Orpah/orpah-client-demo/docs/carrier-connections.md

# 载板连接表（= 原理图的「内容」✓）

> 用途：**画原理图之前先把它写死** ✓ —— 图上每条线都应当能在这张表里找到 ✓。
> 表里**只写「谁接谁」** ✗、**不写引脚号**：引脚号以 **Fritzing 部件**为准 ✓（抄两遍必然漂移 ✗）。
> 画完的核对口径 = **`tools/fzz_nets.py`** ✓（本仓台架那 5 张图就是这么逐网核的 ✓）。
> 状态：**草案** ✗（未上机）；标「待核」的**先查再画** ✓。
> 上游 = `carrier-board-spec.md` §2/§3/§4b-2 ✓。

## 1. 网络清单（画图时**照抄名字** ✓）

| 网络 | 含义 | 谁挂 |
|---|---|---|
| `3V3` | 主轨（前端稳压输出） | U1 的 `VDD`/`VDDA` ✓、U2 `VCC` ✓、D1 的限流电阻 ✓、I2C 上拉 R1/R2 ✓、J1（给模组）✓、J2（对外）✓、前端 `OUTPUT` ✓、前端 `EN`/`V_EN` ✓ |
| `GND` | 地 | 全部 ✓（含 U1 的**裸露焊盘 `VSS`** ✓ —— 部件里它**独立成网** ✗ ⇒ 画板时必须**特意连到 GND** ✓） |
| `VBAT` | 储能节点 | 前端 `BAT` ＋ BT1 正极 ✓ |
| `VBUS_IN` | 取能输入（光伏正极） | 前端 `INPUT` ＋ 预留取能接口 ✓ |
| `SDA` / `SCL` | I2C2 ↔ SE | U1 `PB11`/`PB10` ✓、U2 `pin5`/`pin6` ✓、R1/R2 上拉到 `3V3` ✓、J2（产线配 SE ✓） |
| `MOD_RX` / `MOD_TX` | MCU ↔ 模组 UART（HGIC 帧） | U1 `PA2`/`PA3` ✓ ↔ J1 ✓（**交叉**：MCU TX → 模组 RX ✓） |
| `CON_RX` / `CON_TX` | 控制台 `USART1` | U1 `PA9`/`PA10` ✓ ↔ J2 ✓ |
| `SWDIO` / `SWCLK` | SWD 烧录 | U1 `PA13`/`PA14` ✓ ↔ J3 ✓ |
| `LED_HB` | 心跳灯 | U1 `PA15` ✓ → R3 → D1 → `3V3` ✓（**低电平点亮** ✓） |
| `VBAT_OK` | 前端「储能可用」信号 | 前端 `V_OK` ✓ → U1 一只 GPIO ✓（**输入** ✓） |
| `VOUT_EN` | 前端 buck 使能 | **硬接 `3V3`（常开）** ✓ ⇒ ★ **别交给 MCU 关** ✗（MCU 自己吃这条轨 ⇒ 关了没人能再开 ✗，见 §3 第 4 条 ✓） |

## 2. 器件逐脚

### U1 = `CH32V203F8U6`（脚号/脚名照部件 `fritzing-parts-langhua/svg/CH32V203F8U6/part.CH32V203F8U6.fzp` ✓）
| 脚（功能名） | 接 | 备注 |
|---|---|---|
| `PA2` | `MOD_RX` → J1 ✓ | 模组数据口，HGIC 帧、115200 8N1 ✓ |
| `PA3` | `MOD_TX` ← J1 ✓ | 同上（**交叉** ✓） |
| `PA9` / `PA10` | `CON_TX` / `CON_RX` → J2 ✓ | 控制台 ✓ |
| `PB10` / `PB11` | `SCL` / `SDA` ✓ | `I2C2` ✓（★ 这个封装**没有 `I2C1`** ✗） |
| `PA13` / `PA14` | `SWDIO` / `SWCLK` → J3 ✓ | ★ **没有 `NRST`/`BOOT0`** ✗（复位 = 断电重上电 ✓） |
| ★ **心跳灯（要换脚 ✗）** | `LED_HB` ✓ | ★ 台架用 `PA15` ✓，但 **F8U6 封装上 `PA15` 没引出** ✗（2026-10-13 从部件 `.fzp` 的 21 只脚里读出来的 ✓）⇒ 载板**建议 `PB0`** ✓；**固件要跟着加"板档"开关** ✗（现在 `board.h` 写死 PA15 ✓） |
| ★ **用哪只脚：`PA0/WKUP`**（建议 ✓） | `VBAT_OK` ← 前端 ✓ | **输入** ✓；选它的额外好处 = 带 **WKUP** ✓（低功耗唤醒能用 ✓） |
| `VDD`（★ 部件里**只有一只** ✓ —— **没有单独的 `VDDA`** ✗） | `3V3` ✓ | ＋ **一只 100 nF 就近去耦** ✓（值待按手册核 ✗） |
| `VSS` ＋ 裸露焊盘 `VSS` | `GND` ✓ | 裸露焊盘**必须特意连** ✓ |

### U2 = `ATECC608B`（SOIC-8 ✓）
| 脚 | 接 | 备注 |
|---|---|---|
| `8 VCC` | `3V3` ✓ | ＋ 100 nF 去耦 ✗（**值待核** ✗） |
| `4 GND` | `GND` ✓ | |
| `5 SDA` / `6 SCL` | `SDA` / `SCL` ✓ | 开漏 ⇒ **必须有 4.7 k 上拉** ✓ |
| `1 / 2 / 3 / 7` | **不接** ✓ | |

### 其它
- **R1 / R2 = 4.7 kΩ**：`3V3` ↔ `SDA` / `SCL` ✓
- **R3 ＋ D1（心跳灯）**：`3V3` → R3（台架是 **10 kΩ** ✓）→ D1（蓝）→ `PA15` ✓
- **BT1 = 超级电容 5.5 V 组件**：正极 → `VBAT` ✓、负极 → `GND` ✓（★ **不装 CR2032/LIR2032** ✗）
- **J4 = 前端模块 `CJMCU-2557`**（排针 ✓，**丝印名照抄** ✓）：`INPUT`→`VBUS_IN` ✓、`GND`→`GND` ✓、
  `BAT`→`VBAT` ✓、`OUTPUT`→`3V3` ✓、`V_OK`→`VBAT_OK` ✓、`V_EN`→`3V3` ✓、`EN`→`3V3` ✓
- **J1 = 模组接口**（4 脚 ✓）：`1 = 3V3`、`2 = GND`、`3 = MOD_RX`、`4 = MOD_TX` ✓
  （第一版接 **TX-AH EVB 子板** ✓；**裸模块焊盘**留板上**不装** ✗）
- **J2 = 台架/产线排针**（6 脚 ✓）：`1 = 3V3`、`2 = GND`、`3 = SDA`、`4 = SCL`、`5 = CON_TX`、`6 = CON_RX` ✓
- **J3 = SWD**（4 脚 ✓）：`1 = 3V3`、`2 = GND`、`3 = SWDIO`、`4 = SWCLK` ✓

## 3. 画图/接线时必须照做的 5 条（都是踩过的 ✗）

1. **地要连成一片** ✓（台架踩过：`nano GND ↔ CH347F GND` 实测 **1.5 kΩ** ⇒ 虚接 ✗ ⇒ SE 永远 NACK ✗）；
2. **I2C 上拉不能省** ✓（4.7 k ×2 到 `3V3` ✓）；★ 台架上还并着 CH347F 的 `P5`（**两个主机一条总线** ✗）
   ⇒ **载板上不要**这种接法 ✗（真凶 ⑤ ✓）；
3. **模组轨就近去耦 ＋ 大电容** ✓：buck 只有 93～110 mA ⇒ 发射峰值**靠电容顶** ✗
   （容量 **等 F-11 §2b 量完再定** ✗）；
4. **`VOUT_EN` 硬接高** ✓（别交给 MCU ✗ —— 关了自己就死、没谁能再开 ✗）；
5. **裸露焊盘 `VSS` 特意连 GND** ✓（部件里它独立成网 ✗）。

## 4. 待核（画前必查 ✗）

- **裸模块**焊盘号 ↔ 台架丝印 `A10`/`A11` 的对应 ✓（第一版不用裸模块 ⇒ **不阻塞** ✓）；
- `U1` 的**电源脚个数**与去耦值 ✓（照数据手册 ＋ 本库部件 ✓）；
- `ATECC608B` 去耦值 ✓、`R3` 阻值 ✓；
- **`C_STORE` / 3V3 大电容**的容量 ✗（等 F-11 §2b ✓）；
- **`CJMCU-2557` 的 `VOUT` / `VBAT_OV` 实际设定** ✗（见 `carrier-board-spec.md` §4b-2 ✓）。

## 5. 在 Fritzing 里画（照着点 ✓）

★ **为什么这一步在 Fritzing 里点、不由我生成 `.fzz`** ✗：Fritzing 的 sketch 要求**每个元件/走线三视图都写全**
（本库实测 ✓：Fritzing 自己的 **4149** 条走线里 **4148** 条是三视图 ✓），而且**结构不合它口味就静默忽略** ✗
（记过：只有 `pcbView` 的 129 条走线**整组不被认** ✗）⇒ 脚本从零生成风险高 ✗；
而在 Fritzing 里**点两个脚就自动布线** ✓ ⇒ 手画反而快 ✓。
**我负责的半个 = 内容定死（本文）＋ 画完逐网核对** ✓。

**步骤**（约 15 分钟 ✓）
1. 新建 sketch ✓，切到 **原理图视图**（Schematic ✓）；
2. 从元件箱拖 3 个元件（**都在里面了** ✓ —— 2026-10-13 `tools/check_deploy.py` rc=0 ✓）：
   `CH32V203F8U6` ✓、`ATECC608B` ✓、`TX-AH-R900PNR`（接 EVB 子板时它是接口件 ✓）；
3. 再拖出：**4.7 k 电阻 ×2** ✓、**R3 ×1** ✓、**LED ×1** ✓、**BT1（超容/电池符号 ✓）×1** ✓、
   **排针 ×3**（`J1` 模组 / `J2` 台架产线 / `J3` SWD ✓）、**前端排针 ×1**（`CJMCU-2557` 用 ✓）、
   网标签若干（`NetLabel-Pad` ✓）；
4. **按 §1/§2 的表连线** ✓（自动布线即可 ✓；这只是原理图，线色不计较 ✓）；
5. ★ **别漏两条** ✗：① **U1 的裸鳲焊盘 `VSS` 单独连到 `GND`** ✓（部件里它独立成网 ✗）；
   ② **前端 `VOUT_EN`（丝印 `V_EN`）/ `EN` 直接接 `3V3`** ✓（**不接 MCU** ✓）；
6. 存成 **`hardware/carrier/carrier-board.fzz`** ✓（目录要建 ✓）；需要就同时导出 `.svg` ✓
   —— **README 要嵌图** ✓（AGENTS §9 ✓）；
7. **画完告诉我** ⇒ 我把它登记进 `tools/fzz_nets.py` 的期望表 ✓，然后按 §1/§2 **逐网核对** ✓
   （判定 = 一条命令、无 `MISSING`/`EXTRA` ✓；与台架那 5 张图同一口径 ✓）。

## 6. 项目数据模块（库仓那套工具用 ✓）

★ 载板的「项目数据」= **`hardware/carrier/carrier_nets.py`** ✓（2026-10-13 建 ✓）：
`NETS`（**15 张网**；脚名是**从 `.fzp` 读出来的真名** ✗ 不是猜的 ✓）、`POWER`、
`COLOR`（**只取官方 13 色** ✓ ⇒ 两张网必须共用 ✗）。

★ 有了它，库仓（`fritzing-parts-langhua/tools/`）那套通用工具**直接能用在载板上** ✓
（与像素板同一套 ✓）：
```
py -3.13 <库仓>\tools\check_netlist.py <草图.fzz> --nets=<本岔>\carrier_nets.py
py -3.13 <库仓>\tools\render_sch.py   <草图.fzz> <出图.png>
py -3.13 <库仓>\tools\sch_metrics.py  <草图.fzz>
py -3.13 <库仓>\tools\sch_straighten.py <草图.fzz> [--apply]
```
⚠ `EXPECT`（核对器的**期望表**）**待草图存在后再照 `pixel_nets.py` 的写法补** ✗ ——
现在补 = 凭空造一份期望 ✗（表要与图上真有的脚一一对得上才有意义 ✓）。

## 7. 画图管线（2026-10-13 查清：有现成的 ✓）

★ 结论：**不用我从零造** ✗ —— `F:\git\AuroraTessellation-NFC\hardware\pixel\` 里有一整条流水线 ✓
（用户 2026-10-13 把这个仓加进工作区才看见 ✓）：

| 步 | 工具 | 干什么 |
|---|---|---|
| ① 出脚位几何 | **库仓** `render_sch.py <草图.fzz> <出图> --pins-out pins_ref.py` ✓ | 吐 **`PINS[mi][cid]=(dx,dy)`**（各脚相对零件锚点 ✓）/ **`BOX[mi]`**（本体框 ✓）/ `LAB` ✓ —— ★ **对 Fritzing 自己导出验平 Δ≤0.0004 单位** ✓ ⇒ **脚位不用我自己解** ✓ |
| ② 自动摆位 | 项目侧 **`gen_schematic_layout3.py <源.fzz> <出.fzz> --pins pins_ref.py`** ✓ | 数据驱动摆位（本体居中 ✓、相邻脚同高 ✓、间隙 2 格 ✓）；**只碰 `schematicView`** ✓；`--by-bb` 可按面包板排布摆 ✓ |
| ③ 自动布线 | 项目侧 **`gen_schematic_wires.py`** ✓（9378 行 ✓、**开关很多** ✓） | 正交折线 ✓、电源轨 ✓、竖直车道 ✓、**网标签** ✓、**接地符号** ✓、抽出重排 ✓；闸门一堆（贴脚 0 ✓、跨网假接头 0 ✓、线↔线净距 ✓、本体闸门 ✓） |
| ④ 复核 | 库仓 `render_sch` / `sch_metrics` / `check_netlist` / `sch_straighten` ✓ | 出图 ＋ 判据 ✓、**独立**量尺 ✓、逐网核对 ✓、该横平竖直的线 ✓ |

★★ **唯一还缺的一步 = 造一份「含元件、零导线」的源草图** ✗ —— 上面 ②③ 都要求它先存在 ✓
（像素板那份是**在 Fritzing 里画的** ✓）⇒ **这一步由我脚本补上** ✓（用库件造实例 ✓），
然后 ②③④ 直接跑 ✓。

★ 已实测（2026-10-13 ✓）：拿台架草图跑 ① ⇒ **rc=0**，产出 4 件的 `PINS`/`BOX`/`LAB` ✓；
它自带的判据链同时报了「交叉 0 / 穿体 0 / 假接头 0 / 跨网擦身 0」✓（该图本来就没画原理图线 ✓）。

★ 布线器怎么搬过来 ✓：它**唯一项目专属的东西 = 文件顶部的 `NETS`** ✓ ⇒ 换成
`hardware/carrier/carrier_nets.py` 的 15 张网 ✓，其余开关用 CLI 调 ✓（`--ratio` 用
`render_sch` 出的尺子 = **1.0** ✓；对 Fritzing 导出的 svg 才是 1.25 ✓）。

## 8. 源草图生成器（2026-10-13 建 ✓：管线那唯一的缺口补上了 ✓）

**`hardware/carrier/carrier_board.py`** ✓ —— 造「**含元件、零导线**」的源草图 ✓：
- 骨架从**现成的台架草图**抄 ✓（只留它的 `<boards>` 与板框件 `PCB1` ✓，别的实例与全部悬空
  `<connects>` 一律删掉 ✓）⇒ Fritzing 要的外层结构是**它自己写的形状** ✓，不是我编的 ✗；
- 两趟摆位 ✓：① 粗摆（固定间距 ✓ 不必先知道尺寸 ✓）⇒ ② 跑库仓 `render_sch.py --pins-out`
  拿到**本体框** ✓ 再按 `GAP` 精摆 ✓（几何来自工具 ✓，不是我拍的数 ✓）。
  ★ `GAP` 现在是 **11 格 ≈ 22.4 mm** ✓（2026-10-14 逐档量出来的 ✓；它那条注释里记着
  **为什么从 2 → 4 → 6 → 12 → 11 格**，以及 **12 格 + 同 `--choffs` 也达标** 的对比 ✓）；
  ★★ **出交付件的整条命令**（含 `--choffs 7.3,12,22,34` 与 `--no-mst-merge --no-mst-shape`
  这两个**必须**的开关 ✓）写在 `carrier_board.py` 的**用法段**里 ✓ —— 以它为准 ✗，别凭记忆重建 ✗；
- 件一律用**库件** ✓；★ **核心件（Fritzing 自带）也能用** ✓，但 `path` **必须写绝对路径**
  （`…/Fritzing/fritzing-parts/core/<文件>.fzp` ✓）✗ —— 写成 Fritzing 内部记号
  `:/resources/parts/core/…` 我们的工具链**读不到** ✗（`part_measure.py` 明写：core 件不在 `.fzz` 里
  ⇒ 按实例给的**绝对路径**读它的 `.fzp` ✓）。实测：换绝对路径后 **17/17 全认** ✓。

**产物** ✓：`hardware/carrier/carrier-board.fzz`（**11 件 / 零导线** ✓，`render_sch --pins-out` rc=0 ✓）；
**交付件** = `hardware/carrier/carrier-schematic.{fzz,png,svg}` ✓（2026-10-14 定为 `c1` 版：
贴脚 1 / 交叉 54 / 拒画 0 / 导线重叠 0 / `check_netlist` ✓ 14/14 ✓）；
临时件在 `hardware/carrier/_work/`（不入库 ✓）。

**已解决** ✓：`D1` 改用核心件的 **SMD 0603 LED** ✓、`BT1` 改用核心件的 **goldcap（超容）** ✓
—— 都是真件 ✓，不再是占位 ✗。

**还差一样：4/6/7 脚的排针件** ✗（`J1`/`J3` 4 脚 ✓、`J2` 6 脚 ✓、`J4` 7 脚 ✓）：
- 库里没有 ✗；
- Fritzing 那只「**Pin Header**」是**运行时生成的泛用件** ✗ —— `fritzing-parts/core/` 里 **没有它的 `.fzp`** ✗
  （1781 个 fzp 里数过 ✓）⇒ **能用它的只有 Fritzing 自己** ✗，我们的工具链（`render_sch --pins-out`）
  **量不到它的脚** ✗ ⇒ 排版/布线/判据全断 ✗。
- ⇒ 两条出路 ✓：① **你在 Fritzing 里放好 4/6/7 脚 Pin Header 并另存** ✓（判据 = 存出来的 `.fzz` 里
  **多出** `part.*.fzp` ⇒ 说明它被打进包了 ✓ 我就能读 ✓）；② **我在库仓做一套「1×N 排针」件** ✓
  （一劳永逸 ✓，以后每块板都用得上 ✓；改公共元件库、按规矩先跟你对齐 ✓）。

**位号 0 个** ✗（渲染器报的）：我造的实例**没有 `<titleGeometry>`** ✓（Fritzing 自己的实例里有 ✓）
⇒ 交给布线器 ✓ 去摆 ✓（它的「布完线再摆一遍位号」**缺省就是开的** ✓，不另写一份 ✗）。
