Orpah/orpah-client-demo/hardware/carrier/carrier-pcb.png

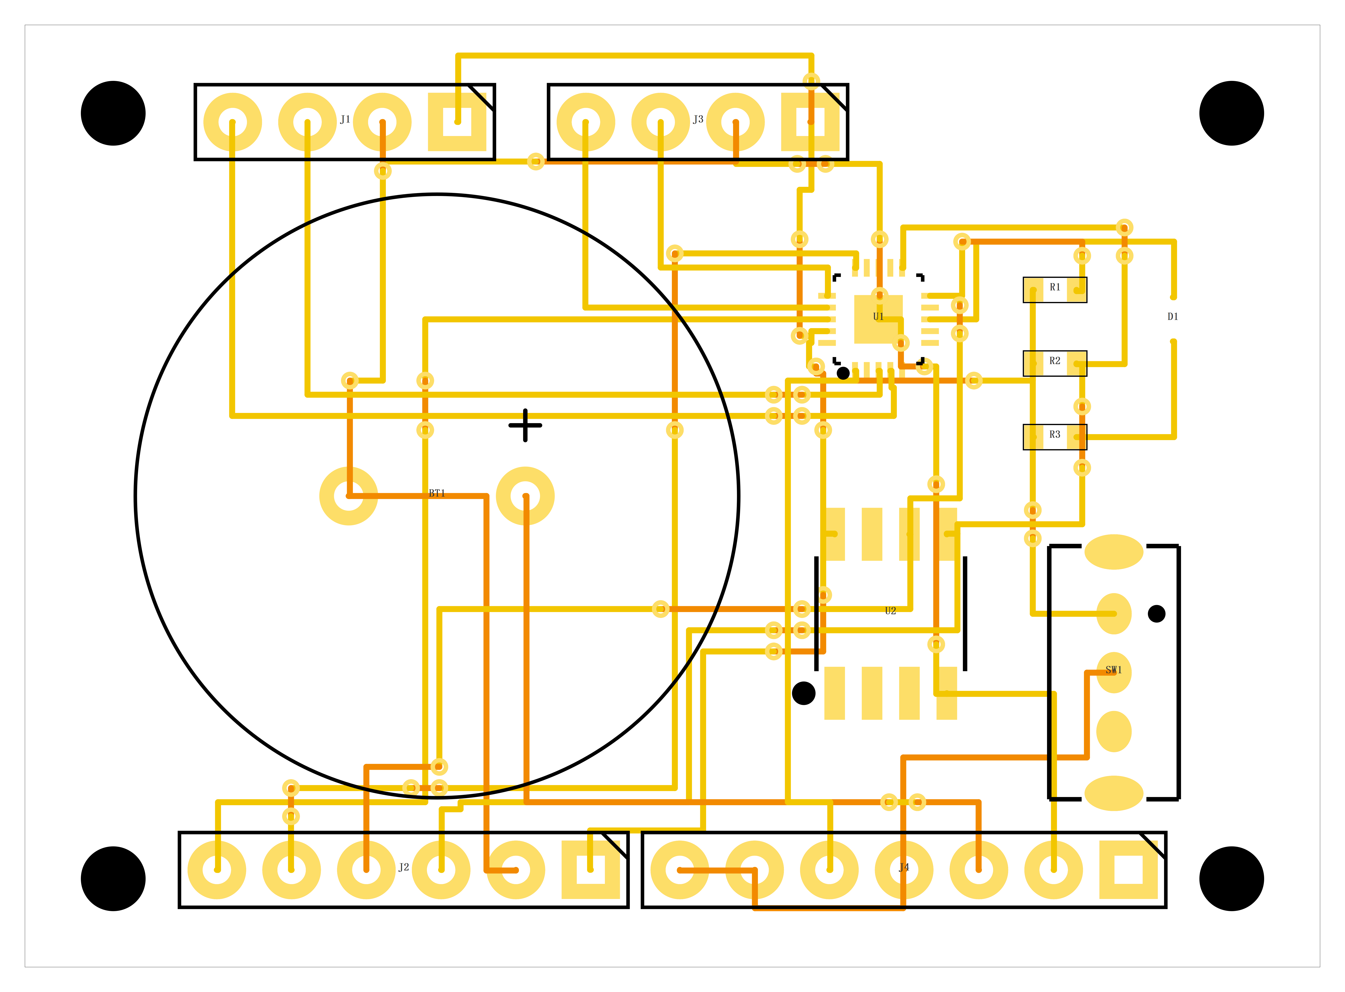
hardware/carrier/carrier-pcb.png
