Orpah/orpah-client-demo/hardware/carrier/carrier-schematic.png

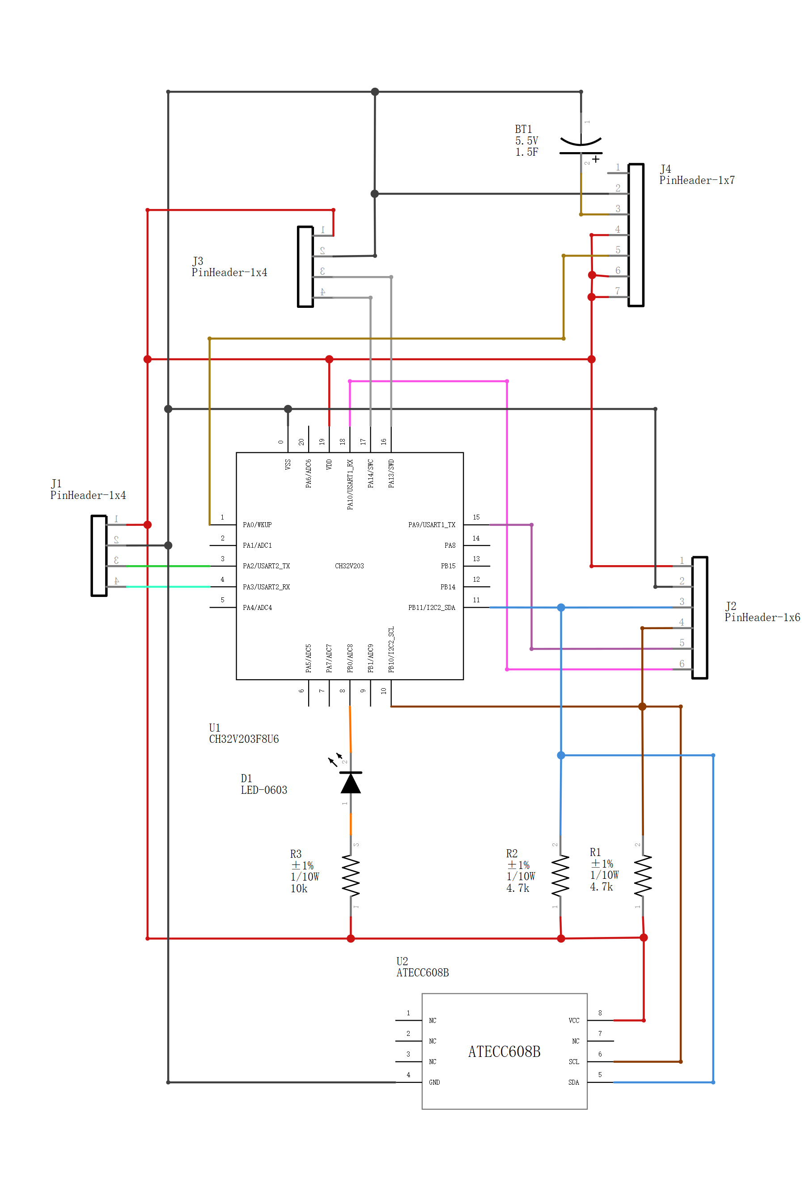
hardware/carrier/carrier-schematic.png
