Orpah/orpah-client-demo/proto/test_vectors_atecc.txt

# proto/test_vectors_atecc.txt —— 由 proto/run_cross_test.py --refresh 生成，**勿手改**
# 来源（单一源）：CryptoAuthLib `lib/calib/calib_command.h`（ATCA_RANDOM=0x1B、模式、包长）
#   + `lib/calib/calib_random.c`（响应的 count 检查）—— 我们那份摘要手册无命令集（需 NDA）
# 列：<kind><TAB><a1><TAB><a2><TAB><a3><TAB><out>
#   cmd  : a1=mode a2=with_crc(0/1) a3=-        out = 命令包-hex（count 在头、CRC 小端在尾）
#   resp : a1=完整响应-hex a2=a3=-              out = OK:<32B hex> | ERR:<码>
#     （ERR 码同 C 侧 ATECC_MSG_E_*：-2 = 长度/ count 不符、-3 = CRC 不符）
#   errpkt: a1=4字节包-hex a2=a3=-              out = 0x<状态>:<名字> | not-errpkt
#     （状态名 = `atecc_msg_status_name()`；两册逐字相同，措辞照 isATCAError()）
# 覆盖：两种模式 × 带/不带 CRC、响应 33/35 B（count **只占 1 字节**）、CRC 改一位、
#       长度截短、count 与长度矛盾、以及 4 字节错误包（含 2026-10-10 台架**实测**的
#       `04 11 33 43`（唤醒）与 `04 FF 01 42`（CRC/通讯错））
cmd	0	0	-	051b000000
cmd	0	1	-	071b00000024cd
cmd	1	0	-	051b010000
cmd	1	1	-	071b0100002747
resp	21000102030405060708090a0b0c0d0e0f101112131415161718191a1b1c1d1e1f	-	-	OK:000102030405060708090a0b0c0d0e0f101112131415161718191a1b1c1d1e1f
resp	23000102030405060708090a0b0c0d0e0f101112131415161718191a1b1c1d1e1f70fa	-	-	OK:000102030405060708090a0b0c0d0e0f101112131415161718191a1b1c1d1e1f
resp	23000102030405060708090a0b0c0d0e0f101112131415161718191a1b1c1d1e1f71fa	-	-	ERR:-3
resp	21000102030405060708090a0b0c0d0e0f101112131415161718191a1b1c1d1e	-	-	ERR:-2
resp	22000102030405060708090a0b0c0d0e0f101112131415161718191a1b1c1d1e1f	-	-	ERR:-2
errpkt	04113343	-	-	0x11:woke up
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
respsha	23000102030405060708090a0b0c0d0e0f101112131415161718191a1b1c1d1e1f71fa	-	-	ERR:-3
respsha	21000102030405060708090a0b0c0d0e0f101112131415161718191a1b1c1d1e	-	-	ERR:-2
respsha	22000102030405060708090a0b0c0d0e0f101112131415161718191a1b1c1d1e1f	-	-	ERR:-2
