Orpah/orpah-client-demo/proto/test_vectors_id_frame.txt

# proto/test_vectors_id_frame.txt —— 由 proto/run_cross_test.py --refresh 生成，**勿手改**
# 来源（单一源）：上游 Device.report() + build_id_report() + build_eth_frame()
#   （= 设备侧那条流水线的期望结果；C 侧同一份流水线在 proto/id_build.c，两侧共用）
# 列：<kind><TAB><sn><TAB><gen><TAB><mode><TAB><entropy><TAB><ctr><TAB><level><TAB><reason>
#     <TAB><frame-hex><TAB><firmware|->
#   mode = §8.2 故障注入（auto/sign_fail/se_fail/no_key）；nonce 由上面那张表的公式给
# 覆盖：L0/L1/L2/L3 四种级别 + 带与不带 firmware 字段
frame	CN-WH01-9AF3C1D2	1	auto	43981	1	0	normal	ffffffffffff4a065900000188b57b2276223a312c2274797065223a224f525041482d49442d5245504f5254222c227473223a302c22736e223a22434e2d574830312d3941463343314432222c227265706f7274223a7b22686472223a7b22747970223a226f727061682d69642d7265706f7274222c22766572223a312c22616c67223a224553323536222c226c6576656c223a307d2c227061796c6f6164223a7b22736e223a22434e2d574830312d3941463343314432222c227473223a302c226e6f6e6365223a223436363141313943443032423031323338324539463441373037463633414239222c227365656e5f726f7574657273223a5b5d2c22636170223a7b22727463223a66616c73657d7d2c22736967223a227477353662374a6457433766314a44504d48504f446b625354524552425342715379447061306f3971786e444363385f35714471687a686e78446132474c484e5f565f46324f5f576e4f716d4f3031336d515a5a6967227d7d	-
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
