Orpah/orpah-client-demo/proto/test_vectors_id_report.txt

# proto/test_vectors_id_report.txt —— 由 proto/run_cross_test.py --refresh 生成，**勿手改**
# 来源（单一源）：orpah_id.Device.report() + orpah_proto.encode_msg()/build_id_report()
# 列：<sn><TAB><ts><TAB><nonce><TAB><level><TAB><key-hex><TAB><battery|->
#     <TAB><caprtc|-><TAB><firmware|-><TAB><report-hex><TAB><envelope-hex>
#   ⚠ key-hex 的含义**按 level 分**：level 0 = P-256 私钥 d（32B 大端）；level 1/2 = HMAC 密钥；level 3 = -
#   ⚠ level 0 的签名用 **RFC 6979 确定性 k**（参考实现默认随机 k，那样两侧逐字节比不了）；
#     算法本身的独立证据 = RFC 6979 §A.2.5 官方向量 + OpenSSL 验签 + 上游 verify_report 接受
# 覆盖：level 0（ES256）/ level 1、2（HS256 降级链）/ level 3（none，不签名）/ 无 cap 与带 cap+battery+firmware
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
