Orpah/orpah-client-demo/proto/test_vectors_ecdsa.txt

# proto/test_vectors_ecdsa.txt —— 由 proto/run_cross_test.py --refresh 生成，**勿手改**
# 来源（单一源）：RFC 6979 §3.2 的 k（本仓 Python 侧第二实现）+
#                 OpenSSL（cryptography）算 k*G 得 r，s 用整数算术（都不经过本仓 C 代码）
# 列：<label><TAB><d><TAB><h1><TAB><k><TAB><r><TAB><s>（全部小写十六进制，除 label 外各 64 字符）
#   label 只是给人看的（RFC 那份夹具不同：那里 label 必须是消息本身）
#   h1    = 直接给哈希（32 B）—— 这样才构造得出 h1 >= n 的分支
#   覆盖：演示私钥（SN 派生）× 3 条消息、h1 边界（0/1/n-1/n/n+0x1234/0xff..ff）、
#         私钥边界（1/2/n-1）+ 定种子随机
# ⚠ 静态官方向量在 test_vectors_ecdsa_rfc6979.txt（**不由 --refresh 生成**，别删别改）
demo:CN-WH01-9AF3C1D2:1:sample	e0552315cc24f7f007f7e9541fc3dc7a91e88a1b39185b1bd5b49fa525c201af	af2bdbe1aa9b6ec1e2ade1d694f41fc71a831d0268e9891562113d8a62add1bf	c35010fa9c21ae5c5335ff0bfceab35c08ea7fc73c21c8361ee8e900d52da686	8056bfc5b52d800a5ae7d57af8971c6e8615b0381f817f159ecffb08e41c8def	5d3aa8e685efe9a7524efc9813672e0f93810f3814da584a89d4d1dc548c2915
demo:CN-WH01-9AF3C1D2:1:test	e0552315cc24f7f007f7e9541fc3dc7a91e88a1b39185b1bd5b49fa525c201af	9f86d081884c7d659a2feaa0c55ad015a3bf4f1b2b0b822cd15d6c15b0f00a08	963e2c44ce2e23debca4b20217aa46624e16f13a7c24e4272e54705d55f03d02	ff212b3ca0b54d5e920324d5f3974b66ee1eb49a2d05a8afec2c4c5d068d9ecf	3682545e8628b1d9e1004a1ebc2182fb0230d1e35d42aeea3ddbcb26d76bb9de
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
