Orpah/orpah-client-demo/proto/test_vectors_ecdsa_rfc6979.txt

# proto/test_vectors_ecdsa_rfc6979.txt —— ★ **静态夹具：不由 --refresh 生成，脚本不许改写它**
# 来源：RFC 6979 §A.2.5「ECDSA, 256 Bits (Prime Field)」（= NIST P-256）
#       2026-09-20 取自 https://www.rfc-editor.org/rfc/rfc6979.txt
# 列：<label>	<d>	<h1>	<k>	<r>	<s>   （全部小写十六进制，各 64 字符）
#   label = RFC 里的输入消息（UTF-8）⇒ **h1 必须等于 SHA-256(label 的 UTF-8 字节)**
#           （这一条由 run_cross_test.py 现算核对：抄错 message 也会被抓到）
#   d     = RFC 的私钥 x；它派生的公钥必须等于 RFC 的 Ux/Uy
#           Ux = 60fed4ba255a9d31c961eb74c6356d68c049b8923b61fa6ce669622e60f29fb6
#           Uy = 7903fe1008b8bc99a41ae9e95628bc64f2f1b20c2d7e9f5177a3c294d4462299
#   h1    = SHA-256(message)；qlen=256=hlen ⇒ bits2int 就是"按大端读成整数"，无截断
#   k     = RFC 6979 确定性派生出的 k；r/s = 该 k 下的签名
#
# 为什么**不能**由脚本生成（--refresh 会跳过它）：RFC 给的是确定性 k，而 OpenSSL 的
#   签名接口只吐随机 k 的签名（本机也没有 ecdsa 库）⇒ 这组只能手工录入。
# 那凭什么信它？三条**互相独立**的验证都过才允许改这张表（见 proto/README.md）：
#   ① OpenSSL 验签 (r,s) 通过（证明 r,s 真是 RFC 的值，不是抄串行）
#   ② k 由 (r,s) 反推 —— k = (h + d·r)·s⁻¹ mod n（签名方程保证唯一）——等于表中的 k
#   ③ 本仓**自己的** Python RFC 6979 实现也与表中 k 相等
#   （2026-09-20 实测：①②③ 对两行全部成立；本机没有 ecdsa 库，所以 ③ 是本仓自写的那份）
#
# ★ 注意 s **不是** low-s 归一化的（下面 "sample" 那条 s > n/2）⇒ 实现里**不许**对 s
#   做归一化，否则与官方夹具不一致。验签方本来就两种都接受。
sample	c9afa9d845ba75166b5c215767b1d6934e50c3db36e89b127b8a622b120f6721	af2bdbe1aa9b6ec1e2ade1d694f41fc71a831d0268e9891562113d8a62add1bf	a6e3c57dd01abe90086538398355dd4c3b17aa873382b0f24d6129493d8aad60	efd48b2aacb6a8fd1140dd9cd45e81d69d2c877b56aaf991c34d0ea84eaf3716	f7cb1c942d657c41d436c7a1b6e29f65f3e900dbb9aff4064dc4ab2f843acda8
test	c9afa9d845ba75166b5c215767b1d6934e50c3db36e89b127b8a622b120f6721	9f86d081884c7d659a2feaa0c55ad015a3bf4f1b2b0b822cd15d6c15b0f00a08	d16b6ae827f17175e040871a1c7ec3500192c4c92677336ec2537acaee0008e0	f1abb023518351cd71d881567b1ea663ed3efcf6c5132b354f28d3b0b7d38367	019f4113742a2b14bd25926b49c649155f267e60d3814b4c0cc84250e46f0083
