Orpah/orpah-client-demo/proto/test_vectors_p256.txt

# proto/test_vectors_p256.txt —— 由 proto/run_cross_test.py --refresh 生成，**勿手改**
# 来源（单一源）：上游 orpah_id.derive_demo_privkey(sn, gen) 的私钥 d
#                 + Python cryptography/OpenSSL 的 X962 未压缩公钥（04||X||Y）
# 列：<kind><TAB><a1><TAB><a2><TAB><d-hex><TAB><pub65-hex>
#   sn : a1=SN a2=gen —— d 由 C 自己按同式派生（这一列同时钉住派生规则）
#   d  : a1=d-hex（**不取模**，但必须 < 2^256 = 64 个十六进制字符）a2=-
#        覆盖 n-1（= -G）与 n+1 / n+0x1234（未归约的标量，ladder 要能吃）
# 为什么这样测：p/a/b/Gx/Gy/n、Montgomery 乘、点运算、标量乘 —— 任一处错，公钥就不同
sn	CN-WH01-9AF3C1D2	1	e0552315cc24f7f007f7e9541fc3dc7a91e88a1b39185b1bd5b49fa525c201af	04c929c768df1e0d53be4216a710077a734a4f9b87b6ae8fa73ec773105c84e5d566612da9b40df61ad0ebb096a2515d60e0e83c48f922dd7db6a4d453feefab49
sn	CN-AB01-00000001	1	a6b806a08cdb56384aa8767de55c9408eda94aa71bb0443fe8e58ff694525110	049637bf25e72dedde277412814bf15de539ba9d507bd591a423164ecab39bd082c3dfd4c0733dc7d1367bce696e81cdc8ae2272143e458e61b746c909f1581949
sn	CN-ZZ99-ZZZZZZZZ	1	dd08985a256d7be9e84aae896a566f84203a25e58743e9bd1aed139d84f8d9ce	0412f6c0510eaba29cf066281efbc811a70cd186eaddf8787bea50c553376257c3b778c8578a03bccf8b0d3d733460dd4fd6c9662836a3cd6852810f56845694b6
sn	CN-WH01-9AF3C1D2	2	bd4f7b866ca6f1f0ffaa13726e7937159b1ce983a9ab366443834d761e1c2bc0	042947e757bd8957a79ddf2c9cb68e28e312e1d361ae66fba5d4c11f2ebe64cad1804f401853b0020a49c6ff3d33e4b7b12b61a3276d92ec7e40d903a4745831f7
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
d	d715cb996dec0001404e321b300792a0119232201fd974f364bf76a2dde79c1a	-	d715cb996dec0001404e321b300792a0119232201fd974f364bf76a2dde79c1a	0447965ce2b2476ace9c90339d49388074b2cb80ac5c51d29749a0d89a910c3e688c46703a36c31600600ed807b09e16c5798b80b0d0fc2805233209bdb0a15349
