Orpah/orpah-client-demo/proto/test_vectors_hgic.txt

# proto/test_vectors_hgic.txt —— 由 proto/run_cross_test.py --refresh 生成，**勿手改**
# 来源（单一源）：**本仓** tools/txah_hgic.py（= 模组 SDK hgic.h/uart_bus.c + 真机实测）
# 列：<kind><TAB><a1><TAB><a2><TAB><a3><TAB><a4><TAB><a5><TAB><a6><TAB><frame-hex>
#   hdr : a1=magic(hex) a2=type a3=ifidx a4=flags a5=cookie a6=载荷-hex|-
#   frm2: a1=以太帧-hex|- a2=cookie a3..a6=-          （lean=True ⇒ FRM2）
#   cmd : a1=cmd_id a2=参数-hex|- a3=cookie a4..a6=-     （id>255 走 CMD2）
# 覆盖：长度上下界 8/4096、ifidx:4|flags:4 打包、cookie 0/32767、256 附近的 CMD↔CMD2 分界
hdr	1A2B	9	0	0	0	-	2b1a090008000000
hdr	1A2B	9	5	10	4660	-	2b1a095a08003412
hdr	2B1A	4	15	15	32767	aa55	1a2b04ff0a00ff7faa55
hdr	0000	0	1	2	1	00ff	000000120a00010000ff
hdr	1A2B	9	0	0	0	aaaaaaaaaaaaaaaaaaaaaaaaaaaaaaaaaaaaaaaaaaaaaaaaaaaaaaaaaaaaaaaaaaaaaaaaaaaaaaaaaaaaaaaaaaaaaaaaaaaaaaaaaaaaaaaaaaaaaaaaaaaaaaaaaaaaaaaaaaaaaaaaaaaaaaaaaaaaaaaaaaaaaaaaaaaaaaaaaaaaaaaaaaaaaaaaaaaaaaaaaaaaaaaaaaaaaaaaaaaaaaaaaaaaaaaaaaaaaaaaaaaaaaaaaaaaaaaaaaaaaaaaaaaaaaaaaaaaaaaaaaaaaaaaaaaaaaaaaaaaaaaaaaaaaaaaaaaaaaaaaaaaaaaaaaaaaaaaaaaaaaaaaaaaaaaaaaaaaaaaaaaaaaaaaaaaaaaaaaaaaaaaaaaaaaaaaaaaaaaaaaaaaaaaaaaaaaaaaaaaaaaaaaaaaaaaaaaaaaaaaaaaaaaaaaaaaaaaaaaaaaaaaaaaaaaaaaaaaaaaaaaaaaaaaaaaaaaaaaaaaaaaaaaaaaaaaaaaaaaaaaaaaaaaaaaaaaaaaaaaaaaaaaaaaaaaaaaaaaaaaaaaaaaaaaaaaaaaaaaaaaaaaaaaaaaaaaaaaaaaaaaaaaaaaaaaaaaaaaaaaaaaaaaaaaaaaaaaaaaaaaaaaaaaaaaaaaaaaaaaaaaaaaaaaaaaaaaaaaaaaaaaaaaaaaaaaaaaaaaaaaaaaaaaaaaaaaaaaaaaaaaaaaaaaaaaaaaaaaaaaaaaaaaaaaaaaaaaaaaaaaaaaaaaaaaaaaaaaaaaaaaaaaaaaaaaaaaaaaaaaaaaaaaaaaaaaaaaaaaaaaaaaaaaaaaaaaaaaaaaaaaaaaaaaaaaaaaaaaaaaaaaaaaaaaaaaaaaaaaaaaaaaaaaaaaaaaaaaaaaaaaaaaaaaaaaaaaaaaaaaaaaaaaaaaaaaaaaaaaaaaaaaaaaaaaaaaaaaaaaaaaaaaaaaaaaaaaaaaaaaaaaaaaaaaaaaaaaaaaaaaaaaaaaaaaaaaaaaaaaaaaaaaaaaaaaaaaaaaaaaaaaaaaaaaaaaaaaaaaaaaaaaaaaaaaaaaaaaaaaaaaaaaaaaaaaaaaaaaaaaaaaaaaaaaaaaaaaaaaaaaaaaaaaaaaaaaaaaaaaaaaaaaaaaaaaaaaaaaaaaaaaaaaaaaaaaaaaaaaaaaaaaaaaaaaaaaaaaaaaaaaaaaaaaaaaaaaaaaaaaaaaaaaaaaaaaaaaaaaaaaaaaaaaaaaaaaaaaaaaaaaaaaaaaaaaaaaaaaaaaaaaaaaaaaaaaaaaaaaaaaaaaaaaaaaaaaaaaaaaaaaaaaaaaaaaaaaaaaaaaaaaaaaaaaaaaaaaaaaaaaaaaaaaaaaaaaaaaaaaaaaaaaaaaaaaaaaaaaaaaaaaaaaaaaaaaaaaaaaaaaaaaaaaaaaaaaaaaaaaaaaaaaaaaaaaaaaaaaaaaaaaaaaaaaaaaaaaaaaaaaa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
cmd	108	-	0	-	-	-	2b1a03000c0000006c000000
cmd	43	-	7	-	-	-	2b1a03000c0007002b000000
cmd	108	0102	9	-	-	-	2b1a03000e0009006c0000000102
cmd	255	-	11	-	-	-	2b1a03000c000b00ff000000
cmd	256	-	12	-	-	-	2b1a0d000c000c0000010000
cmd	65535	aabbccdd	13	-	-	-	2b1a0d0010000d00ffff0000aabbccdd
