Orpah/orpah-client-demo/proto/test_vectors_hgic_ctrl.txt

# proto/test_vectors_hgic_ctrl.txt —— 由 proto/run_cross_test.py --refresh 生成，**勿手改**
# 来源（单一源）：**本仓** tools/txah_hgic.py 的 ctrl_info()
# 列：<type><TAB><from 0|1><TAB><载荷-hex><TAB><rc><TAB><kind><TAB><id><TAB><status><TAB><data-hex>
#   kind ∈ req|resp|'-'（rc≠0 时全为 -）；status = 十进制或 '-'（短应答无 status）
#   覆盖：带 status/len 的应答、短应答（只回 id）、请求、事件、CMD2/EVENT2、空载荷
3	1	6c000300aabbcc	0	resp	108	0	aabbcc
3	1	6c000300aabb	0	resp	108	-	-
3	1	6c	0	resp	108	-	-
3	1		-1	-	-	-	-
3	0	6c01020304	0	req	108	-	04
3	0	6c0102	0	req	108	-	-
4	1	0e01020304	0	resp	14	-	04
13	1	2c01000100bb	0	resp	300	0	bb
13	1	2c010300aa	0	resp	300	-	-
13	1	6c	-1	-	-	-	-
14	1	2c01ff	0	resp	300	-	-
9	1	aabb	0	resp	170	-	-
2	1	01	0	resp	1	-	-
