Orpah/orpah-client-demo/proto/test_vectors_hgic_parse.txt

# proto/test_vectors_hgic_parse.txt —— 由 proto/run_cross_test.py --refresh 生成，**勿手改**
# 来源（单一源）：**本仓** tools/txah_hgic.py 的 StreamParser.feed()
# 列：<expect><TAB><流-hex><TAB><chunk><TAB><frames><TAB><garbage><TAB><bad_length><TAB><overrun>
#   expect ∈ any|rx|tx（rx = 只收模组→主机，= Python 的 expect_from_module=True）
#   chunk  = 每次喂多少字节（0 = 一次喂完；1 = 逐字节）
#   frames = ';' 分隔的 <from>:<type>:<len>:<cookie>:<ifidx>:<flags>:<载荷hex|->（无帧 = -）
#   覆盖：逐字节喂、前置杂音、假 magic（长度非法）、截断、两种 magic 混流、方向过滤
#   ⚠ overrun 是 **C 独有**（Python 缓冲无上限），合法数据恒为 0 —— 收录它就是钉住“永不为 0 以外”
rx	1a2b09340c00050088b50102	0	1:9:12:5:3:4:88b50102	0	0	0
rx	1a2b09340c00050088b50102	1	1:9:12:5:3:4:88b50102	0	0	0
rx	1a2b09340c00050088b50102	3	1:9:12:5:3:4:88b50102	0	0	0
any	1a2b09340c00050088b501022b1a09001c0001000102030405060708090a0b0c0d0e0f1011121314	0	1:9:12:5:3:4:88b50102;0:9:28:1:0:0:0102030405060708090a0b0c0d0e0f1011121314	0	0	0
rx	1a2b09340c00050088b501022b1a09001c0001000102030405060708090a0b0c0d0e0f1011121314	0	1:9:12:5:3:4:88b50102	27	0	0
tx	1a2b09340c00050088b501022b1a09001c0001000102030405060708090a0b0c0d0e0f1011121314	0	0:9:28:1:0:0:0102030405060708090a0b0c0d0e0f1011121314	12	0	0
any	0102031a2b09340c00050088b50102	0	1:9:12:5:3:4:88b50102	3	0	0
any	2b1a0900070000001a2b09340c00050088b50102	0	1:9:12:5:3:4:88b50102	7	1	0
any	1a2b0934	0	-	0	0	0
any	2b1a03000c0002006d0000001a2b09340c00050088b5010200ff1a2b09340c00050088b50102	2	0:3:12:2:0:0:6d000000;1:9:12:5:3:4:88b50102;1:9:12:5:3:4:88b50102	2	0	0
any	2b	1	-	0	0	0
any		0	-	0	0	0
