Orpah/orpah-client-demo/proto/test_vectors_hmac.txt

# proto/test_vectors_hmac.txt —— 由 proto/run_cross_test.py --refresh 生成，**勿手改**
# 来源（单一源）：Python hmac.new(key, msg, hashlib.sha256).digest()
# 列：<key-hex><TAB><msg-hex><TAB><mac-hex>
# 覆盖：空键/空消息 / 键 32~(64)→ 超分组 65/128（**必须先哈希**）/ 消息跨块,
#       以及★**真实降级路径**：32B 演示 HMAC 密钥 × 真实签名预像（§5.1 的 HS256）
		b613679a0814d9ec772f95d778c35fc5ff1697c493715653c6c712144292c5ad
6b6579	54686520717569636b2062726f776e20666f78206a756d7073206f76657220746865206c617a7920646f67	f7bc83f430538424b13298e6aa6fb143ef4d59a14946175997479dbc2d1a3cd8
0708090a0b0c0d0e0f101112131415161718191a1b1c1d1e1f20212223242526		51559a0b1574b56b2d53e17824c397cba5e7a6b965873ee78043761d5a935db6
0708090a0b0c0d0e0f101112131415161718191a1b1c1d1e1f20212223242526	07	be890af04789f5d755fdccced065b07bbdabc32dd0ccfa975a6a6a26a6c545ed
0708090a0b0c0d0e0f101112131415161718191a1b1c1d1e1f20212223242526	0708090a0b0c0d0e0f101112131415161718191a1b1c1d1e1f202122232425262728292a2b2c2d2e2f303132333435363738393a3b3c3d	dfdbd06bdad85a02f472f7396d1819f8c96d9556509d26acd3f9312841b9df46
0708090a0b0c0d0e0f101112131415161718191a1b1c1d1e1f20212223242526	0708090a0b0c0d0e0f101112131415161718191a1b1c1d1e1f202122232425262728292a2b2c2d2e2f303132333435363738393a3b3c3d3e	eb86dd9ab368c51e25443624bebdfd8f9b1b29543bc7f3148042a4ef8dc188f6
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
370e2ece79fcb65a50eae8812d63ab4fb35d43510bae99e20b3ebca0c74a3e8b	7b22686472223a7b22616c67223a224553323536222c226c6576656c223a302c22747970223a226f727061682d69642d7265706f7274222c22766572223a317d2c227061796c6f6164223a7b22626174746572795f6d76223a333930302c22636170223a7b22727463223a66616c73657d2c226669726d77617265223a226334222c226e6f6e6365223a223346394138423243314434453546364137423843394430453146324133423443222c227365656e5f726f7574657273223a5b7b226273736964223a2241413a42423a43433a44443a45453a4646222c2272737369223a2d34322c2273736964223a224f5250414849445f5a4f4e455f41227d5d2c22736e223a22434e2d574830312d3941463343314432222c227473223a307d7d	b3e0bd17357701dee35be3d0f94562addf6f3b059ffab6a72adf730c4d385e23
