Orpah/orpah-client-demo/proto/test_vectors_sha256.txt

# proto/test_vectors_sha256.txt —— 由 proto/run_cross_test.py --refresh 生成，**勿手改**
# 来源（单一源）：Python hashlib.sha256()
# 列：<input-hex><TAB><digest-hex>   （空输入 = 行首就是 TAB）
# 覆盖：空 / 一个块边界 55/56/57/63/64/65/127/128 / 1000 字节 / 全零 128B,
#       以及**真实签名预像**（jcs({"hdr","payload"})，即 c4 要签的那串字节）
	e3b0c44298fc1c149afbf4c8996fb92427ae41e4649b934ca495991b7852b855
616263	ba7816bf8f01cfea414140de5dae2223b00361a396177a9cb410ff61f20015ad
6162636462636465636465666465666765666768666768696768696a68696a6b696a6b6c6a6b6c6d6b6c6d6e6c6d6e6f6d6e6f706e6f7071	248d6a61d20638b8e5c026930c3e6039a33ce45964ff2167f6ecedd419db06c1
000102030405060708090a0b0c0d0e0f101112131415161718191a1b1c1d1e1f202122232425262728292a2b2c2d2e2f303132333435363738393a3b3c3d3e3f404142434445464748494a4b4c4d4e4f505152535455565758595a5b5c5d5e5f606162636465666768696a6b6c6d6e6f707172737475767778797a7b7c7d7e7f808182838485868788898a8b8c8d8e8f909192939495969798999a9b9c9d9e9fa0a1a2a3a4a5a6a7a8a9aaabacadaeafb0b1b2b3b4b5b6b7b8b9babbbcbdbebfc0c1c2c3c4c5c6c7c8c9cacbcccdcecfd0d1d2d3d4d5d6d7d8d9dadbdcdddedfe0e1e2e3e4e5e6e7e8e9eaebecedeeeff0f1f2f3f4f5f6f7f8f9fafbfcfdfeff	40aff2e9d2d8922e47afd4648e6967497158785fbd1da870e7110266bf944880
030a11181f262d343b424950575e656c737a81888f969da4abb2b9c0c7ced5dce3eaf1f8040b121920272e353c434a51585f666d747b82	1deace58c745f3ecadde68a5923f494c3703fa73f0306483ccb898a5826e8d70
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
7b22686472223a7b22616c67223a224553323536222c226c6576656c223a302c22747970223a226f727061682d69642d7265706f7274222c22766572223a317d2c227061796c6f6164223a7b22626174746572795f6d76223a333930302c22636170223a7b22727463223a66616c73657d2c226669726d77617265223a226334222c226e6f6e6365223a223346394138423243314434453546364137423843394430453146324133423443222c227365656e5f726f7574657273223a5b7b226273736964223a2241413a42423a43433a44443a45453a4646222c2272737369223a2d34322c2273736964223a224f5250414849445f5a4f4e455f41227d5d2c22736e223a22434e2d574830312d3941463343314432222c227473223a307d7d	d24faa0788b583d5134a1879777da7d83ddc8a9847f16ab2b00f1ce83e716364
