Orpah/orpah-client-demo/proto/test_vectors_downlink.txt

# proto/test_vectors_downlink.txt —— 由 proto/run_cross_test.py --refresh 生成，**勿手改**
# 来源（单一源）：orpah_proto.decode_msg() + 设备侧取值习惯（client.py / DeviceSim.on_down）
# 列：<json-hex><TAB>valid<TAB>type<TAB>sn<TAB>ts<TAB>tracked<TAB>status<TAB>code
#   ⚠ 只收录“Python 也说无效”的无效用例（浮点/超 int64/嵌套过深 是 C 有意加严，
#     不入向量，边界见 proto/README.md）
7b2276223a312c2274797065223a224f525041482d4143434553532d494e464f222c227473223a313738393837393933392c22736e223a22434e2d574830312d3941463343314432222c22747261636b6564223a747275652c227365727665725f6f6b223a747275652c22737461747573223a22545241434b4544227d	1	ORPAH-ACCESS-INFO	CN-WH01-9AF3C1D2	1789879939	1	TRACKED	-
7b2276223a312c2274797065223a224f525041482d4143434553532d494e464f222c227473223a302c22736e223a22434e2d574830312d3941463343314432222c22747261636b6564223a66616c73652c227365727665725f6f6b223a747275657d	1	ORPAH-ACCESS-INFO	CN-WH01-9AF3C1D2	0	0	-	-
7b2276223a312c2274797065223a224f525041482d545241434b494e472d535441545553222c227473223a352c22736e223a22434e2d574830312d3941463343314432222c22737461747573223a224e4f542d545241434b4544222c226d7367223a226f6b227d	1	ORPAH-TRACKING-STATUS	CN-WH01-9AF3C1D2	5	-	NOT-TRACKED	-
7b2276223a312c2274797065223a224f525041482d4552524f52222c227473223a372c22736e223a22434e2d574830312d3941463343314432222c22636f6465223a22524154454c494d4954222c226d7367223a22736c6f77227d	1	ORPAH-ERROR	CN-WH01-9AF3C1D2	7	-	-	RATELIMIT
7b2276223a312c2274797065223a224f525041482d464f554e44222c227473223a307d	1	ORPAH-FOUND	-	0	-	-	-
6e6f74206a736f6e	0	-	-	-	-	-	-
5b5d	0	-	-	-	-	-	-
7b7d	0	-	-	-	-	-	-
7b2276223a312c2274797065223a224e4f5045222c227473223a307d	0	-	-	-	-	-	-
7b2276223a312c	0	-	-	-	-	-	-
7b2276223a312c2274797065223a224f525041482d4143434553532d494e464f222c227473223a312c22736e223a2258222c22747261636b6564223a226e6f227d	1	ORPAH-ACCESS-INFO	X	1	1	-	-
