Orpah/orpah-client-demo/proto/test_vectors_msg.txt

# proto/test_vectors_msg.txt —— 由 proto/run_cross_test.py --refresh 生成，**勿手改**
# 来源（单一源）：orpah_proto.build_*() + encode_msg()（**插入序**，不带 sort_keys，
#                  separators=(',',':')）—— 信封不是 JCS！
# 列：<kind><TAB><a1><TAB><a2><TAB><a3><TAB><a4><TAB><a5><TAB><envelope-hex>
#   req-connect : a1=sn a2=ts a3=mac|- a4=hw|- a5=-
#   report      : a1=sn a2=ts a3=seq a4=cap(-|0|1) a5=rssi|-
#   id-report   : a1=sn a2=ts a3..a5=-（内层用固定 stub，两侧一致）
req-connect	CN-WH01-9AF3C1D2	0	-	-	-	7b2276223a312c2274797065223a224f525041482d5245512d434f4e4e454354222c227473223a302c22736e223a22434e2d574830312d3941463343314432227d
req-connect	CN-WH01-9AF3C1D2	1789879939	4A:06:59:00:00:01	CH32V203+TX-AH	-	7b2276223a312c2274797065223a224f525041482d5245512d434f4e4e454354222c227473223a313738393837393933392c22736e223a22434e2d574830312d3941463343314432222c226d6163223a2234413a30363a35393a30303a30303a3031222c226877223a2243483332563230332b54582d4148227d
report	CN-WH01-9AF3C1D2	0	1	-	-	7b2276223a312c2274797065223a224f525041482d5245504f5254222c227473223a302c22736e223a22434e2d574830312d3941463343314432222c22736571223a317d
report	CN-WH01-9AF3C1D2	0	1	0	-55	7b2276223a312c2274797065223a224f525041482d5245504f5254222c227473223a302c22736e223a22434e2d574830312d3941463343314432222c22736571223a312c22636170223a7b22727463223a66616c73657d2c2272737369223a2d35357d
report	CN-WH01-9AF3C1D2	1789879939	7	1	-42	7b2276223a312c2274797065223a224f525041482d5245504f5254222c227473223a313738393837393933392c22736e223a22434e2d574830312d3941463343314432222c22736571223a372c22636170223a7b22727463223a747275657d2c2272737369223a2d34327d
report	CN-WH01-9AF3C1D2	0	2	-	-20	7b2276223a312c2274797065223a224f525041482d5245504f5254222c227473223a302c22736e223a22434e2d574830312d3941463343314432222c22736571223a322c2272737369223a2d32307d
id-report	CN-WH01-9AF3C1D2	0	-	-	-	7b2276223a312c2274797065223a224f525041482d49442d5245504f5254222c227473223a302c22736e223a22434e2d574830312d3941463343314432222c227265706f7274223a7b22686472223a7b22747970223a226f727061682d69642d7265706f7274222c22766572223a312c22616c67223a224553323536222c226c6576656c223a307d2c227061796c6f6164223a7b22736e223a22434e2d574830312d3941463343314432222c227473223a302c226e6f6e6365223a224141414141414141414141414141414141414141414141414141414141414141222c227365656e5f726f7574657273223a5b5d7d2c22736967223a2253545542227d7d
id-report	CN-WH01-9AF3C1D2	1789879939	-	-	-	7b2276223a312c2274797065223a224f525041482d49442d5245504f5254222c227473223a313738393837393933392c22736e223a22434e2d574830312d3941463343314432222c227265706f7274223a7b22686472223a7b22747970223a226f727061682d69642d7265706f7274222c22766572223a312c22616c67223a224553323536222c226c6576656c223a307d2c227061796c6f6164223a7b22736e223a22434e2d574830312d3941463343314432222c227473223a302c226e6f6e6365223a224141414141414141414141414141414141414141414141414141414141414141222c227365656e5f726f7574657273223a5b5d7d2c22736967223a2253545542227d7d
