Orpah/orpah-client-demo/proto/test_vectors_sn.txt

# proto/test_vectors_sn.txt —— 由 proto/run_cross_test.py --refresh 生成，**勿手改**
# 来源（单一源）：Python 参考实现 orpah-over-halow/orpah_id.py
# 列：ORG-UNIQUE<TAB>LUHN32<TAB>MOD97
# 说明：校验位只算 ORG-UNIQUE（不含 CC）—— 规范 §2 硬规则
WH01-9AF3C1D2	E	21
0	0	98
Z	1	90
2	W	92
7	J	77
T	B	11
V	9	05
000000000000	0	98
ZZZZZZZZ	8	48
wh01-9af3c1d2	E	71
WH01	Z	48
CA-0001	Y	17
AA-000-0000	2	96
H8WTPFWP18JYS74CGVB	A	81
ZYEMZPXETD29P	S	05
4KHBCEJCF5EH24Z	9	68
Y	3	93
VW5WRJDY4	4	23
1AYBZKW4KZ	V	49
H9	X	46
K56VQKV55DH9XGQB0VFN	5	79
3ZK0M34Q5515JENN	P	42
5DG6TW163JKCZ	Z	52
CZ4NG62	1	95
J3WQQPF	5	61
2KDZ74EVH	4	32
TKPQNY	8	64
ANKQJJFRDWJKE3W	6	98
XP	P	17
X9RB9NC6HSP7FS	D	24
HPY9AVW618YB7YA4	E	82
Q3	3	85
W4F0X77875E4B4CK8MDN	N	92
8NBX5YJ	V	72
9G5CB2DYBVRY3HPCY	B	20
8FHGTG736	C	16
BYQXP1015KX2TJ2HW	2	19
PDWB8R0M67DF7S2HN	3	18
19FFJD7P9NP1WHD932CW	A	97
FXRCYH	5	04
5PEJ267AQXKXH	X	19
VKAA2WBH	Q	38
EMFN2H4V2P8WE4JW	Y	89
8GMES	P	31
GDRVQZVBP4K0FYFQ	5	89
SMYJDK	7	93
D5JT8Q	B	34
1PAP	V	50
QATBE	B	97
HTQX7P55RW4PR7BGW5	B	54
9WKTDAZYV	S	63
16TB59BZ6	4	72
E22FH	C	27
DDH97G7QG1N8	1	91
YJNJCEW	N	51
EGFSNSVTBP	Z	15
VXZ	D	23
830JS74ZJPEK	F	44
WA947BRFYX	K	23
34922G75WSWE3S9B	R	59
8DPP0KJ	8	30
M4DXWEDKZN99BCHHXT	2	13
TZ60HQM14FCQ	E	13
