Orpah/orpah-client-demo/(list of files, drawings)

Other design files:
hardware/carrier/carrier-board.fzz
hardware/carrier/carrier-breadboard.fzz
hardware/carrier/carrier-pcb.fzz
hardware/carrier/carrier-schematic.fzz
hardware/wiring/bstep-ch347f-2txah-evb.fzz
hardware/wiring/bstep-ch347f-txah-evb-thrj45.fzz
hardware/wiring/bstep-ch347f-txah-evb.fzz
hardware/wiring/cstep-ch347f-atecc608b.fzz
hardware/wiring/cstep-ch347f-nanoch32-atecc608b.fzz
hardware/wiring/cstep-ch347f-nanoch32-i2ctest.fzz
hardware/wiring/cstep-ch347f-txah-evb-nanoch32-atecc608b.fzz
hardware/wiring/cstep-ch347f-txah-evb-nanoch32.fzz
hardware/wiring/cstep-nanoch32-atecc608b.fzz
