Orpah/orpah-client-demo/firmware/Core/id_core.c

/* id_core.c — 已签 ID 上报任务（固件侧策略；流水线本体在 proto/id_build.c）。*/
#include "id_core.h"

#include "atecc.h"
#include "id_build.h"
#include "id_level.h"
#include "hgic_uart.h"
#include "uart.h"
#include "board.h"

/* 主循环的 1 ms 时基（`Core/main.c` 定义）。⚠ 只用来**量** build 耗时：
 * 不读它的话（比如拿 `idc_*` 的入参 `now_ms` 去减）差恒为 0 —— 实测踩过：
 * 输出里 `build_ms=0` 看着"很快"，而真机上 ES256 是**秒级**（假数字比没数字更坏）。*/
extern volatile uint32_t g_tick_ms;

/* ------------------------------------------------------------------ */
/* 静态状态（RAM 紧：一律 static，别放栈上）                              */
/* ------------------------------------------------------------------ */
static jcs_ctx_t s_jc;
static idb_t     s_b;
static char      s_rep[IDC_REPORT_CAP];
static char      s_env[IDC_ENV_CAP];
static char      s_frame[IDC_FRAME_CAP];

static uint32_t  s_boot_entropy;     /* 上电熵（`id` 里打出来，便于看撞没撞）*/
static char      s_mode[12];        /* §8.2 故障注入模式（auto/sign_fail/se_fail/no_key）*/
static uint32_t  s_next_due;        /* 下一个发送时刻（ms 时基）*/
static uint32_t  s_last_sent;       /* 上次真正发出的时刻*/
static uint8_t   s_have_sent;       /* 发过一次没有（第一次不受自限频约束）*/
static uint32_t  s_sent;            /* 真正发出去的条数*/
static uint32_t  s_held;            /* 被自限频**延后**的次数（不是丢弃）*/
static uint32_t  s_build_fail;      /* 组装失败次数*/
static uint32_t  s_tx_fail;         /* 交给模组失败次数*/
static int       s_ready;

static const char *s_last_why = "-";

/* ------------------------------------------------------------------ */
/* 工具（ASCII 输出；控制台代码页可能是 GBK）                            */
/* ------------------------------------------------------------------ */
static void print_hex_line(const char *p, size_t n)
{
    static const char H[] = "0123456789abcdef";
    size_t i;

    for (i = 0; i < n; i++) {
        char b[3];

        b[0] = H[((unsigned char)p[i] >> 4) & 0x0Fu];
        b[1] = H[(unsigned char)p[i] & 0x0Fu];
        b[2] = '\0';
        uart_printf(CONSOLE_UART, "%s", b);
        if ((i % 32u) == 31u) {
            uart_printf(CONSOLE_UART, "\r\n");
        }
    }
    uart_printf(CONSOLE_UART, "\r\n");
}

static int str_eq(const char *a, const char *b)
{
    while (*a != '\0' && *a == *b) { a++; b++; }
    return (*a == '\0' && *b == '\0');
}

static int str_prefix(const char *s, const char *pre)
{
    while (*pre != '\0') {
        if (*s != *pre) { return 0; }
        s++; pre++;
    }
    return 1;
}

/* §8.2 的输入：`se_ok` = “**能不能做 ES256 签名**”。
 * ★★ d 步（2026-10-11）：装上了 SE 签名器（`Periph/atecc.c` 的 `atecc_sign_any()`）
 *   ⇒ 这里如实回“真 SE 在前”。✗ 没接/没探到时回 0（那时 level=0 走的是**软件替身** ——
 *   口径同 §8.2：软件替身属**演示级**，别当成“SE 在签”✗）。*/
static int _se_ok(void)
{
    return (s_b.sign_fn != 0) ? 1 : 0;
}

/* ------------------------------------------------------------------ */
/* 组装 + 发送                                                          */
/* ------------------------------------------------------------------ */
static int idc_build_and_send(uint32_t now_ms, const char *why)
{
    size_t flen = 0u;
    int level = -1;
    const char *reason = 0;
    uint32_t t0, dt;
    int rc, tx;

    t0 = now_ms;
    rc = idb_build(&s_b, s_mode, &flen, &level, &reason);
    /* ← 重读时基：`now_ms` 是入参、全程不变，拿它减自己恒得 0（实测踩过这个假测量）。
     * `dt == 0` 就是"不足 1 ms"（比如 level=3 不签名），**不要兜底成 1**。*/
    dt = g_tick_ms - t0;
    if (rc != 0) {
        s_build_fail++;
        uart_printf(CONSOLE_UART, "\r\n[id] build FAILED err=%d idr_rc=%d mode=%s\r\n",
                    s_b.last_err, s_b.last_idr_rc, s_mode);
        return 0;
    }
    tx = hgic_uart_send_frm2((const uint8_t *)s_frame, flen);
    if (tx < 0) {
        s_tx_fail++;
        uart_printf(CONSOLE_UART, "\r\n[id] tx FAILED rc=%d (frame %u B)\r\n",
                    tx, (unsigned)flen);
        return 0;
    }
    s_sent++;
    s_last_sent = now_ms;
    s_have_sent = 1u;
    s_last_why = reason;
    uart_printf(CONSOLE_UART, "\r\n[id] sent level=%d alg=%s why=%s nonce=%s len=%u"
                              " build_ms=%u (%s)\r\n",
                level, (level == 0) ? "ES256" : (level == 3) ? "none" : "HS256",
                reason, s_b.last_nonce, (unsigned)flen, (unsigned)dt, why);
    return 1;
}

int idc_tick(uint32_t now_ms)
{
    if (!s_ready) {
        return 0;
    }
    /* 环绕安全：用"差距"判断，不直接比大小 */
    if ((int32_t)(now_ms - s_next_due) < 0) {
        return 0;
    }
    s_next_due = now_ms + IDC_INTERVAL_MS;
    return idc_build_and_send(now_ms, "periodic");
}

/* ------------------------------------------------------------------ */
/* 初始化                                                              */
/* ------------------------------------------------------------------ */
/* ★ d 步（2026-10-11 上机）：SE 可用吗 —— 记住它。
 *   为什么要记：nonce/签名两个 provider 都是**注入**进 `idb_t` 的 ⇒
 *   “换 SN 重建流水线”会把它们丢掉 ✗ ⇒ 重建后必须按这个标志**重新装上** ✓。*/
static int s_se_ok;

/* 按当前 SE 状态把两个 provider 装回去（单一源：初始化与“换 SN”都调它 ✓）*/
static void _install_providers(void)
{
    if (!s_se_ok) {
        return;
    }
    idb_set_nonce_fn(&s_b, atecc_nonce_hex, 0);
    /* ★★ 按算法分流：ES256 ⇒ SE 的 `Sign(0x41)`（slot 0）/ HS256 ⇒ SE 内 `SHA` HMAC（slot 4）
     * ⇒ `idb_t.ec` / `idb_t.hmac` 那两份**演示材料都不再参与**（两把真钥都在芯片里 ✓）*/
    idb_set_sign_fn(&s_b, atecc_sign_any, 0);
}

/* 用 `sn` 重建流水线（并把 provider 装回去 ✓）。返回 `idb_init` 的 rc。
 * ★ 为什么需要它：固件缺省用的 SN 得是**桌上那颗真片**的，否则帧里的 SN 与
 *   “库里登记的钥”对不上 ⇒ 上游必然 `signature_invalid` ✗（尺子对不上号 ✓）。
 *   `idsn <SN>` 就是把这个缺口补上（**不用为每颗芯片重烧固件** ✓）。*/
static int _reinit_with_sn(const char *sn)
{
    int rc = idb_init(&s_b, &s_jc, s_rep, sizeof(s_rep), s_env, sizeof(s_env),
                      s_frame, sizeof(s_frame), sn, IDC_GEN_DEFAULT,
                      IDC_FW_VERSION, 0, s_boot_entropy);

    if (rc != 0) {
        uart_printf(CONSOLE_UART, "[id] init FAILED rc=%d\r\n", rc);
        return rc;
    }
    _install_providers();
    return 0;
}

int idc_init(uint32_t boot_entropy)
{
    int rc;

    s_boot_entropy = boot_entropy;
    rc = _reinit_with_sn(IDC_SN_DEFAULT);
    if (rc != 0) {
        return rc;
    }
    /* 默认 auto（= §8.2 全正常 → L0）；故障注入靠控制台 `idlevel` */
    {
        const char *m = idl_mode_name(0);

        s_mode[0] = (m != 0) ? m[0] : 'a';
        {
            int i = 1;

            while (m != 0 && m[i] != '\0' && i < (int)sizeof(s_mode) - 1) {
                s_mode[i] = m[i];
                i++;
            }
            s_mode[i] = '\0';
        }
    }
    s_next_due = IDC_INTERVAL_MS;      /* 上电后先走完一个周期再发第一条（给人看横幅的时间）*/
    s_last_sent = 0u;
    s_have_sent = 0u;
    /* ★ c4-γ-2：nonce 优先用 ATECC608B 的 RNG（规范 §5.4 要求的就是它）；
     *   没接/没应答则**如实回退**到软熵后端，并在 `id`/`se` 里打出用的是哪个。*/
    {
        int se = atecc_init();

        if (se == 0) {
            atecc_stats_t st;

            s_se_ok = 1;
            _install_providers();
            atecc_stats(&st);
            uart_printf(CONSOLE_UART,
                        "[id] nonce <- ATECC608B Random(0x1B) 32B (crc_mode=%s)\r\n",
                        (st.crc_mode == 0u) ? "no-crc(响应 33 B)" :
                        (st.crc_mode == 1u) ? "crc(响应 35 B)" : "unknown");
            uart_printf(CONSOLE_UART,
                        "[id] ES256 sign <- ATECC608B Sign(0x41) slot %u（私钥不出芯片 ✓）\r\n",
                        (unsigned)ATECC_SIGN_SLOT);
            uart_printf(CONSOLE_UART,
                        "[id] HS256 sign <- ATECC608B SHA HMAC slot %u（降级钥也不出芯片 ✓）\r\n",
                        (unsigned)ATECC_HMAC_SLOT);
        } else {
            uart_printf(CONSOLE_UART,
                        "[id] nonce <- soft entropy (SE 无应答 rc=%d；见 docs/atecc608b-se.md)\r\n",
                        se);
            uart_printf(CONSOLE_UART,
                        "[id] sign  <- **软件替身**（ES256/HS256 都走它；演示级 ✗；规范 §6 要的是 SE 里签）\r\n");
        }
    }
    s_ready = 1;
    (void)_se_ok();
    return 0;
}

/* ------------------------------------------------------------------ */
/* 控制台                                                              */
/* ------------------------------------------------------------------ */
static void cmd_status(void)
{
    uart_printf(CONSOLE_UART, "\r\n[id] sn=%s gen=%d fw=%s\r\n",
                s_b.sn, s_b.gen, (s_b.firmware != 0) ? s_b.firmware : "-");
    uart_printf(CONSOLE_UART, "[id] se=%s\r\n",
                _se_ok() ? "ATECC608B (槽 0 签 ES256 / 槽 4 出 HS256，两把钥都不出芯片)" :
                           "stand-in(software P-256, 演示级 ✗)");
    /* ★ nonce 来源（c4-γ-2）：规范 §5.4 要求 ATECC608B 的 RNG；没接则如实标 soft。
     * ★ d 步：**签名来源**同一套口径（`sign_src`）—— 这两件事必须分开说，
     *   别合并成一句“已启用 SE”✗。*/
    uart_printf(CONSOLE_UART, "[id] nonce_src=%s sign_src=%s\r\n",
                (s_b.last_nonce_src != 0) ? s_b.last_nonce_src : "-",
                (s_b.last_sign_src != 0) ? s_b.last_sign_src : "-");
    uart_printf(CONSOLE_UART, "[id] mode=%s  interval=%u ms  min_gap=%u ms\r\n",
                s_mode, (unsigned)IDC_INTERVAL_MS, (unsigned)IDC_MIN_GAP_MS);
    uart_printf(CONSOLE_UART, "[id] last_level=%d why=%s nonce=%s frame_len=%u\r\n",
                s_b.last_level, (s_last_why != 0) ? s_last_why : "-",
                (s_b.last_nonce[0] != '\0') ? s_b.last_nonce : "-",
                (unsigned)s_b.last_frame_len);
    uart_printf(CONSOLE_UART, "[id] built=%u sent=%u held=%u build_fail=%u tx_fail=%u"
                              " fell_back=%u\r\n",
                (unsigned)s_b.built, (unsigned)s_sent, (unsigned)s_held,
                (unsigned)s_build_fail, (unsigned)s_tx_fail, (unsigned)s_b.fell_back);
    /* ★★ d 步：两种签名各自进了 SE 几次 —— **分开报** ✗（合成一个数就分不出
     *   “ES256 在芯片里签的”和“HS256 在芯片里算的” ✓）。
     *   上机时一眼就能确认 `idlevel l1` 后 HS256 是否真走 SE（ok 应 +1 ✓）。*/
    {
        atecc_stats_t st;

        atecc_stats(&st);
        uart_printf(CONSOLE_UART,
                    "[id] se_hits: ES256 slot %u ok=%u fail=%u / HS256 slot %u ok=%u fail=%u\r\n",
                    (unsigned)ATECC_SIGN_SLOT, (unsigned)st.sign_ok, (unsigned)st.sign_fail,
                    (unsigned)ATECC_HMAC_SLOT, (unsigned)st.hmac_ok, (unsigned)st.hmac_fail);
    }
    /* ★★ SHA/HMAC 的时序旋钮（`setime` 可改 ✓）—— 放在状态里，好让现场确认“这次跑的是哪组参数” ✓ */
    {
        int poll, wake;
        uint32_t ready, gap, rgap, rst;

        atecc_sha_timing_get(&poll, &ready, &gap, &rgap, &rst, &wake);
        uart_printf(CONSOLE_UART,
                    "[id] sha timing: poll=%d ready_ms=%u gap_ms=%u restart_gap_ms=%u restarts=%u"
                    " wake_each=%d（setime 可改 ✓）\r\n",
                    poll, (unsigned)ready, (unsigned)gap, (unsigned)rgap, (unsigned)rst, wake);
    }
    /* ⚠ 如实：软熵后端只保证"同一 boot 内不重复"。**跨 boot 若上电熵撞了，整段 nonce 会重**
     *   ⇒ 服务端按重放丢弃（= 漏报）。把这个值打出来，好让人一眼看出撞了没。*/
    uart_printf(CONSOLE_UART, "[id] boot_entropy=0x%08x (soft; 跨 boot 撞了整段 nonce 会重)\r\n",
                (unsigned)s_boot_entropy);
    uart_printf(CONSOLE_UART, "[id] ts=0 cap.rtc=false (no RTC); battery_mv not written\r\n");
}

static void cmd_modes(void)
{
    int i;

    uart_printf(CONSOLE_UART, "[id] modes(§8.2 故障注入 -> 级别): ");
    for (i = 0; i < IDL_MODE_COUNT; i++) {
        int se = 1, sg = 1, hm = 1;
        const char *why = "-";

        (void)idl_mode_inputs(idl_mode_name(i), &se, &sg, &hm);
        uart_printf(CONSOLE_UART, "%s->L%d ", idl_mode_name(i), idl_pick(se, sg, hm, &why));
    }
    uart_printf(CONSOLE_UART, "\r\n");
}

int idc_console(const char *cmd, uint32_t now_ms)
{
    if (str_eq(cmd, "id")) {
        cmd_status();
        return 1;
    }
    if (str_eq(cmd, "idsend")) {
        if (s_have_sent && (uint32_t)(now_ms - s_last_sent) < IDC_MIN_GAP_MS) {
            /* §5.8 设备侧：**延后，不丢弃**（丢自己的业务报 = 漏报）*/
            s_held++;
            uart_printf(CONSOLE_UART, "\r\n[id] held (self-limit): next in %u ms\r\n",
                        (unsigned)(IDC_MIN_GAP_MS - (now_ms - s_last_sent)));
            return 1;
        }
        if (!idc_build_and_send(now_ms, "console")) {
            uart_printf(CONSOLE_UART, "[id] send FAILED (see above)\r\n");
        }
        return 1;
    }
    if (str_eq(cmd, "idhex")) {
        if (s_b.last_frame_len == 0u) {
            uart_printf(CONSOLE_UART, "\r\n[id] no frame yet (try idsend)\r\n");
            return 1;
        }
        uart_printf(CONSOLE_UART, "\r\n[id] last frame %u B (paste into"
                                  " tools/check_report_hex.py on the PC):\r\n",
                    (unsigned)s_b.last_frame_len);
        print_hex_line(s_frame, (size_t)s_b.last_frame_len);
        return 1;
    }
    if (str_eq(cmd, "idmodes")) {
        cmd_modes();
        return 1;
    }
    /* ★★ d 步（2026-10-11 上机）：`idsn <SN>` —— 把流水线的 SN 换成**桌上那颗真片**的。
     *   为什么必须能换：入库的每一颗 SE 各有自己的 SN，而帧里的 SN 是上游查钥的**钥匙** ⇒
     *   SN 不对 ⇒ 库里的真钥用不上 ⇒ 只能拿演示钥去验 ⇒ 必然 `signature_invalid` ✗。
     *   有了它，换一颗芯片只要敲一行（**不用重烧** ✓）。
     *   ⚠ 重建会把计数器（built/sent）与 last_* 一起清零 —— 这是重建的正常代价 ✓。*/
    if (str_prefix(cmd, "idsn")) {
        const char *arg = cmd + 4;

        while (*arg == ' ') { arg++; }
        if (*arg == '\0') {
            uart_printf(CONSOLE_UART, "\r\n[id] sn=%s（用法：idsn <SN>）\r\n", s_b.sn);
            return 1;
        }
        if (_reinit_with_sn(arg) != 0) {
            uart_printf(CONSOLE_UART, "[id] idsn 失败（SN 非法？参看上游 sn.h 的规则）\r\n");
            return 1;
        }
        uart_printf(CONSOLE_UART, "\r\n[id] sn <- %s（流水线已按新 SN 重建；两个 provider 已重装 ✓）\r\n",
                    s_b.sn);
        return 1;
    }
    if (str_eq(cmd, "se")) {
        /* c4-γ-2 现场判据：唤醒 + 一条 `Random(0x1B)`（把 count/CRC 模式/随机数打出来）*/
        atecc_selftest();
        return 1;
    }
    if (str_prefix(cmd, "idlevel")) {
        int se = 1, sg = 1, hm = 1;
        const char *why = "-";
        const char *arg = cmd + 7;
        int lvl;

        while (*arg == ' ') { arg++; }
        if (*arg == '\0') {
            cmd_modes();
            return 1;
        }
        if (idl_mode_inputs(arg, &se, &sg, &hm) != 0) {
            uart_printf(CONSOLE_UART, "\r\n[id] unknown mode: %s (idmodes)\r\n", arg);
            return 1;
        }
        /* 存模式名（照抄上游 LEVEL_MODES 的那几个字符串）*/
        {
            int i = 0;

            while (arg[i] != '\0' && i < (int)sizeof(s_mode) - 1) {
                s_mode[i] = arg[i];
                i++;
            }
            s_mode[i] = '\0';
        }
        lvl = idl_pick(se, sg, hm, &why);
        uart_printf(CONSOLE_UART, "\r\n[id] mode=%s -> L%d (%s)\r\n", s_mode, lvl, why);
        return 1;
    }
    /* ★★ 2026-10-11 深夜（上机扫时序）：`setime [<poll> [<ready_ms> [<gap_ms> [<restart_gap_ms> [<restarts>]]]]]`
     *   为什么做成控制台可调 ✗：SHA/HMAC 的“就绪等待 / 命令间间隔 / 要不要探地址 / 重来间隔与次数”
     *   要试好几个组合，而每次试都要重新烧固件 ⇒ 一轮几分钟；做成旋钮后
     *   **烧一次、之后每轮只要敲一行** ✓。不带参数就只打印当前值 ✓。*/
    if (str_prefix(cmd, "setime")) {
        const char *arg = cmd + 6;
        long v[6];
        int n = 0;

        while (n < 6) {
            long x = 0;
            int got = 0;

            while (*arg == ' ') { arg++; }
            while (*arg >= '0' && *arg <= '9') {
                x = x * 10 + (long)(*arg - '0');
                got = 1;
                arg++;
            }
            if (!got) { break; }
            v[n++] = x;
        }
        if (n >= 1) {
            int poll, wake;
            uint32_t ready, gap, rgap, rst;

            atecc_sha_timing_get(&poll, &ready, &gap, &rgap, &rst, &wake);
            poll = (int)v[0];
            if (n >= 2) { ready = (uint32_t)v[1]; }
            if (n >= 3) { gap = (uint32_t)v[2]; }
            if (n >= 4) { rgap = (uint32_t)v[3]; }
            if (n >= 5) { rst = (uint32_t)v[4]; }
            if (n >= 6) { wake = (int)v[5]; }
            atecc_sha_timing_set(poll, ready, gap, rgap, rst, wake);
        }
        {
            int poll, wake;
            uint32_t ready, gap, rgap, rst;

            atecc_sha_timing_get(&poll, &ready, &gap, &rgap, &rst, &wake);
            uart_printf(CONSOLE_UART,
                        "\r\n[id] sha timing: poll=%d ready_ms=%u gap_ms=%u restart_gap_ms=%u"
                        " restarts=%u wake_each=%d\r\n"
                        "     （用法：setime <poll 0|1> <ready_ms> <gap_ms> <restart_gap_ms>"
                        " <restarts> <wake_each 0|1>）\r\n",
                        poll, (unsigned)ready, (unsigned)gap, (unsigned)rgap, (unsigned)rst, wake);
        }
        return 1;
    }
    return 0;
}
