Orpah/orpah-client-demo/proto/run_cross_test.py

#!/usr/bin/env python3
# -*- coding: utf-8 -*-
"""
run_cross_test.py — c2：SN 内核「Python 参考 vs C 实现」零偏差对拍（纯 PC，不需要硬件）

做三件事：

  ① **C 侧自检**：用 host 编译器编译 `proto/sn.c` + `proto/sn_cli.c`，然后跑
       · `selfcheck`                          —— 内置黄金样本/边界（不依赖文件）
       · `selftest <test_vectors_sn.txt>`     —— ORG-UNIQUE → Luhn32 / Mod97
       · `sn-selftest <test_vectors_snparse.txt>` —— SN → ok / err / verify
  ② **快照与 Python 参考一致**（能 import 上游 `orpah_id` 时）：逐行用 Python 重算，
     与入库的两份向量文件比对；不一致 = FAIL（快照过期 或 两边已分叉）。
  ③ `--refresh`：用 Python 参考**重写**两份向量文件（生成后请核对 diff 再提交）。

判定口径（与上游 `run_checks.py` 一致）：**退出码 0 且输出无 FAIL**。
编译器探测顺序（沿用上游 `orpah-over-halow/c/run_cross_test.py`）：$CC → gcc/clang/cc → MSVC cl。

运行：
  python proto/run_cross_test.py
  python proto/run_cross_test.py --orpah-dir ../orpah-over-halow --refresh

HGIC 帧层（c3）另有 **第四组目标 `hgic_cli`**（`hgic.c` + `hgic_cli.c`）+ 三份向量
（`test_vectors_hgic*.txt`）：它的单一源在**本仓** `tools/txah_hgic.py`（模组 SDK 源码 + 真机实测），
**不依赖上游仓库** ⇒ 那三份快照与 C 自检在没有上游时照样会跑。

ECDSA / RFC 6979（c4-β-2）是**第五组目标 `ecdsa_cli`**（`ecdsa.c` + `rfc6979.c` + `ecdsa_cli.c`），
两份向量性质不同、别混：
  · `test_vectors_ecdsa.txt` —— 可被 `--refresh` 重生成（Python 侧第二实现 + **OpenSSL 算 k*G**）
  · `test_vectors_ecdsa_rfc6979.txt` —— **静态夹具 = RFC 6979 §A.2.5 官方向量**，
    `--refresh` **不许**改写它；它由三条**互相独立**的验证守着（key pair 自洽 / h1 == sha256(label) /
    k == 本仓 Python RFC6979 / (r,s) 过 OpenSSL 验签），见 `proto/README.md`。
  另有一步：拿 `ecdsa_cli sign` 的输出去过 **OpenSSL 验签** —— 字节一致只证明"两边一样"，
  验签才证明"这确实是一份合法签名"。
"""
import argparse
import os
import random
import shutil
import subprocess
import sys
import tempfile

HERE = os.path.dirname(os.path.abspath(__file__))
REPO = os.path.dirname(HERE)
DEFAULT_ORPAH = os.path.abspath(os.path.join(REPO, "..", "orpah-over-halow"))


def load_hgic_ref():
    """HGIC 帧层的单一源 = **本仓** `tools/txah_hgic.py`（模组 SDK 源码 + 真机实测）。

    它**不依赖上游仓库**（与 SN/JCS/报文那几组不同）⇒ HGIC 三组快照与 C 自检
    在没有 `orpah-over-halow` 时应照跑不误。
    """
    tools = os.path.join(REPO, "tools")
    if tools not in sys.path:
        sys.path.insert(0, tools)
    import txah_hgic
    return txah_hgic

VEC_SN = os.path.join(HERE, "test_vectors_sn.txt")
VEC_PARSE = os.path.join(HERE, "test_vectors_snparse.txt")
VEC_JCS = os.path.join(HERE, "test_vectors_jcs.txt")
VEC_B64 = os.path.join(HERE, "test_vectors_b64url.txt")
VEC_MSG = os.path.join(HERE, "test_vectors_msg.txt")
VEC_DL = os.path.join(HERE, "test_vectors_downlink.txt")
VEC_SHA = os.path.join(HERE, "test_vectors_sha256.txt")
VEC_HMAC = os.path.join(HERE, "test_vectors_hmac.txt")
VEC_IDR = os.path.join(HERE, "test_vectors_id_report.txt")
VEC_HGIC = os.path.join(HERE, "test_vectors_hgic.txt")
VEC_HGIC_PARSE = os.path.join(HERE, "test_vectors_hgic_parse.txt")
VEC_HGIC_CTRL = os.path.join(HERE, "test_vectors_hgic_ctrl.txt")
VEC_P256 = os.path.join(HERE, "test_vectors_p256.txt")
VEC_ECDSA = os.path.join(HERE, "test_vectors_ecdsa.txt")
VEC_ECDSA_RFC = os.path.join(HERE, "test_vectors_ecdsa_rfc6979.txt")
# c4-γ-1（设备侧流水线：§8.2 选级 / 演示密钥 / nonce / 整帧）
VEC_ID_KEYS = os.path.join(HERE, "test_vectors_id_keys.txt")
VEC_ID_LEVEL = os.path.join(HERE, "test_vectors_id_level.txt")
VEC_ID_NONCE = os.path.join(HERE, "test_vectors_id_nonce.txt")
VEC_ID_FRAME = os.path.join(HERE, "test_vectors_id_frame.txt")
VEC_CRC16 = os.path.join(HERE, "test_vectors_crc16.txt")
VEC_ATECC = os.path.join(HERE, "test_vectors_atecc.txt")
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
