Orpah/orpah-client-demo/tools/check_c4g2_bench.py

# -*- coding: utf-8 -*-
"""check_c4g2_bench.py — c4-γ-2 **上机判据**的一键跑法（PC 侧）。

判的是「nonce 真的来自 ATECC608B」这一件事，全程用**实际字节**，不靠固件自报的结论：
  1. 打开 nano 的**控制台串口**（默认 COM23，115200 8N1）；
  2. 探活：`AT` → `OK`（不靠横幅 —— 板子已跑一会儿的话横幅早过去了，同 γ-1 口径）；
  3. 发 `se`（固件里的 `atecc_selftest()`）⇒ 看四件事：
       · `[se] 唤醒判据 … ：是 ✓`     —— 读回 4 字节 = `04 11 33 43`
         ⚠ 报 `不是 ✗` **不等于**硬件坏：器件**本来就醒着**时它必然不是
         （读到的是上一条响应的 count），以**随后的命令结果**为准 —— 见下面的判据 1
       · `[se] cmd=… crc_mode=…`     —— ★ **本轮实测**：线上要不要挂 CRC（两条待确认假设之一）
       · `[se] Random(0x1B) 32 B ok; 前 16 B = <32hex>`
       · 失败时把 `rc / last_resp_len / raw=` 原样带出来（是 `count` 口径不对还是别的问题）
  4. **再发一次 `se`** ⇒ 两次的 16 B **必须不同**（RNG 真的在动，不是常量/缓存）；
  5. 发 `id` ⇒ `nonce_src=se`（装配进流水线的那条路径确实在用 SE；`soft` 就是没接上）；
  6. ★ d 步（2026-10-11）：`se` 会额外对一条**固定摘要**签一次并打出 `r||s` ⇒
     本工具用 **Slot 0 的公钥**（下面常量，来自 2026-10-11 台架实测）**独立验签** ✓
     （板上**不**自己验自己：那只证明自洽 ✗）；同时判 `id` 的 `sign_src=se` ✓。
  6. （默认做）发 `idsend` + `idhex` ⇒ 把帧交给**上游** `orpah_id.verify_report` 判一次
     （与 `tools/check_report_hex.py` / `tools/check_c4g1_bench.py` **共用同一套判定**，不重写协议）；
     可选 `--mod-port COM24` 同时抓模组打印口，确认帧进了模组。

判据（退出码）：**0 = 全过**；2 = 有 FAIL（信息在输出里）；1 = 用法/环境问题（串口打不开、
              找不到上游参考实现）。

跑完请把 §6 那张表（`docs/atecc608b-se.md`）里的「实测」列填上 —— 尤其是 `crc_mode`：
它是两条**待上机确认**假设之一的答案，填上以后就不用再判了。

用法：
    python tools\\check_c4g2_bench.py                      # COM23 + 模组口 COM24，全流程
    python tools\\check_c4g2_bench.py --port COM7
    python tools\\check_c4g2_bench.py --no-idsend          # 只判 SE（不碰 ID 上报）
    python tools\\check_c4g2_bench.py --from-file log.txt  # 离线解析一段控制台日志
    python tools\\check_c4g2_bench.py --from-keystore       # ★ 用产线登记的那把钥验帧（HS256 也能判 ✓）
    python tools\\check_c4g2_bench.py --keep-open          # 只 dump 原始输出，不判定

⚠ **串口独占**：Windows 上一个口只能被一个进程打开 ⇒ 先关掉 WindTerm / SecureCRT /
   MounRiver 的串口窗口（否则 `PermissionError(13)`）。
"""
import argparse
import hashlib
import os
import re
import sys
import time

HERE = os.path.dirname(os.path.abspath(__file__))
REPO = os.path.dirname(HERE)
sys.path.insert(0, HERE)

from check_report_hex import load_upstream, find_upstream, judge, strip_hex  # noqa: E402  （单一源：解析/判定）
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
