Orpah/orpah-client-demo/(commit log)

2026-09-14 首次提交：立规矩与骨架（AGENTS.md / README.md / .gitignore）
    本仓 = ORPAH 五仓里的客户端侧：CH32V203 + SE(ATECC608B) + 泰芯 TX-AH 模组。
    - AGENTS.md：硬规则 —— ① 协议语义只认 Protocol（本仓不定义协议，要改回 Protocol 改）；
    host 数据口帧格式认 host_bus.py / SPEC §6；空口与真机事实认 halow-demo 的 AGENTS
    （含两条直接相关的事实：TX-AH 的 fmac 固件 AT 层无用户数据命令 → payload 只能走
    host SPI MACBUS；真机一次只应答一条 AT 查询）。
    ② 硬件/工具链（MounRiver riscv-none-elf、-DWCH_INTERRUPT_FAST、裸机 nostdlib）
    与参考骨架 halow-demo/simulator/firmware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
2026-09-14 许可证 Apache-2.0 + 真机三步走路线图
    - LICENSE：Apache-2.0（用户 2026-09-14 定：协议各仓均用 Apache-2.0）。
    与 orpah-over-halow/LICENSE 逐字节相同（SHA256 一致）；按兄弟仓做法只放 LICENSE，
    不加 NOTICE（Protocol 另有一份 NOTICE，若要补请告知）。
    - ROADMAP.md：把用户定的两条线各五步落成文档 —— 客户端 a→e（a 已完成，在
    orpah-over-halow：client_sim.py + demo_client_sim.py + docs/client_sim.md）、
    路由器 a→e；每步的判据固定为「周期上报 + 服务端验签通过 + 下行真到达 + 上游零丢弃」。
    写明 b 步的**关键未知项**：PC↔TX-AH 板的物理数据通路（T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
2026-09-14 b 步走 UART（用户修正）：AT+TXDATA + FRAME:RX
    用户 2026-09-14 确认：客户端与模块之间是 **UART**，不是 SPI。
    先前fmac 固件 AT 无用户数据命令 → payload 只能走 SPI的说法已纠正为：
    - 线上协议：上行 AT+TXDATA=<len> → 等 OK → 写裸以太帧（含 14B 头，长度也含它）；
    下行 FRAME:RX <hex> 行（需 AT+SYSDBG=WNB,1）。PC 侧实现已在 orpah-over-halow
    （host_serial.SerialAtBus + client_sim --transport serial），纯 PC 排练 demo_client_uart.py。
    - **如实记下两份记录不一致**：T-Halow-RJ45/docs/AT_cmd.md 确有 AT+TXDATA，而 halow-demo 的
    真机实测写着 TX-AH fmac AT 只有控制面 → 以实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
2026-09-14 docs: b 步真机夹具记录 —— nanoCH32V203 当 USB-UART 桥（COM32）
    用户 2026-09-14 实测跑通并记录：板子原生 USB、无 CH340，Win11 下出不了 COM 口 →
    刷 WCH 官方 SimulateCDC 例程把它变成「USB CDC ↔ USART2(PA2/PA3)」的 USB-UART 桥，
    设备管理器出现 `USB串口设备(COM32)`；SecureCRT 连 COM32 键 `AT+SSID?` 有正确回应。
    - 新增 `docs/nano-ch32v203-uart-bridge.md`：为什么需要这步（原生 USB / BOM 里没有串口桥 IC
    / 出厂固件不是 CDC）、刷机六步（CH32V20xEVT → MounRiver 编 `EVT/EXAM/USB/USBD/SimulateCDC`
    → WCHISPTool V3.3 + BOOT/RST 进 bootloader → RST 后出 COM32）、串口参数 115200 8N1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
2026-09-14 docs: J4 引脚定义按 AH UART 原理图写实（GND = pin 4；编号自右向左）
    用户 2026-09-14 给出 TX-AH EVB 的「AH UART」原理图段，J4 = 4 脚、J5 = 2x4、J10 = 单针 GND：
    J4: 1=VCC、2=IOA12、3=IOA13、4=GND
    J5: 1=VCC、2=AH_D2、3=AH_D3、4=VCC、5=CH340E_TX、6=CH340E_RX、7=GND、8=GND
    - 文档 §3：J4 引脚定义写成表格（1 VCC / 2 IOA12 / 3 IOA13 / 4 GND）——本次接线用的就是 pin2/pin3，
    **GND = J4 pin 4**；并说明它与板上丝印的关系（丝印从左到右 GND/A13/A12/VCC = pin4/3/2/1
    ⇒ 该排编号自右向左）——**去掉原来这是推断的标注**（已有原理图背书）。
    - 同段原理图还确认了 J4 = 4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
2026-09-14 上机首测（b 步真机）：AT 控制面通，但 AT+TXDATA 实测不支持 —— 通路待重定
    2026-09-14 拿 COM32（nano 当 USB-UART 桥）直接与 TX-AH 对话，脚本只查/只读 + 一条测试帧，
    **未改任何持久配置**。实测结果：
    模块身份：AT+VERSION=? -> v2.4.1.5-38247（第 4 位 = 5）、MAC 4a-06-59-8d-74-40、
    SSID 测试链路；当时 AP 模式（mode=2）、908.0MHz/bw8、chn 908/916/924、无 sta、vcc 4.94V。
    - 控制面可用：AT+SSID? / AT+VERSION=? / AT+MAC_ADDR=? 都答；AT+SYSDBG=LMAC,0 真能关掉
    周期 LMAC STATUS 刷屏；resync()（1700 字节填充）在真机上有效。
    - ✘ 数据面：AT+TXDATA 四种写法（=29 / =29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
2026-09-15 tools: PC 侧 CH347F SPI 访问 + TX-AH SPI 电气探测（b 步候选通路 ①）
    - tools/ch347_spi.py：CH347/CH347F 的 PC 侧封装（ctypes 调 WCH CH347DLL，
    签名逐条照 CH347DLL_EN.H V1.5）。SPI 主机；UART 接口已封但本轮未测。
    实测记两条 DLL 行为：① 没插任何 WCH 设备时 CH347OpenDevice(0..3) 也可能返回
    句柄（芯片类型读成 0=CH341）→ 判"设备在不在"要用 CH347SPI_Init 是否成功；
    ② auto_deassert=1 时最后一个字节容易读成 0x00 → 读响应一律手动 CS。
    - tools/probe_txah_spi.py：电气探测（bus / sweep / sdspi / raw / misocheck）。
    判据 = SD-SPI 的 CMD0 / CMD5 / CMD8 有没有合法 R1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
2026-09-15 docs: 接线表补精确（CH347F-EVT 的 P4/P8 归属 + 片选 CS1/CS2 读法 + 供电注意）
    - 按 CH347DS1 第 13 页 + 板级原理图 CH347SCH：P4 = SPI（3.3V/GND/SCS0/SCK/MISO/MOSI
    + 可选 SCS1）、P5 = I2C、P6 = JTAG、P8 = 板载 SPI FLASH 片选（别拿去接模组）。
    - DLL 的 CS1 = SCS0（P4 主片选）、CS2 = SCS1（可选第二片选）；脚本默认 --cs 1。
    这条是按手册读的，**未实测校验**。
    - 供电：建议用模组开发板自身供电、只共地 + 接 SPI 4 线 —— CH347F-EVT 的 3.3V 兜不住模组
    发射瞬间电流（会表现为"时好时坏"）。
2026-09-15 docs: UART（mac_bus）路线落地记录 —— 固件已就绪、接线与协议要点、首测判据
    - docs/txah-uart-macbus.md：为什么走 UART（SPI 无固件实现、SDIO 需原厂驱动）、
    固件怎么切/编/烧/回退（指向 halow-demo TXW8301）、接线（数据口 UART0 = IOA10/A11、
    AT 口 UART1 = IOA12/A13、CH347F-EVT 正好两路 UART）、协议单一源（HGIC 8B 头
    magic/type/ifidx-flags/length/cookie；UART 第 5/6 字节 = 整帧长；RAW = 裸以太帧）、
    首测判据、未做。
    - ROADMAP §二：UART 路线从"待排"改为"固件已就绪（bin + 特征串）、未烧录，
    PC 侧 HGIC 驱动待写"。
    未做（如实）：PC 侧 HGIC 收发/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
2026-09-15 tools: UART 侧联调就绪 —— HGIC 编解码（离线自测）+ 数据口收发脚本 + CH347F UART 实测
    - tools/txah_hgic.py：泰芯 AH 主机口 HGIC 帧编解码 + 流解析（按 uart_bus.c 的定帧规则：
    magic 0x1A2B/0x2B1A、第 5/6 字节 = 整帧长；含垃圾字节重新同步，杂字节/非法长度都计数）。
    单一源 = 模组 SDK（hgic.h / uart_bus.c / project_config.h），离线 `selftest` 13 项全过。
    - tools/probe_txah_uart.py：数据口联调（listen / send-eth / send-cmd / raw / selftest）。
    传输二选一：`--port COMx`（pyserial）或 `--ch347-uart 0|1`（CH347F-EVT，走 WCH DLL）。
    判据写在脚本里：0 字节 / 有字节但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
2026-09-16 docs: 补 CH347F-EVT 排针归属与 P2/P3 脚号表（数据口接线落到 TXD0/RXD0/GND，A10->pin4 T 等）
2026-09-16 tools+docs: 数据口加 probe/loopback 子命令 + 首测判据改为'先看打印口有没有 uart bus fixlen'（listen 0 字节不等于不通）
    [probe_txah_uart.py]
2026-09-16 docs: 开发板侧接线落到实处 —— A10/A11 板上叫 AH D2/D3，可达点 J5 pin3/pin5(经1K)+GND；给 A(跳板载CH340E)/B(飞CH347F) 两种接法
2026-09-16 docs: 说清 CON3 的 6 个串阻（R18/R20/R21/R23/R3/R25 = NC/1K 默认不贴）与阻值口径不一致；J5 那对 1K 已贴，走 J5 就好
2026-09-16 docs: 记 CH347F 在 VCP 模式下 UART0/UART1 = COM23/COM24（P2 可走 DLL 或 pyserial 两条独立路，排查时两条都试）；补 TF 卡会拉 A10/A11 的提醒
2026-09-16 tools+docs: --port 缺 pyserial 时给可操作的提示（本机 python=3.14 没装、3.13 有）；--ch347-uart 加 --byte-timeout 便于验证 DLL 通路
2026-09-16 实测：CH347F VCP 模式下 DLL 的 UART 不通、走 COM 口可自环通过 → 新增 --ch347-com 0|1 自动找口（按 MI_00/MI_02）
2026-09-16 docs: 记实测排除项（CH347F UART1=P3=模组AT口/COM24；UART0 自环通；DLL 不通）+ 借 AT 口当信号源的分层排查法
2026-09-16 docs: 实测定案 A13=模组打印/AT 输出脚（UART1_TX）+ P2 RX 路到模组通；补分层排查第 2/3 步
2026-09-16 docs: AT 往返成功（P2 两向/电平/共地全好）+ 记 UART0 引脚方向出处；唯一疑点收窄到 J5 落点
2026-09-16 docs: 实测量 J5 pin3/pin5->模组=1kΩ（A12/A13=0Ω）+ 记 1kΩ 为什么不影响 115200（含算式与被证明不了的事）
2026-09-16 docs: J5 pin3<->pin5 短接自环通过（我这侧全清白）+ 新增 5.2 临时调试固件（UART0 RX 打印：改动/备份/编译/烧录/判据）
2026-09-16 docs: 实测帧完好到达模组 UART0（线序/波特率/1kΩ 全定案）+ 调试固件加 TX 打印（第二版已编好）
2026-09-16 docs: 记 AT+BUS_WT 实测回显与其出处（liblmac.a/libwifi.a print2host），作为回程独立信源的候选
2026-09-16 docs: BUS_WT 0/1/2 实测无字节；从闭源库字符串记下 wifimgr host cmd:/host_alive 两条线索与 DEV_OPEN 假设
2026-09-16 docs: 新增 5.3 —— 根因线索 WIFIMGR_FRM_TYPE_RAW 无命令通道（厂商指南三档对比 + 不重编判定法 + 换法待对齐）
2026-09-16 docs: 记 UMAC,1 状态打印证据（if_recv:1 / if_write:0 / open:0 / TX_DATA:1）与 send-eth 用法
2026-09-16 docs: 按用户选择已切换 WIFIMGR_FRM_TYPE=HGIC（+main.c 开机自报 frm_type），附回退与上机判据
2026-09-16 feat(tools): HGIC 控制帧解码（ctrl_hdr 12B / 应答 cmd_id|status|len|data / fw_info）+ listen 合并重复事件；docs: 记 HGIC 打通与黄金样本
2026-09-16 feat(tools): 新增 xfer 子命令（两块模组端到端：A 口发→空口→B 口收，报一致性）；docs: §七 两块模块接线/AT 配置/判据 + ROADMAP 进展
2026-09-16 docs(hardware): b 步夹具接线图（Fritzing .fzz/.svg）+ README
    - hardware/wiring/：CH347F-EVT ↔ TX-AH EVB 接线图（可编辑 .fzz 工程 + .svg 导出）
    - README（新）：从 .fzz 里抽出来的连线表（6 条，含线色）+ 脚名含义 + 一个 CH347F 管两路
    UART 的分工 + 部件版本与「.fzz 内嵌部件快照」说明 + 怎么用/边界
    - 如实边界：接线图 ≠ 链路已验证；模组 VCC → CH347F VIO 建议对 CH347F-EVT 原理图确认
    （部件里 VIO 是独立总线）；图上未画 USB 供电与「拔 TF 卡/拿掉 J5 跳线帽」两条环境项
    - docs/txah-uart-macbus.md §3.3 末尾加一行指针到 hardware/wiring/
    未验证照旧标注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
    [bstep-ch347f-txah-evb.fzz]
2026-09-16 docs: 供电口径改为「各自供电、只共地」（CH347F-EVT ↔ TX-AH）
    起因：用户实测发现原口径（"别用 CH347F 的 3V3 去带模组（发射瞬间电流不够）"）说得不准 ——
    实际接的是 VIO，而 JP1 把 VIO 与板 3V3 短接了，静态量到 3.28 V。
    - docs/txah-uart-macbus.md
    · §3.3：供电那条改成有据的口径（共地必须接、两边 3V3 不要接一起），理由三条：
    ① 模组板 VCC 是板上 DCDC 的输出节点 —— 原理图写着 DCDC OUTPUT 3V3 FOR SYS +
    VCC(3V3) current at least 400mA. ripple<30mV（有源阻抗/纹波要求的电源输出）；
    ② CH347F-EVT 的 VIO 经 JP1 与板 3V3 同轨（用户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
2026-09-16 fix(hardware): 接线图去掉电源线（两块板各自供电、只共地）+ README 按新图同步
    - hardware/wiring/bstep-ch347f-txah-evb.fzz / .svg（用户重存）：删掉 `VCC → VIO` 那根电源线
    - hardware/wiring/README.md：接线表按新 `.fzz` 重新抽取 ⇒ **共 5 根**（4 信号 + GND），无电源线
    · 新增「供电：两块板各管各的，只共地」一节，记下理由（都有出处）：
    模组板 VCC 是板上 DCDC 的输出节点（原理图：DCDC OUTPUT 3V3 FOR SYS +
    VCC(3V3) current at least 400mA. ripple<30mV）；CH347F-EVT 的 VIO 经 JP1 与板 3V3 同轨
    （实测静态 3.28 V）；两边相接 = 两个稳压源并联在同一条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
    [bstep-ch347f-txah-evb.fzz]
2026-09-16 docs: 12 B 控制头上机复验通过（send-cmd 43 回包逐字节相同）+ §六「未做」按实测更新
    2026-09-16 实机复验（PC 侧唯一未验证的改动，现结）：
    python tools\probe_txah_uart.py --ch347-com 0 send-cmd 43
    发 2b 1a 03 00 0c 00 01 00 2b 00 00 00（12 B 头）
    回 1a 2b 03 00 28 00 01 00 | 2b 00 1c 00 ...（40 B，status=0，data=28 B）
    FW: app=2.4.1.5 svn=39777 chip_id=0x4002 mac=4a:06:59:8d:74:40 smt_dat=124022701
    另见周期事件 7 = TX_BITRATE 值 0x8b。
    · §5.4 第 1 条：把「12 B 头待实测确认」改成已验证（附命令、收发字节、FW 三字段）
    · §六：删掉三条已过期的「未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
2026-09-16 docs(§7): 记 B 板实测确认（同版本固件/HGIC/数据口活）+ 两个可疑点
    - §7.2：B 板启动日志（用户提供）证明已是同一版（build time Sep 16 2026 15:55:48）+
    [mbus cfg] frm_type=1 bus=4 + uart bus fixlen=0 + debug build UART0 rx dump on
    ⇒ 不用重刷；[5030][mbus tx] 12 byte(s) 1a 2b 04 00 0c ... 说明数据口在往主机发事件
    - §7.5：已确认两块 MAC 不同（A 4a:06:59:8d:74:40 / B 69:6e:6b:00:00:00），
    但 B 的 0x69 LSB=1 是组播地址（可疑；A 关联不上时先查它）；
    B 的 syscfg 为空（invalid magic_num=0）⇒ 参数全默认，§7.3 必须显式设
2026-09-16 docs: 更正「J5 跳线帽必须拿掉」——实测证明缺省位置接的是 AT/打印口，不影响数据口
    2026-09-16 实测推翻原口径（原写在 §3.2 选项 B / §7.1 / hardware/wiring/README）：
    - 插着帽时 CH347F 数据口的 HGIC 命令照常一问一答（send-cmd 43 实测）
    - 拔掉帽后 AT 口就断了（用户那边的 AT 走的就是这个缺省位置）
    - 拔掉帽后数据面依旧不通 ⇒ 真因是空口没关联，不是抢线
    正确口径：J4/J5 两列 3 焊盘是「板载 CH340E 接哪一路」的选择器
    缺省（中-下）= CH340E ↔ A12/A13（UART1 = AT/打印口）⇒ 不碰 A10/A11，插着无妨
    上-中 = CH340E ↔ A10/A11（数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
    [bstep-ch347f-2txah-evb.fzz]
2026-09-16 docs(§7): 修正 CHAN_LIST 写法 + 记录两块板的实际角色/信道（与我之前的假设相反）
    实测（用户提供两块 LMAC STATUS）：
    AP = 4a:06:59:8d:74:40 mode=2 chan 1 = 908 MHz ← 接在 CH347F P2 / COM23
    STA = 69:6e:6b:00:00:00 mode=0 chan 3 = 924 MHz ← 接在 CH347F P3 / COM24
    两块都 sta_list: no sta / AID=0 ⇒ 没关联；信道还不一致
    ⇒ 之前把 --tx-com 0 当"客户端那端"是反的（实际发进了 AP）；在 COM23 上问 GET_BSSID 得全 0
    也因此作废（AP 本来就不报 BSSID）
    文档更正：
    - §7.3：AT+CHAN_LIST 参数是 MHz（908,916,924），原写的 9080/9160/9240 是错的；
    并记下源码事实：AT+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
2026-09-16 feat(§7): b 步数据面「上行」打通（FRM2 + 完整以太帧）+ 记接口 MAC 组播位的坑
    2026-09-16 实测（CH347F P2/P3 分别接两块 TX-AH 的数据口；AP=4a:06:59:8d:74:40）:
    - ✅ 上行 STA→AP 逐字节到达:
    ff ff ff ff ff ff | 68 6e 6b 00 00 00 | 88 b5 | HELLO-ORPAH
    dst 用对端 MAC 也行 ⇒ 约定 = FRM2(8B HGIC 头) + 完整以太帧（14B 以太头）
    裸载荷写法（FRM2 + HELLO-ORPAH）两端都不通 —— 模组是二层桥，靠以太头决定去向
    - ❌ 下行 AP→STA 未到对端主机口（广播/单播都试过）⇒ 记为待查
    （候选：HGIC_CMD_SET_ETHER_TYPE(56) / AP 模式下的转发开关）
    - ✅ 关联的关键（本轮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
    [bstep-ch347f-2txah-evb.fzz]
2026-09-16 docs(§7.5): 记下行排查——已系统性排除 7 类原因（仍不通）
    - 排除项（全部实测）：dst 三种 / src 两种 / ethertype 两种 / 帧头两种 /
    hdr.ifidx 0..7 / 先发 DEV_OPEN(1)（status=0 成功）；均 0 数据帧
    - 灌流 1500 帧后 AP 的 TX_BITRATE 从 1.4k~4.5k 蹿到 14148（像发出去过），STA 主机口仍 0 字节
    - 同一时刻上行 STA→AP 照旧逐字节到达 ⇒ 链路/关联/二层桥没问题，
    问题只在「AP 主机口 → 空口」这一段（反方向 air→host 是好的）
    - 关联证据：GET_STA_LIST(53) 回 12B = struct hgic_sta_info ⇒ AID=2、rssi=9、evm=-33、tx_snr=58、rx_snr=94
    - 下一步：① 灌流时读 AP 的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
2026-09-16 docs(7.5): 下行排查——已排除 7 类原因（仍不通）；查证「AP 侧主机口→空口」不转发
    实测（CH347F P2/P3 各接一块 TX-AH；AP=4a:06:59:8d:74:40、STA=68:6e:6b:00:00:00）:
    - 已系统性排除（每次同时确认上行仍逐字节到达）:
    dst(广播/STA 接口 MAC/STA 的 fw_info MAC)、src(AP MAC/中性 MAC)、
    ethertype(0x88B5/0x0800)、帧头(FRM2 / FRM+24B info)、hdr.ifidx 0..7、
    先发 DEV_OPEN(1)（status=0）、cookie 固定 / 逐帧 +1 —— 全部 0 字节
    - AP 侧直观测（用户提供 AT 日志截图）: 有 [mbus rx] 33 byte(s)（帧确实进了 AP 主机口）；
    紧跟 cookie err: last:167, new:177；灌流 300 帧期间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
2026-09-16 feat(tools): HGIC 数据帧 cookie 改为逐帧 +1（消除模组端 cookie err）
    真机日志（2026-09-16，AP 侧 AT 口）：`cookie err: last:167, new:177`
    —— 我们以前每帧用同一个 cookie、甚至跨脚本乱跳，违反模组的顺序检查
    （hgic.h: HGIC_TX_COOKIE_MASK 0x7FFF / HGIC_TX_WINDOW 20 / HGIC_BLOCK_ACK_CNT 256）。
    - tools/txah_hgic.py: 新增 `HGIC_TX_COOKIE_MASK` + `CookieCounter`（逐帧 +1、按掩码回绕），
    作为这条约定的单一实现（黄金样本/自测不受影响：全过 ✓）
    - tools/probe_txah_uart.py:
    · 新增 `_next_cookie(args)`；`send-eth` / `send-cmd` / `xfer` / `probe` 的每帧都走它
    · `--cookie` 语义 = 起始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
2026-09-16 docs(7.5): 镜像级对比——WNB 固件宿主是 GMAC(以太网)，我们是 UART；定下 b 步路由器侧改用 TH-RJ45
2026-09-16 docs(7.5): AT 表里有测试发送/接收计数(AT+TX_*, AT+RX_PKTS)——可用它先验证客户端 air-to-host
2026-09-18 AGENTS 5：git 提交纪律——只提交我自己创建的文件（用户 2026-09-18 定）
2026-09-19 b 步夹具图定稿：两块模块接线图（不旋转 + 贝塞尔标注 + 空口说明）+ 新增网表复验工具
    用户 2026-09-20 重画完成 hardware/wiring/bstep-ch347f-2txah-evb.svg：
    ① 两块 TX-AH **不旋转**（丝印正着读）；
    ② 三根 USB 线改用**普通贝塞尔路径**（上一版是 Inkscape「连接器」对象，一打开就会按连接器
    规则重新走线 ⇒ 看着"变形"，实测 bbox 从 355x549 塌成 83x1.5）；
    ③ 加标注：`客户端（STA）` / `接入点（AP）`、三根 `… USB → WindTerm`（标 `供电 刷固件 AT命令 打印日志`）、
    数据线上的 `HGIC/MACBUS二进制帧`、两块板之间的 `HaLow 空口(802.11ah) 908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
    [bstep-ch347f-2txah-evb.fzz, bstep-ch347f-txah-evb.fzz]
2026-09-19 b 步数据面端到端实测闭环：上行过空口 + 下行到达客户端主机口
    2026-09-20 台架：客户端 TX-AH EVB(FMAC,STA) <-> T-Halow-RJ45(WNB,AP)，V2.4<->V2.4，halowlink/9080/bw8/open；TH-RJ45 的 RJ45 空着。
    PC 经 CH347F UART0 发 3 条以太帧 -> 客户端 AT 口逐条 [mbus rx] 50/294/41 byte(s)（8B HGIC 头 + 载荷）。
    上行过空口：AP per-STA rx1_cnt 11 -> 12（且 DHCP 应答本身反证上行到过 AP）。
    下行到达：数据口收到 FRM2，内含 src=d6:a2:2a:82:67:c0（AP 的 MAC）的 DHCP 应答(UDP 67->68, 324B)；AT 口旁证 [mbus tx] 332 byte(s)。
    新增 tools/hgic_loop_test.py：一键复现（退出码 0 = 成立；每条帧以模组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
2026-09-19 硬件: 新增第三张夹具图（客户端 STA <-> T-Halow-RJ45 AP）+ README 补 2026-09-20 实机结论
    图 bstep-ch347f-txah-evb-thrj45.{fzz,svg}：客户端 STA 只接 CH347F 数据口；TH-RJ45 当 AP，它的 RJ45 空着（只用 USB-C 看 AT）。图内标注已写实测：上行过空口 OK / 下行到达 host 口 OK / RJ45 空着。
    README：登记第三张图；补“下行到达客户端主机口”的实测表与一键复现 python tools\hgic_loop_test.py；注：该 .fzz 未内嵌 T-Halow-RJ45 用户库部件，分享看 .svg。
    README：把 2026-09-16“用 AT+TXDATA 当下行帧源”的路线标注为作废 —— 两版 V2.4 构建的 AT 都没有数据面命令（AT+TXD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
    [bstep-ch347f-txah-evb-thrj45.fzz]
2026-09-19 夹具图标注统一（-> / OK / text-anchor）+ 网表工具登记第三张图
    bstep-ch347f-2txah-evb.svg / bstep-ch347f-txah-evb.svg：箭头改 ->、空口说明补齐、text-anchor 由 middle 改 start、去行尾空格。两图标注内容仍与各自台架的实测结论一致（2txah 仍写“仅验证了 STA->AP 方向”——那条台架确实只通了上行）。
    tools/fzz_nets.py：EXPECT 登记 bstep-ch347f-txah-evb-thrj45.fzz（MOD.A10<->U3.TXD0、A11<->U3.RXD0、GND<->U3.GND；图上对端无线相连、与任何部件都没有连线）。跑一遍：三张图网表全部对上。
    核对记录：标注 bbox 都在画布内（2txah 右缘 682/692 px；txah 底缘 351/353 px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
2026-09-19 夹具图: HGIC/MACBUS二进制帧 标注挪到数据线正上方（原来混在 USB/日志标签堆里）
    单模块图 bstep-ch347f-txah-evb.svg：底部那摞“刷固件 / AT命令 / 打印日志”是给三根 USB 线的，里面原本还挂着 HGIC/MACBUS二进制帧 ⇒ 读者容易把数据线与 USB 日志线混起来。
    改法：把该标注从那一摞里摘出来，单列一行放到两块板之间、数据线束（蓝/绿/棕，x 约 190-323、y 约 52-66）正上方（x=262, y=45），样式与其它橙棕色标注一致。
    核对：XML 合法；渲染确认不压板子丝印（落在板间空档）；标注都在画布内。
2026-09-20 b 步联调：PC 侧传输换成 HGIC（over UART0），ORPAH 协议栈真报文上真空口
    新增 tools/hgic_bus.py：把模组主机口（HGIC over UART0）包成 host 数据口，API 与上游 host_serial.SerialAtBus 一致（connect/close/send_frame/recv_frame + stats/recent_lines）⇒ ClientHost(bus=…) 直接可用，协议一行不改。发送用模组自己的 [mbus rx] 日志确认，确认不到就重发。
    新增 tools/demo_client_hgic.py：真链路联调（上游 ClientHost 生成 ORPAH-REQ-CONNECT → 经 HGIC 上空口）。判据：HGIC 一问一答 / 下行能到 host 口（发 DHCP DISCOVER 主动触发，不靠等偶发流量）/ 协议栈报文注入了 / 模组确认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
2026-09-20 b 步联调（有线侧）：新增 tools/l2bus.py —— Npcap+scapy 收发裸以太帧，PC 可同时扮 Router/Server
    上游拓扑：客户端 STA ──CH347F/UART0+HGIC── PC（已有 hgic_bus.py）；另一半是 客户端 ──空口── TH-RJ45(AP,L2 透明桥) ──RJ45── 有线网 ── PC，本文件就是这个有线侧。
    API 与 hgic_bus.py / 上游 host_serial.SerialAtBus 一致（connect/close/send_frame/recv_frame + stats），另给 local_mac()（客户端上行要发给它）。CLI：list / probe（打开网卡、打印本机 MAC、看有没有 0x88B5 帧）。
    依赖：Npcap（本机 1.71 已装）+ pip install scapy；若 Npcap 勾了仅管理员可用则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
2026-09-20 b 步：新增 tools/demo_l2_hgic.py —— PC 同时扮 Router+Server 的 L2 全链路闭环（真机实测通过）
    台架：ClientHost(上游真实业务栈) ──CH347F/UART0(HGIC)── 客户端 TX-AH(STA) ──空口── TH-RJ45(AP, L2 透明桥) ──RJ45── 有线 ── 本机网卡(Npcap) → RouterBridge → 本机 OrpahServer(UDP 19447)。四条判据全过：周期上报 / 服务端回执 / 下行真到达客户端 / 上游零丢弃；并首次验证「从 AP 侧 RJ45 进去的帧能下行到客户端」。l2bus.py 新增 drop_own（Npcap 会抓到本机发出的帧 ⇒ 否则 Router 把自己发的下行当上行收回来形成回路）。
2026-09-20 b 步：ID 验签进夹具（⑤ 验签通过 + ⑥ 篡改负对照）；客户端改用上游 DeviceSim
    设备侧不再自己拼报文：tools/demo_l2_hgic.py 用 client_sim.DeviceSim(client= 注入 HGIC)，cycle() = REQ-CONNECT → REPORT → 已签 ID-REPORT；密钥库用 orpah_id.KeyStore 登记同一个设备对象（同 (sn,gen) 派生）。真机实测：3 拍 ID 都是 alg=ES256 level=0 trust=high accepted=True（= b 步判据“服务端收到并验签通过”）；负对照把已签报文 payload 改掉 ⇒ accepted=False error=signature_invalid（证明验签真在跑）；另见 [found 1] 发现走失。拍间隔默认 1.8s 是按设备自限频容量(0.6s/1.67 条每秒)算出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
    [demo_l2_hgic.py]
2026-09-20 b 步：夹具默认改真机形态声明（ts=0 + cap.rtc=false + battery_mv）；新增 ⑦⑧ 两条判据
    默认按无 RTC 的 CH32V203 声明：cap.rtc=false、不发真实时间戳、battery_mv 取 energy.mv_of(CHARGE0_MJ,STORE_MJ)=3900（演示映射）。真机实测 10 项判据全过，新增：⑦ 无 RTC 声明生效（ts_src=server、ts_eff≈现在、cap_rtc=False、ts_ok=False）；⑧ battery_mv 原样到达 Server 且 level=0 ⇒ degraded_reason=None。要验有 RTC 那一支用 --rtc true --real-ts，电量用 --battery-mv 指定。
2026-09-20 c1：本仓固件骨架（CH32V203 裸机）—— 能编译出 .bin，未上机
    firmware/：Makefile（RISCV_PREFIX 默认指向 MRS2 内的 riscv-none-embed-）、ld/link.ld、startup/startup_ch32v203.S、Core/{ch32v20x.h,board.h,main.c}、Periph/{gpio,uart}。基础设施按 AGENTS §1 从 halow-demo/simulator/firmware（我们自己的仓）搬来，board.h/main.c 重写为 ORPAH 形态（控制台 + 模组数据口 + 心跳灯 + 1ms 时基）。实测：make clean && make exit=0 ⇒ .elf 9644B / .bin 2108B（text 2046；bss 20224 是 .heap(NOLOAD) 预留，不是真用掉）。未上机。顺带更正：工具链前缀是 riscv-none-embed-（非 riscv-none-elf-）；参考 Makefile 的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
2026-09-20 c2(1/2)：SN 内核 C 实现 + 与 Python 的交叉测试（零偏差）
    proto/：sn.{h,c}（Crockford / sn_ok / sn_err / sn_parse / Luhn32 / Mod97 / sn_verify_check，无 malloc/stdio 可编进固件）、sn_cli.c（host 侧对拍 CLI）、run_cross_test.py（C ↔ 向量文件 ↔ Python 三方比对）、两份向量文件（Python 生成）。实测：python proto\run_cross_test.py → exit 0；selfcheck 11/11、selftest 63/63、sn-selftest 19/19，两份快照与 Python 逐行一致。纠正一个真事实：SN 校验位是 Luhn32(1 位)/Mod97(2 位)，不是 Damm32（后者是 Phase 2 替代算法、当前未启用）；AGENTS 里“黄金样本 → B”说的是 Damm32，Luhn32 真值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
2026-09-20 c2(2/2)：JCS 规范化 + b64url（RFC 8785 子集）+ 交叉测试扩到四组
    proto/：jcs.{h,c}（迷你 JSON arena 构建器 + JCS 编码：键排序/整数/字符串转义，无 stdio/malloc/浮点 ⇒ 可编进固件）、b64url.{h,c}（无填充）、jcs_cli.c（host 对拍 CLI）、test_vectors_jcs.txt（12 例）+ test_vectors_b64url.txt（17 例，含 0/1/2 字节余数与 - _）。实测：python proto\run_cross_test.py → exit 0；SN 11/11+63/63+19/19、JCS 4/4+12/12、b64url 17/17，四份快照（63/19/12/17 行）与 Python 逐行一致。边界写进 proto/README.md：键排序用逐字节序（= Python 码点序；真 JCS 按 UTF-16 码元，非 BMP 会不同——我们键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
2026-09-20 c2 完成：报文信封（插入序）构造器 + 交叉测试扩到五组
    proto/：msg.{h,c}（msg_req_connect/msg_report/msg_id_report，对齐 orpah_proto._base+build_* 的插入序）、jcs_encode_raw()（不排序的信封编码，与 JCS 分开）、jcs_cli 增加 msg/msg-selftest、test_vectors_msg.txt（8 例）。实测：run_cross_test.py → exit 0；SN 11/11+63/63+19/19、JCS 4/4+12/12、b64url 17/17、msg 8/8，五份快照与 Python 逐行一致。两个要点写进文档：① 签名预像用 JCS（排序）、链路信封用插入序（encode_msg 不带 sort_keys）；② 哨兵坑——用 - 表示“不给”而 RSSI 是负数，导致 -55 被误判，msg-selftest 挂 4/8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
2026-09-20 c2 收尾：下行解码器（JSON 解析 + decode_msg 语义）+ 交叉测试扩到六组
    proto/：jcs.c 增加无 malloc 的 JSON 解析器（\uXXXX/代理对/整数/严格拒浮点与尾随数据）+ jv_get 系列；downlink.{h,c}（dl_decode 同 decode_msg，dl_type/dl_str/dl_int/dl_truthy 按 Python 真值语义）；jcs_cli 增加 dl/dl-selftest；test_vectors_downlink.txt（11 例）。实测：run_cross_test.py → exit 0；SN 11/11+63/63+19/19、JCS 4/4+12/12、b64url 17/17、msg 8/8、dl 11/11，六份快照与 Python 逐行一致。边界写进 README：C 解析器有意比 Python 严（浮点/超 int64/嵌套>8/重复键/孤立代理项/NaN 均拒），这些不入向量（否则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
2026-09-20 SHA-256（C，FIPS 180-4）+ 交叉测试扩到七组；向量含真实签名预像
    proto/：sha256.{h,c}（init/update/final/一次性，无 stdio/malloc，可编进固件）、sha_cli.c（host CLI：sha256 / sha256-selftest / selfcheck）、test_vectors_sha256.txt（16 例，含空/块边界 55~129/1000B/真实签名预像）。实测：run_cross_test.py → exit 0；sha256-selftest 16/16（对 hashlib）+ selfcheck 分块自洽 3343/3343（同一条输入“一次算”与“分多段喂”逐位相同，小长度每个分点都试），七份快照与 Python 逐行一致。
2026-09-20 HMAC-SHA256（降级 HS256）+ 交叉测试扩到八组
    proto/：hmac.{h,c}（RFC 2104：键超 64B 先哈希、用完清栈上密钥材料；无 stdio/malloc）、sha_cli 增加 hmac/hmac-selftest、selfcheck 增加两条 HMAC 不变量（键超分组等价于其摘要当键；空消息两种写法一致）、test_vectors_hmac.txt（13 例，含键 32~128 与★真实降级路径：32B 演示 HMAC 密钥 × 真实签名预像 = §5.1 的 HS256）。实测：run_cross_test.py → exit 0；hmac-selftest 13/13（对 Python hmac）+ selfcheck 3345/3345，八份快照与 Python 逐行一致。
2026-09-20 c4-α：设备侧已签报文（HS256/none）+ 服务端验签通过（离线）
    proto/：id_report.{h,c}（组装 hdr+payload → JCS 预像 → HMAC-SHA256 签名 → 报文 JSON；level 1/2=HS256、3=none、0=ES256 明确返回 IDR_E_ES256 不假装）、jcs_cli 增加 id-report/id-report-selftest、test_vectors_id_report.txt（5 例）。run_cross_test.py 增加第 9 组 + ★新的一步：把 C 产出的报文交给上游 orpah_id.verify_report()+KeyStore 真验一遍。实测：exit 0；id-report-selftest 5/5（与 Device.report()+encode_msg 逐字节一致）；服务端接受 4 条 level=1/2 且级别相符；L3 accepted=True/trust=none/coverage_only=True（只陈述）。踩坑：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
2026-09-20 soak: 判据 ⑪ 按理由码分类（重发的重复份 不等 验签失败）
    取证（4h soak 中途查 log）：19 次 ID 被拒全部落在「同一拍有 2 条 ID 上行」的拍里，夹具自己打出的理由码是 replay_detected；3635 条 REPORT 收包 0 重复。来源 = hgic_bus.send_frame 的发送确认重试（1.5s 内没看到模组 [mbus rx] n byte(s) 就重发，而第一份其实已经出去了）⇒ 服务端 nonce 去重（SPEC §5.5）正确地拒掉第二份。
    改法：BENIGN_ID_ERRORS 单一源；stat_ids() 一处统计（进度行与收尾判据共用）；⑪ 判 n_real_bad == 0 —— **其它任何理由码照样失败**，没有放宽；重复份单列并打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
2026-09-20 c3-1: HGIC 帧层（8B 头 / FRM2 / CMD / EVENT）+ 与 Python 交叉测试 3 组
    proto/hgic.{h,c}（纯逻辑：无 stdio/malloc/浮点/string.h ⇒ 可编进固件）：8B 头组/解（小端、ifidx:4|flags:4、length = 整帧长度）、FRM2 数据帧、CMD/CMD2 命令帧（4B union 补满 ⇒ 参数落在偏移 12）、cookie 计数器（15 位回绕）、控制面解码（带 status/len 的应答 / 短应答 / 请求与事件）、流式定帧 + 重同步（杂音 / 假 magic / 截断 / 逐字节喂）。
    单一源 = 本仓 tools/txah_hgic.py（模组 SDK hgic.h + uart_bus.c + 真机实测）⇒ 不依赖上游仓库（那三组在没有 orpah-over-halow 时照样跑）。
    实测（p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
2026-09-20 c3-2a: 把 proto/*.c 编进固件（+ Makefile 两条 Windows 实测坑）
    Makefile：新增 PROTO_DIR / PROTO_SRCS（9 个文件）+ build/proto 独立目录规则（不能靠 $(BUILD)/%.o: %.c —— 那会把 ../proto/x.c 的目标算成 build/../proto/x.o，等于把 .o 写回仓） + -I../proto。
    实测：9 个 proto 源全编过（-Wall -Wextra 无告警）、链接成功；size text/data/bss = 2046/0/20224 —— **与接线前逐字节相同**，因为 --gc-sections 把没人调用的 proto 全丢了。
    去掉 recipe 里的 @ls -l $@：Windows 上 make 对**没有 shell 元字符**的行会直接 exec 那个程序（不经 sh）⇒ ls / mkdir -p / rm -rf 都报找不到文件；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
2026-09-20 c3-2a2: 补上 -lgcc 链接缺口 + recipe 不再依赖 sh
    用户拍板两项，均已改完并实测。
    ① LDLIBS = -lgcc，放在 .elf 规则的 $(OBJS) **之后**（静态库顺序不能反）：32 位目标上 jcs.c/sha256.c 会用到 __udivdi3/__umoddi3/__lshrdi3，而 -nostdlib 不自带 libgcc；不加它现在也能过，只因 proto 是死代码。
    ② MKDIR/RMDIR：Windows 走 cmd /c（cmd 是真程序），POSIX 平台仍用 mkdir -p / rm -rf。因为 make 对没有 shell 元字符的行会直接 CreateProcess 那个程序，而 mkdir/ls/rm 都不是 Windows 程序。
    实测（同一台机、干净树）：make clean exit=0（build/ 真删了）；全量 make exit=0，链接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
2026-09-20 c4-b1: P-256 曲线层（素域+群+标量乘+公钥派生），与 OpenSSL 逐字节一致
    proto/p256.{h,c}：素域（32 位 limb + **Montgomery 乘** + 费马求逆）、Jacobian 点运算（加倍/点加/退化情形）、**Montgomery ladder 标量乘**、公钥派生（未压缩点 04||X||Y）、演示私钥派生（同上游 derive_demo_privkey：sha256(orpah-demo-ec-p256-v1|<sn>|<gen>) mod (n-1) + 1）。纯代码：无 stdio/malloc/浮点/string.h ⇒ 可编进固件。
    实测（python proto/run_cross_test.py → exit 0，交叉测试 13 组）：pubkey-selftest 14/14 与 Python(OpenSSL) **逐字节一致** —— 这一条同时证明 p/a/b/Gx/Gy/n 常量、Montgomery 归约、点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
2026-09-20 docs(wiring): 三张接线图直接内嵌进 README（之前只有文字，读起来不友好）
    每张图放在它自己那一节的开头（图与说明在一起），写成 [![图](x.svg)](x.svg) ⇒ 点图可看原尺寸；顶部加一句导航。旧文字/实测记录一字未改，只加图。
    实测验证（不假设“嵌进去就能显示”）：三张 svg ① XML 合法（坏 XML 在浏览器里什么都不显示）② cairosvg 渲成 PNG 均成功（172/188/293 KB，非空白）③ 自然尺寸 664x353 / 692x639 / 871x509 px（96dpi）—— 与 README 列宽相宜。
    并含已验过连接器对象的那张（bstep-ch347f-2txah-evb）渲染实样：线完整、无变形 ⇒ 之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
2026-09-20 feat(proto): c4-beta-2 ECDSA(P-256) 签名 r||s + RFC 6979 确定性 k（对 RFC A.2.5 官方向量逐字节一致）
    新增 proto/rfc6979.{h,c}（K/V 迭代 + bits2octets，只做 P-256/SHA-256）+ proto/ecdsa.{h,c}（r||s 64B，与上游 _sign_es256 同格式）+ ecdsa_cli.c。ecdsa.c 只新写 mod n 的 256 位算术（乘 + 逐位长除法归约 + 费马求逆）；k*G 直接复用 p256_pubkey_from_priv（以 k 为私钥的公钥就是 k*G）。
    判据（run_cross_test.py exit=0，交叉测试 14 组）：k-selftest 2/2 + sign-selftest(官方 r||s) 2/2 ⇒ 对 RFC 6979 A.2.5 官方向量逐字节一致；sign-selftest(本仓 25 行，含 h1>=n 分支) 25/25；OpenSSL 验签通过 C 产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
2026-09-20 fix(soak): 判据 12 由「一帧不丢」改为「链路不许中断」（阈值按实测零假设定，缺口率照实打印）
    背景（两轮实测）：4h = 25/6242、刚跑的 10min = 3/242，缺口率都 ≈0.4%、最长连续都 = 1 拍 ⇒ 这台 demo 台架（开发板 + 家用 LAN + 空口）是「稳定但不无损」。用户 2026-09-20 定：demo 阶段允许些许丢帧。
    ★ 不能简单放宽成 max_stall < 5：连续 5 拍本来就早停 ⇒ 那种判据永远不可能红（假判据比没判据更坏）。另取 SOAK_STALL_MAX=3，来历：p≈0.004、6242 拍下「连续 2 拍」概率 ≈10%（假警报太多）而「连续 3 拍」≈4e-4 ⇒ 避开抖动又保留可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
    [demo_l2_hgic.py]
2026-09-20 docs(wiring): c 步客户端台架接线图（nanoCH32V203 + TX-AH EVB + CH347F 两个 PC 窗口）
    台架：两块板各自 USB 供电、只共地；nano USART2(PA2/PA3) ↔ 模组 UART0(A10/A11) = HGIC 数据口；CH347F P2(UART0) ↔ nano USART1(PA9/PA10) = 我们的 console 窗口；CH347F P3(UART1) ↔ 模组 UART1(A12/A13) = 模组 AT/打印口窗口。
    网表逐脚核过（.fzz 与 .svg 两侧）：蓝 = PA2→模组 A10、PA10→CH347F TXD0；绿 = 模组 A11→PA3、PA9→CH347F RXD0；橙 = 模组 A13→RXD1；紫 = 模组 A12←TXD1；棕 = 三块板共地。四根信号线方向全对（TX→RX）。
    跳线帽已拔（板载 CH340E 与 A12/A13 断开）；CH347F 的 3V3/VIO 空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
    [cstep-ch347f-txah-evb-nanoch32.fzz]
2026-09-20 feat(tools): fzz_nets.py 角色改按部件 ID 认（MOD/MCU/BRIDGE/LED/RES），并录入 c 步台架规格
    原来只有 MOD 是特例、其余角色按实例 title 精确匹配 —— 重画后 U3/U4/U5 会变（两块模组那张图就换过），规格随之失效。改为按 moduleIdRef 认：MOD = 任意 TX-AH 模组、MCU = CH32V203C8T6、BRIDGE = CH347F；没登记的角色仍按 title 匹配（老写法兼容）。
    新增 cstep-ch347f-txah-evb-nanoch32.fzz 的 7 个网（4 信号 + 三块板共地 + 窗口②两路）；核对输出改成打印「图上 = 谁跟谁」，便于一眼定位差在哪一格。
    顺手修掉自己写的一个 print bug：_match 返回的是 (title, 脚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
    [fzz_nets.py]
2026-09-20 feat(firmware): c3-2b 上机全绿 —— 模组数据口双向通（四个真凶：链接基址 / IRQn +16 / mstatus / TIM INTFR）
    台架：nanoCH32V203（我们的固件）↔ TX-AH EVB（UART 版 macbus）↔ CH347F 两个 PC 窗口（COM23 控制台 / COM24 模组 AT）。实测：横幅 + 3 下短闪 + ~1 Hz 心跳、tick 在涨、周期发 GET_UART_FIXLEN 收到模组 CMD 应答（DATA PORT IS UP），模组侧同步看到 [mbus rx]/[mbus tx]。
    四个真凶（都表现为「灯不亮、串口全静默」）：1 链接基址必须 0x00000000（0x08000000 的镜像一条指令都不执行；对照 probe1b 0x0 能跑 / probe1 0x08000000 死）；2 IRQn_Type 必须带 +16 异常号偏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
2026-09-21 docs: 平台层两份独立副本的同步纪律（用户 2026-09-21 定）+ 同源缺陷已回灌的记录
    用户 2026-09-21 判定：两个仓各自独立、各留一份平台层（不抽公共库、不做 submodule）—— 代价是同一处坑不能在一边修完就算完。
    AGENTS §1 新增规则：ld/link.ld、startup/startup_ch32v203.S、Core/ch32v20x.h、Periph/gpio.{c,h}、Periph/uart.{c,h} 这 7 个文件改一侧必须同步另一侧，并各自标清「已上机 / 未上机」（本仓已上机 = docs/c3-2b-bench-bringup.md 的四个真凶）；顺手把该段 openocd 示例里的烧录地址 0x08000000 改成 0x00000000（与链接基址一致）。
    ROADMAP §四/§五 与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
2026-09-21 docs: README 加 b/c 步接线图并同步现状（烧录地址 0x00000000）；AGENTS.md §9 记入图文并茂约定
2026-09-21 docs: README 补图（固件数据通路 / 协议内核判定链）
    - firmware/README.md：加数据通路 mermaid（CH32V203 各外设 → 主循环 → TX-AH 模组），
    并嵌入 hardware/wiring/cstep-ch347f-txah-evb-nanoch32.svg 台架接线图
    - proto/README.md：加判定链 mermaid（Python 参考实现 --refresh→ test_vectors_*.txt
    ← RFC 6979 静态夹具；C 实现 → run_cross_test.py；判定 = exit 0 且输出无 FAIL）
2026-09-21 feat(proto): c4-β-3 —— ES256(level=0) 接进 idr_build()，C 产出的已签报文过上游验签
    - proto/id_report.{h,c}：level=0 走 ES256 = SHA-256(预像) → ECDSA(P-256) → r||s(64B) → b64url，
    与 Python 参考的 Device.report()/es256_sign 逐字节一致；私钥**由参数传入**（32B 大端），
    不写死、不从报文取 —— 规范 §6 的真机是 SE 内生成且不可导出，将来换 ATECC608B 只改调用方。
    - proto/jcs_cli.c：id-report 第 5 列（key-hex）**按 level 分流**（0=私钥 d / 1,2=HMAC / 3=-），
    列数不变（免得改向量格式），帮助文本写清。
    - proto/run_cross_test.py：新增两条 level=0 用例（真机形态 t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
2026-09-22 c4-γ-1：设备侧已签上报接进固件主循环（+ nonce 后端接口化，未上机）
    把「身份 → 已签报文 → 链路信封 → 以太帧」这条流水线落成**一份**源码（proto/id_build.c），
    固件主循环与 PC 侧交叉测试**共用**；固件侧只留薄外壳（Core/id_core.c：周期/自限频/控制台）。
    新文件
    - proto/id_level.{h,c} §8.2 选级 + 故障注入模式表（单一源 = 上游 pick_level / LEVEL_MODES）
    - proto/id_keys.{h,c} 演示密钥材料（EC 私钥 + HMAC 降级密钥；单一源 = 上游 derive_demo_*）
    - proto/id_nonce.{h,c} payload.nonce 的**软熵后端**（可换 SE；公式属本仓定义，见文件头）
    - pr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
2026-09-22 docs(wiring): 接线 README 补登记 c 步台架图（含嵌图 + 接线表）
    `cstep-ch347f-txah-evb-nanoch32.{fzz,svg}` 一直在目录里，但 README 只登记了 b 步三张图
    （标题也写着 b 步）⇒ 问「上机用哪张图」时在这里找不到。本次：
    - 标题改为「台架夹具接线图（b 步 / c 步）」，文件表补一行 c 步那张；
    - 新增「★ c 步台架」一节：嵌入该图 + 接线表（nano PA2/PA3 ↔ 模组 A10/A11 数据口；
    PA9/PA10 ↔ CH347F P2 = COM23 控制台；A12/A13 ↔ CH347F P3 = COM24 模组 AT/日志）+
    跳线帽/3V3 不接/别给数据口敲 AT 三条注意；
    - 写明 **c4 上机只需要这套**（不需要 TH-RJ45 与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
2026-09-22 tools: 加 c4-γ-1 上机判据的一键脚本 check_c4g1_bench.py
    上机时"在哪跑、看什么"要一句话能答上来：这个脚本把三步串起来，判据仍只看**真实字节**。
    - 打开固件控制台串口（默认 COM23/115200）→ 等横幅（证明固件在跑）；
    - 发 `idsend`（默认）→ 固件当场组装一条已签上报并发进模组数据口，等 `[id] sent level=… build_ms=…`；
    - 发 `idhex` → 把刚发出去那一帧的 hex 读回来；
    - 交给**上游** `orpah_id.verify_report` 判一次（与 tools/check_report_hex.py 共用解析/判定，单一源）。
    退出码：0 = 固件在跑 + 拿到帧 + 上游接受；2 = 有环节失败；1 = 用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
2026-09-22 firmware: 修 id_core 的假测量（build_ms 恒为 0）+ 打出上电熵
    上机实测发现：`[id] sent … build_ms=0` —— 因为耗时算的是 `now_ms - t0`，而 `now_ms` 是**入参**、
    全程不变 ⇒ 恒 0。**假数字比没有数字更坏**（会让人以为 8 MHz 上签名不要时间）。修：
    - 读主循环时基 `g_tick_ms`（`extern`，只用于量耗时）来算 `dt`；`0` 就是"不足 1 ms"（如 level=3），
    不再兜底成 1；
    - `id` 里打出 `boot_entropy=0x…`：软熵后端只保证"同一 boot 内不重复"，**跨 boot 撞了整段 nonce 会重**
    （服务端按重放丢弃 = 漏报），把值打出来好一眼看出撞没撞；`id_nonce.h` 的那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
2026-09-22 docs: 回填 c4-γ-1 上机实测（内容判据已过；一条 ES256 ≈ 9.1 s）
    用户刷机重启后，PC 侧一键脚本（tools/check_c4g1_bench.py）实测：
    - PASS 固件活着（AT → OK）；
    - 拿到 395 B 帧；上游 verify_report **接受**（level=0 / trust=high / cap.rtc=false / firmware=0.1.0-c4g1）；
    - ★ 真实耗时 = **build_ms=9107（≈9.1 s）**（8 MHz 上 ES256：费马求逆 + ladder，含取钥/nonce/信封/套帧）
    —— 此前 `build_ms` 恒 0，是假测量（已修）。设计常态 60 s ⇒ 占空 ~15%。
    如实边界（写进 firmware/README.md + ROADMAP §五）：
    - 这 9.1 s 主循环**阻塞**：控制台要等它跑完才回话；模组下行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
2026-09-22 tools: check_c4g1_bench 同时抓模组打印口（拿「帧真的进模组」的证据）
    原来只判"固件产出的帧被上游接受"（内容判据），拿不到"这条 FRM2 真的被模组收下"的证据。
    现在脚本在 `idsend` 前后**同时**读模组 AT/打印口（`--mod-port`，默认 COM24），
    查到 `[mbus rx] <8+len> byte(s)`（8 = HGIC 头）就打 `PASS 模组侧确认…`；
    打不开那个口、或它一点输出都没有 ⇒ 只 **warn**（不当失败，因为那是台架接线状态，不是固件问题）。
    本轮实测（2026-09-22，用户修正接线后）：
    - COM23：`[mod] ctrl type=3 id=109 status=0 len=2` + `**DATA PORT IS UP**` 每 3 s ⇒ **数据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
    [check_c4g1_bench.py]
2026-09-22 docs: c4-γ-1 台架两条判据都过（含模组侧 `[mbus rx] 403 byte(s)` 原始证据）
    用户修正接线后复跑 `tools/check_c4g1_bench.py --port COM23 --mod-port COM24`：
    - 固件活着（`AT` → `OK`）；
    - 帧 395 B、上游 `verify_report` 接受（level=0 / trust=high / cap.rtc=false）；
    - ★ **模组侧确认**：COM24 上 `[393206][mbus rx] 403 byte(s) 2b 1a 09 00 93 01 74 00
    ff ff ff ff ff ff 4a 06 ...` —— 403 = 8 B HGIC 头 + 395 B 帧，type=0x09（FRM2，
    与 2026-09-16 记录同一形状），载荷开头 = 以太帧（dst = 广播 + src MAC）。
    如实记两条边界：
    ① 同一帧后面跟着模组的 `cookie err: last:110, new:116` —— 本固件*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
2026-09-22 firmware: CMD 与 FRM2 的 cookie 计数器拆开（一次一改，验「模组按数据通道查顺序」）
    现场观察（2026-09-22）：`idsend` 那条 FRM2 被模组收下（`[mbus rx] 403 byte(s)`）之后，
    模组打了一条 `cookie err: last:110, new:116`；而中间那 5 条 CMD 探测（cookie 111..115）
    模组**一句都没抱怨**。⇒ 假设：模组**按数据通道**查顺序（拿上一条 FRM2 的 cookie 跟这条比），
    而我们以前 CMD 与 FRM2 **共用一个**计数器 ⇒ 每条 FRM2 的 cookie 天然比上一条大一截（110 → 116）。
    改法（**一个变量**）：`hgic_uart.c` 拆成 `s_cookie_ctl`（CMD）与 `s_cookie_data`（FRM2），
    各自从 1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
2026-09-22 firmware: cookie 拆分**已用对照实验证实**（模组按「数据通道」查顺序）+ 更正旧记录
    重刷 12ef0fb 那版后做对照实验（复位后连发两条 `idsend`，同时抓 COM23 + COM24）：
    | 帧 | cookie | 模组日志 |
    |---|---|---|
    | 第 1 条 FRM2 | `01 00` = 1 | `[mbus rx] 403 byte(s) …` + `cookie err: last:271, new:1` |
    | 第 2 条 FRM2 | `02 00` = 2 | `[mbus rx] 403 byte(s) …` **一句 err 都没有** |
    | CMD 探测（同期） | `11 00`/`12 00` | 模组**不抱怨** |
    ⇒ 假设成立：模组**只拿上一条数据帧（`FRM2`）的 cookie** 跟这一条比，命令帧不参与。
    第 1 条那次 `last:271` 正是"模组的 last 停在**复位前**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
2026-09-22 c4-γ-2: nonce 后端换成 ATECC608B 的 Random(0x1B)（代码 + PC 判据；★上机未做）
    范围（刻意做小）：**只换 nonce 来源** —— 规范 §5.4 要求 nonce 来自 SE 的 RNG。
    签名**仍是软件 P-256 替身**（Slot0 / Sign / Config 锁 / 产线烧录都是 d 步），
    所以 `se_ok` 仍为 1 的含义只是「能做 ES256」，与「SE 在签」不是一回事。
    新增：
    - `proto/crc16.{h,c}` CRC-16/BUYPASS（ATECC 用的那个）。出处 = CryptoAuthLib
    `lib/calib/calib_command.c` 的 `atCRC()`（MSB-first、poly 0x8005、
    初值 0）；**外部锚点** = CRC 目录校验值 "123456789" → 0xFEE8。
    -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
2026-09-22 c4-γ-2: 加一键上机判据脚本 + 固件启动口径改成「实测」（banner 不再写死 SE=NONE）
    `tools/check_c4g2_bench.py`（新，同 γ-1 脚本的口径与退出码）：
    1) 探活（`AT` → `OK`，不靠横幅）；2) 发 `se` 两次 ⇒ 看「唤醒 ACK / 实测 crc_mode /
    32 B 随机数 / 两次不同（RNG 真在动）」；3) `id` ⇒ `nonce_src=se|soft`；
    4) （默认）`idsend` + `idhex` ⇒ 交给**上游** `verify_report` 判一次（与
    `tools/check_report_hex.py` / `check_c4g1_bench.py` **共用同一套判定**），
    可选 `--mod-port` 同时抓模组侧 `[mbus rx]`；最后把 **`crc_mode` / `nonce_src`**
    打出来让人填回 `docs/atecc608b-se.m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
2026-09-22 hardware/wiring: 加 c4-γ-2 台架图（c 步那套 + ATECC608B）
    - cstep-ch347f-txah-evb-nanoch32-atecc608b.fzz / .svg：用户在 Fritzing 里画的（2026-09-22），
    比 c 步那套只多一件 —— 面包板上的 ATECC608B 转接板 + 两只 4.7 kΩ 上拉。
    · .fzz 自包含：21 项 = 4 个 part.*.fzp + 16 个视图 svg（含 ATECC608B 四个视图）；
    · 内嵌的 svg.breadboard.ATECC608B_breadboard.svg 与 fritzing-parts-langhua 仓
    svg/ATECC608B/ 的产物**逐字节相同** ⇒ 用的是最新版件（文字不转动那版）；
    · .svg 头里 width/height/viewBox 三样都在，全矢量（无 <image>，未内嵌位图）。
    - 网表逐条核过（15/15）：P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
    [cstep-ch347f-txah-evb-nanoch32-atecc608b.fzz]
2026-09-22 c4-γ-2 台架图：ATECC608B 标注移进工程（.fzz），文档跟着改
    - 用户把 `ATECC608B` 一行蓝字 + 蓝引线放进了 `.fzz` 工程（挂在面包板那个「logo 图片」项
    `newBreadboardLogoImageModuleID` 的 `shape` 属性上，8709 字符、字的轮廓已转矢量路径），
    并重新导出 `.svg` ⇒ 新图里这段标注挂在 `partID=863345370`（同一项）下，重导出不会丢 ✓
    - 核过的：
    · 导出 svg 结构完好：width/height/viewBox 都在（height 5.2765045in→5.2789645in，字变矢量
    外形后 bbox 差 0.06mm）；文字节点 173（上次手加的 `<text>` 换成矢量组，故少 1）；
    8 个金焊盘、绿转接板 1 块、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
    [cstep-ch347f-txah-evb-nanoch32-atecc608b.fzz]
2026-09-22 hardware/wiring: 两张 cstep 图里内嵌的 nano 面包板换成新版（用户手工版）
    CH32V203C8T6 的面包板视图改成用户手工版之后（补上板载蓝 LED、修正按键位置），把这两张图里
    **内嵌**的那份 SVG 一并换新：
    svg.breadboard.CH32V203C8T6_breadboard.svg 27412 → 50633 字节
    - **只动这一个条目**：其它条目（`.fz` 工程、另 3 个视图、别的零件）与压缩时间戳都原样保留，
    改后逐项比过大小（只有目标项变化）。
    - 焊盘坐标与旧版最大差 0.01mm ⇒ 图里的导线不用重接。
    - ⚠ 两张 `.svg` **导出件仍是旧图**（那是 Fritzing 导出的），要在 Fritzing 里重新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
    [cstep-ch347f-txah-evb-nanoch32-atecc608b.fzz, cstep-ch347f-txah-evb-nanoch32.fzz]
2026-09-22 hardware/wiring: 两张 cstep 图内嵌的 nano 面包板跟到最新版（补回 FPC 12 个触点）
    [cstep-ch347f-txah-evb-nanoch32-atecc608b.fzz, cstep-ch347f-txah-evb-nanoch32.fzz]
2026-09-22 hardware/wiring: 两张 cstep 图的导出件跟上新版 nano 面包板（用户重新导出）
    CH32V203C8T6 的面包板视图改用手工版（补上板载蓝 LED、修正按键/丝印位置）之后，
    用户在 Fritzing 里把这两张图重新导出了：
    cstep-ch347f-txah-evb-nanoch32.svg ← 现在 645933 字节（旧版 561 KB 级）
    cstep-ch347f-txah-evb-nanoch32-atecc608b.svg ← 现在 808131 字节
    核过的（脚本 + 目视）：
    - 两张图里都能找到 `#0066ff`（= 手工版里那颗**蓝色 LED**，旧程序版没有）⇒ 确实是新图；
    - 对角 `CH32V203`、`S2YZ`、两个 USB-C、RST/BOOT、板名 `nanoCH32V203` 都在；
    `ATECC608B` 那行蓝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
2026-09-22 tools/check_c4g2_bench.py: `se` 的原始输出当场打出来（原来被"已收回"吞掉）
    2026-09-22 第一次 c4-γ-2 上机：SE「没应答」⇒ `nonce_src=soft`，但脚本只打一句
    「（第 N 次 `se` 已收回）」，而末尾的「控制台（截尾）」早被模组 chatter 挤满了 ⇒
    **看不到**我们真正需要的证据：`[se] wake: ACK / NO ACK`、`Random FAILED rc=… last_resp_len=… raw=…`
    —— 这三个数正是判断「供电 / 接线 / 上拉 / 响应长度假设」的唯一依据。
    改法：每发一次 `se`，就把该轮读到的所有 `[se]` 行**逐行打出来**（缩进对齐 `rng=` 那种）；
    一条都没读到也明确提示「`se` 命令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
    [check_c4g2_bench.py]
2026-09-22 firmware/Periph: i2c_probe() 在 START 之前等 SB ⇒ SE 永远不应答（c4-γ-2 上机真凶）
    上机现场（COM23 控制台，2026-09-22）：
    [se] wake: NO ACK (ok=0 fail=7) / (ok=0 fail=8)
    [se] 没应答 ⇒ 查三件事：3V3 供电 / SDA(PB7)-SCL(PB6) 接线 / 4.7k 上拉
    [id] nonce_src=soft ← 固件**如实回退**软熵（这一条是设计如此，不是 bug）
    其余全过：上游 verify_report 接受整帧（level=0 / trust=high）+
    模组侧 [mbus rx] 403 byte(s)（8 B HGIC 头 + 395 B 帧）
    真凶（`Periph/i2c.c` 的 `i2c_probe()`，c4-γ-2 引入）：
    rc = wait_flag(I2C_STAR1_SB, …); // ← 在发 START **之前**等 SB
    I2C1-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
    [atecc.c, i2c.c]
2026-09-22 firmware/Periph/uart.c: uart_printf 支持宽度/补零（%08x、%02x…）+ 修「参数带副作用 ⇒ 死循环」
    为什么必须改（2026-09-22 上机踩坑）：`uart_printf` 原来只认转换符 ⇒ 宽度/补零写法被**原样打出来**，
    而这两处恰恰是排障最需要的诊断输出。现场证据：
    · `[id] boot_entropy=0x%08x` 打出了字面量 ⇒ 软熵 nonce 的熵值读不出来
    （于是没法用软熵公式反推 ctr、离线复现设备那一帧）；
    · `[se] … raw=%02x` 的字节转储同样失效（SE 失败时最需要的证据）。
    改法：重写格式解析 —— 支持 `%s/%d/%i/%u/%x/%X/%c/%%` **加宽度与 0 补位**
    （`%08x`/`%02x`/`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
2026-09-22 firmware: 唤醒令牌改成「轮询重发」（手册表 2-2：自检使能时 tWHIST ≥ 20 ms 才收令牌）
    为什么必须改（2026-09-22 把摘要手册表 2-2 逐字核出来的，以前漏了这条）：
    同一张表给的是**两个情形**，而我们只按其中一个实现 ——
    未使能自检：`tWHI ≥ 1500 µs`
    **使能自检：`tWHIST ≥ 20 ms`**
    两行的说明都写着 "SDA should be stable high for this entire duration
    **unless polling is implemented**"；`tPU` 那行还补了 "The power-up delay will be
    significantly longer if power-on self test is enabled in the Configuration zone."
    ⇒ 原来只等 1700 µs、且**只发一次**唤醒令牌 ⇒ 一颗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
2026-09-22 firmware: 加一条工装命令 `seline`（SCL/SDA 当 GPIO 开漏翻转 ~2 Hz，沿路逐点量通断）
    为什么加（2026-09-23 现场调试卡住）：c4-γ-2 的 SE 一直 `NO ACK`，而"用示波器抓那条
    90 µs 的 I²C burst"在现场**极难复现**（一次 `se` 只有 6 段、散在 ~100 ms 里；用户当时的
    时基停在 50 ms/div，90 µs 只占 0.1 个像素）。于是"两条线到底通不通"这件事被**工装**卡住，
    而不是被问题卡住 —— 换芯片之前必须先把这件事变成可测的。
    做法：`Core/main.c` 挂 `seline [1-9]`（不带参数 = 10 s）→ `Periph/atecc.c` 的
    `atecc_line_test()`：
    · 关 I²C 外设，把 **SCL/SDA 都配成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
    [atecc.c, atecc.h, main.c]
2026-09-22 firmware: 工装 `sewake`（不信"唤醒令牌没 ACK"=器件不在）+ `seclk`（I²C 速率可调）
    背景（2026-09-23 现场）：SE 永远 `NO ACK`，而**接线已核对、两种 SDA/SCL 接法都试过、
    总线全好**（`timeout=0`、`nack` 逐帧 +1、`seline` 两条线都在翻）。⇒ 该怀疑的不是线，
    而是**我们自己在"唤醒握手"上做的两个假设**：
    ★ 假设一：**"唤醒令牌（地址 0x00）没 ACK"⇒ 器件不在。**
    手册表 2-2 写的是 `tWHI = "Wake High Delay **to Data Comm**"` —— 即"脉冲 + tWHI 之后
    就可以**数据通信**"；而"地址 0x00 的唤醒令牌"是**器件在 Sleep 态**才应答的东西。
    器件若**已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
2026-09-22 firmware: `seline` 两条线改成**不同频率**（SCL 2 Hz / SDA 1 Hz）—— 让"逐脚量"能得出一张脚位真值表
    为什么（2026-09-23 上机实测推进）：
    · `sewake` 实测：**探地址 0x00 / 0x60 / 0x61 全部 NACK**（0x60 是器件真地址！）
    ⇒ 排除了"令牌没 ACK 只是因为器件已醒"这个假设；
    · `seclk 50` 后 `se` 仍 NACK（`hz=50` 生效）⇒ 排除了"100 kHz 越界"这个假设。
    ⇒ 证据收敛为：**从 MCU 到芯片这一段上，芯片对任何地址都没有反应**
    （NACK = 没人拉 SDA；`timeout=0` = 时钟/驱动都正常）。
    但"接线正确"只在**线**上验过 —— **芯片自己那四只脚上的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
2026-09-22 firmware: 器件地址不再写死 0x60 —— `sewake` 改成**全地址扫描**（脉冲前后各一遍）+ `seaddr` 可手动设
    起因（2026-09-23，用户找到的公开调试记录 + 手册回查）：
    · 手册第 13 页（DS40002239A）明写：**"Programmable I2C address after data (secret) zone lock"**
    —— ATECC608B 的 I²C 地址**是可编程的**，不一定是 0x60。
    · 公开调试记录里 `i2cdetect -y 1` **直接看到 0x35**（8 位 0x6A），而且随后的
    `cryptoauth_test info/sernum -a 0x6a` 真读到了 revision 与序列号。
    · CryptoAuthLib 的地址表里 `0x6A→TA010`、`0x35→SHA104` —— 说明这些非 0x60 地址
    在真实器件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
2026-09-22 se-bench: i2c 全地址扫描 + 器件信息/锁状态 + 一行验收结论
    用户 2026-09-23 要求：还是用 ATECC608B，程序上加 I2C 地址扫描等功能 —— 明早把剩下 4 颗
    焊好逐颗试，希望一颗能过。这一步就是「让一颗芯片一眼判出结论」的工装。
    Periph/atecc.c（工装）
    - `diag_scan()` 扫描范围 0x08~0x7F → **0x01~0x7F**：手册第 13 页写明 608B 的 I2C 地址
    **上锁后可编程**，不能假设 0x60；0x00 是唤醒令牌地址，不探它（两种含义别混）。
    - `sewake` 命中后不再只发一条 Random，而是逐项验：
    ③ `Info(0x30)` 读器件版本 → ④ `Read` 配置区 word 0x15（字节地址 0x54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
2026-09-23 se-bench: 单次 ACK 不算命中 + 先看两线空闲电平（0x64 实测教训）
    现场实测（用户 2026-09-23）：`sewake` **有且只有一次**扫到 0x64(ACK)，
    紧接着 Info/Read/Random 全 NACK。上一版探针一趟只发一次地址 ⇒ 一次毛刺就能冒充器件。
    Periph/atecc.c
    - `diag_scan()`：每个地址**探 3 次、≥2 次 ACK 才算命中**；只 ACK 一两次的
    仍打出来（`[0x64 仅 1/3 ⇒ 偶然，不当器件]`）当线索，但不当器件。
    - 新增 `diag_levels()`：`sewake` 开头把两条线放开（开漏输出写 1）读回真实电平，
    打印 `空闲电平：SCL=x SDA=y` —— 有一个是 0 说明那根线被按住，
    而 SDA 被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
2026-09-23 se-bench: sescan（重复扫描统计）——分开「稳定器件 / 虚焊时有时无 / 纯毛刺」
    现场新事实（用户 2026-09-23）：那个 `0x64` 的 ACK **100% 可复现**（板子是当天刚焊好的）。
    ⇒ 昨天「单次 ACK = 偶然/虚焊」的判断被推翻；「一次 ACK」只能说明**还没测够**。
    要分清必须重复采样 —— 而拿示波器去抓那一下本来就抓不到（用户原话：「我抓不到你说的 SDA，太快了」）。
    Periph/atecc.c / .h
    - 抽出 `diag_probe_n()`（单地址探 3 次 → ACK 次数），`diag_scan()` 与统计函数共用
    ⇒ 「一次探测回合」只有一份定义。
    - 新增 `atecc_diag_scan_stats(rounds)`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
2026-09-23 se-doc: 0x64/0xC8 = SHA 家族默认地址（已核实出处）；0x64 线索更新
    用户 2026-09-23：那个 0x64 的 ACK 现在 **100% 可复现**（板子是当天刚焊的）
    ⇒ 昨天「单次 = 偶然/虚焊」的判断被推翻。
    已核实（CryptoAuthLib 源码，逐条标出处）：
    - `cfg_ateccx08a_i2c_default` → `0xC0`（7 位 0x60）= ECC 家族（ATECC508A/608A/608B）
    - `cfg_atsha20xa_i2c_default` → `0xC8`（7 位 **0x64**）= ATSHA204A；
    另 `python/tests/test_device.py` 的 `ATSHA204A_DEVICE_CONFIG['I2C_Address'] = 0xC8`
    - `harmony/config/device_instance.py` 的 `_DEFAULT_I2C_ADDRESS`：ecc=0xC0、sha=0xC8、
    ecc204/206/TA010=0x66、sha104=0x62、sha105=**0x64**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
2026-09-23 se: ★ 真 bug —— 响应读错字地址（读 0x03，应为 0x00）+ se 不再因唤醒失败早退
    现场（用户 2026-09-23，三颗芯片表现完全一致）：
    [sewake] ① 未脉冲：扫 0x01~0x7F -> 0x64(ACK)（sescan 10/10 轮稳定）
    ③ Info / ④ Read / ⑤ Random 全失败
    [se] wake: NO ACK (ok=0 fail=5 tries=6/6)
    [se] i2c: start=8 tx=42 rx=0 nack=164 timeout=0 hz=100 addr=0x64
    关键读数：**地址被 ACK、命令字节写进去了（tx 在涨）、但响应一个字节也读不回（rx=0）而 nack 在涨**。
    根因（有出处）：我们把**读响应**也用字地址 0x03（那是命令字地址）。
    公开实现里的四元表是：0x00 = 响应（读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
    [atecc.c, atecc.h]
2026-09-23 i2c: 注释纠正字地址（命令 0x03 / 响应 0x00，由调用方给）
    上一提交改的是 atecc.c 的读路径；i2c.c 里那句"ATECC：0x03 = 命令/响应"的旧注释
    没跟着改，会误导下一个人（字地址是**调用方**给的：命令 0x03、读响应 0x00）。
2026-09-23 se-bench: i2c 失败步号 step=（现场直接定位卡在哪一步）+ 三处 SB 时序一致化
    现场（用户 2026-09-23，三颗芯片一致）：
    [se] i2c: start=2 tx=0 rx=0 nack=20 timeout=0 hz=100 addr=0x64
    [se] cmd=4 ok=0 fail=2 resp_waddr=unknown
    关键读数：**tx=0** ⇒ 命令路径连**地址阶段**都没过（tx 只在地址 ACK 之后才开始计数）；
    而同一个地址字节在**扫描探针**里却 ACK 3/3（sescan 10/10 轮）。
    两条路径唯一的实质差别：探针在等 SB 之后**读了 SR1** 再写 DR，写路径没读。
    改动
    - `i2c.h/.c`：`i2c_stats_t` 增 `last_step`，**每一个失败返回点都记号**：
    1 = 等 BUSY 清零超时；2 =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
    [atecc.c, i2c.c, i2c.h]
2026-09-23 se-bench: 命中行加「读方向」对照 + se 先打目标地址（少跑一句 seaddr 就会白测）
    现场教训（用户 2026-09-23）：我让他做的三次速度扫描（seclk 10/50/100 + se）其实全打在
    `addr=0x60` 上 —— **重烧/复位后 `s_addr` 回到缺省 0x60**，而那颗芯片在 0x64，
    所以三次都是必然失败（step=3, tx=0），对 0x64 什么都没测到。
    （有意义的那一半：三种速度表现完全一样 ⇒ 0x60 上的失败与速率无关。）
    Periph/i2c.{c,h}
    - 新增 `i2c_probe_dir(addr7, read_dir)`：可发**读方向**（`addr<<1 | 1`）；
    `i2c_probe()` 变成它的包装（默认写方向），调用点不变。
    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
2026-09-23 se-bench: 写路径逐字节等 BTF+看 AF（堵住"数据被 NACK 却当成成功"的盲点）+ nackbyte=
    现场（用户 2026-09-23，addr=0x64）：
    [sewake] -> 0x64(ACK 3/3, R 3/3) ← 两个方向都 ACK ⇒ **真实 I²C 从机**（伪 ACK 排除）
    [se] i2c: start=14 tx=54 rx=0 nack=422 timeout=0 step=3 hz=100 addr=0x64
    [se] cmd=10 ok=0 fail=2 resp_waddr=unknown (10 kHz / 100 kHz 同形)
    关键读数：每次 `se` **恰好 tx+14**（= 6 + 8 = 两条命令的全部字节）⇒ 我们的字节**都发出去了**；
    但 `rx=0`（或 8 字节 `ff ff ff ff` = 从机什么都没驱动）⇒ **从不回应**。
    发现的盲点（本次修）
    - 原来只等 `TXE` ⇒ 某个字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
    [atecc.c, i2c.c, i2c.h]
2026-09-23 tools: CH347F 当独立 I²C 主机（B 方案）+ 交叉核实文档
    背景：SE 在台架上"地址被 ACK、字节收下、但从不回应"（现场 `tx` 在涨、`rx=0`/全 0xFF、
    `nackbyte=0`）。固件侧能自查的都自查过了 ⇒ 需要一个**完全独立的主机**来判
    "器件不讲 CryptoAuth" vs "我们固件还有 bug"。
    tools/ch347_i2c.py（新增）
    - 子类化已有 `tools/ch347_spi.py` 的 `Ch347`（**同一把 DLL、同一个 iIndex**），加 I²C 部分：
    `CH347I2C_Set` / `SetStretch` / `SetDelaymS` / `SetDriverMode` / `CH347StreamI2C` /
    `CH347StreamI2C_RetACK`（**回 ACK 计数** ⇒ "器件到底 ACK 没 ACK"的独立判据，
    不依赖我们固件里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
    [ch347_i2c.py]
2026-09-23 接线图 + fzz_nets：B 方案（CH347F 当独立 I²C 主机）网表核对
    用户 2026-09-23 新画的 hardware/wiring/cstep-ch347f-atecc608b.fzz 入库，
    并把它的接线规格登记进 tools/fzz_nets.py（改图时先改 EXPECT，脚本直接告诉你差在哪一格）：
    · 数据线 SDA↔SDA（CH347F P5 pin1 ↔ SE pin5）
    · 时钟线 SCL↔SCL（CH347F P5 pin2 ↔ SE pin6）
    · 3V3 ↔ SE VCC（pin8）+ 两只 4.7k 上拉的另一端
    · 共地（CH347F GND ↔ SE pin4）
    · **图上没有 nano** = B 方案（把 nano 固件排除在外；两个主机不同时驱动同一对线）
    工具改动（旧 4 张图结论不变，仍全绿）：
    - 新增 _breadboard_columns()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
    [cstep-ch347f-atecc608b.fzz]
2026-09-23 tools/fzz_nets.py + wiring README：登记 c4-γ-2 那张 SE 图的接线规格
    hardware/wiring/cstep-ch347f-txah-evb-nanoch32-atecc608b.fzz（c4-γ-2：nano 当 I²C 主机）
    登记进 EXPECT —— 规格出处 = hardware/wiring/README.md 的「c4-γ-2 台架」节 + docs/atecc608b-se.md：
    · PB7=SDA / PB6=SCL ↔ SE pin5/pin6，各带一只 4.7k 上拉到 3V3
    · SE 的 VCC(pin8) 与两只上拉的另一端吃 **nano 的 3V3 轨**（部件把那几个电源脚并成一个网；
    ⚠ 与 B 方案那张相反 —— 那张吃 CH347F 的 3V3）
    · 数据口 A10/A11 ↔ PA2/PA3；窗口① TXD0/RXD0 ↔ PA10/PA9；窗口② A12/A13 ↔ TXD1/RXD1；四块共地
    实跑 python tools\f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
2026-09-23 接线图 cstep-ch347f-atecc608b：地线改用 P5 自带的 GND（网表不变）
    用户重存的这张图只动了一处：CH347F 的地从 **connector20**（JP1 那列的 GND，落 A4）
    改成 **connector46**（**P5 第 3 脚的 GND**，落 B4 —— 与 SDA/SCL 同一个排针）。
    现在 SDA/SCL/GND 三根都在 P5 上，只剩 3V3 取自 P2 排针末端（同一 3V3 轨）。
    复跑 python tools\fzz_nets.py hardware\wiring\cstep-ch347f-atecc608b.fzz
    → 4 个规格网仍**全部对上 ✓**（地网 = U3.GND ↔ U5.GND(pin4)，落孔由 A4 变 B4，同列同网）。
    docs/ch347f-i2c-crosscheck.md §2b 同步：原来那句「地取自 JP1 那列（不是 P5 自带的 GND）」
    已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
    [cstep-ch347f-atecc608b.fzz]
2026-09-23 接线图 SVG 入库 + 嵌进 README / 文档（B 方案那张）
    用户导出了 hardware/wiring/cstep-ch347f-atecc608b.svg（228 KB，2026-09-23 13:41）。核对：
    ① 结构：没有 CH32V203/nano，有 P5/JP1/SDA/SCL/VIO 丝印与 ATECC608B 标签；
    ② 浏览器渲染看过一遍：右边 CH347F-EVT-R0-1v0、左边小面包板（绿转接板 = ATECC608B、
    板载丝印 CN + 两只上拉 + 两根黄跳线）、四根跳线（棕=地、红=3V3、蓝/绿=I²C）、无 nano ⇒
    与 hardware/wiring/README.md 里那张 .fzz 的网表一致。
    - hardware/wiring/README.md：表格里去掉「⚠ 暂无 .svg」，B 方案那一节嵌图 + 看图三步；
    橙色三行字（供电/I2C通讯/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
2026-09-23 docs/ch347f-i2c-crosscheck.md：补 2026-09-23 实测 + 一条硬边界（CH347 唤醒不了睡着的器件）
    实测（用户已按 cstep-ch347f-atecc608b 接好线）：
    - 正对照 ✅ xfer 50 → 读出 8 字节 FF；0x50 = CH347F-EVT 板载 24C02
    ⇒ 主机 + DLL + 总线 + 上拉能真的搬数据；probe() 的 ACK 计数在这台器件上拿到非零值
    （地址 0x00 上拿到 0 = 负路径）⇒ “ACK≥1 判有从机”两头都标定过。
    - 扫 0x01~0x7F（写/读两方向，20 kHz 与 100 kHz）：只有 0x50；0x60/0x62/0x64/0x66 一个都不 ACK。
    - 事务里写 0x00 字节当唤醒（90 µs / 450 µs 低）无效；33 字节超长低电平被 DLL 拒（写缓冲上限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
2026-09-23 docs/ch347f-i2c-crosscheck.md：记 14:0x 追 0x64 的结果 + 一条自我纠错
    0x64 确实有器件在 ACK（对不存在的地址 probe 干净 NACK、读直接报错，不返回垃圾）。
    - 写命令 60/60 全部 ACK（Info/Random 都收下）。
    - 读响应 37/60 成功，但每次逐字节相同：04 FF 01 42 FF FF…（与命令无关）；
    不发命令直接读是 04 11 33 43 FF…；CRC 一次都没对上。
    - 用户换了一颗芯片后这套数字一个都没变 ⇒ 这 4 个字节是芯片驱动的还是夹具/DLL 冒出来的
    **仍未判定**（要判它得做“把 SE 整块拔下来再读同一地址”的对照，未做）。
    ★ 自我纠错（教训）：这一轮“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
2026-09-23 B 方案当天收尾：量测事实入库 + 下次的固定流程
    用户 2026-09-23 给的物理事实（都记进 docs/ch347f-i2c-crosscheck.md §4/§5）：
    - SE pin8↔pin4 = 3.29 V 且稳定 ⇒ SE 确实有供电（“没供电”这条排除）。
    - pin5/pin6 到 P5 第 1/2 脚的通断：现场量不了（未做）。
    - ⚠ 取电点变过：3V3 先接 P2 末端，现在接 P5 第 4 脚（丝印 VIO —— I/O 参考电平脚，不是给负载
    供电的输出）。两只 4.7k 上拉在数据期各要 ~1.4 mA ⇒ 下次先改回 P2 末端的 3V3（未验证它能不能
    解释“ACK 时有时无、数据期常失败”）。
    - 仍未判定：把 SE 整块拔下来再读 0x64 的对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
2026-09-23 B 方案：0x64 = SE 已钉死；SE 一挂上就把整条总线拖坏（+ 新增 health 子命令）
    决定性对照（2026-09-23 14:20，用户把 SE 整块从面包板取下，单进程 5 遍）：
    - 扫描只剩 0x50，0x64 消失 ⇒ 0x64 就是那颗 SE（之前“换芯片后数字逐字节不变”的疑点，
    现在解释为：拆下来的那颗本来就一直挂在线下拖总线，两个状态都测不成）。
    - 读 0x64 5/5 失败（与“对不存在地址读会报错”的本底一致）。
    - 读正对照 0x50：SE 在线时 ~50% 成功率 → SE 取下后 5/5 全成功（另跑 health --n 10 = 10/10）。
    ⇒ **SE 一挂上就把整条总线拖坏**（连板载 EEPROM 的读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
2026-10-06 docs: 立创新片实测（0x60/命令全 ACK/总线干净）+ 更正「器件只回 4 字节」（那是 DLL artifact）
2026-10-06 接线图：最小 SE 台架（只有 nano + 608b）入库 + 规格登记 + 文档嵌图
2026-10-06 接线图：最小 SE 台架 + PC 窗口（nano + 608b + CH347F 只当串口）；8 张图全通；记下两处标注与图不符
2026-10-10 wiring/docs: 删掉两张最简 SE 台架图上与图不符的「打印日志」；补 B 方案 10-10 复测与扫标注小工具
    图（hardware/wiring/）
    - cstep-nanoch32-atecc608b.svg：删掉「打印日志」（用户 2026-10-06 改）—— 这张图上没有 PC 串口
    - cstep-ch347f-atecc608b.svg：同样删掉那行（只删该 tspan；`供电 / I2C通讯` 两行一字未动）
    删后校验：SVG 仍能解析 ✓、扫标注工具复核该文件只剩「供电 / I2C通讯」✓
    - README：把「已知两处待删」改成「已删」；并记下两条实测：那些中文标注只在导出的 .svg 上
    （本目录 8 个 .fzz 里一个字都没有），以及扫法
    文档
    - docs/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
2026-10-10 wiring/docs: 新增 I²C 主机自检图（nano 当主机读 CH347F 板载 24C02）+ 登记规格
    - 新增 cstep-ch347f-nanoch32-i2ctest.fzz / .svg（2026-10-10 用户画）：nanoCH32V203 当 I²C 主机，
    CH347F-EVT 只当「PC 串口窗口 + 提供那颗已知好器件」—— 目标是板上 24C02（0x50，挂在 P5 那条 I²C 上）。
    图上没有 SE、没有模组；只有 6 根线 + 两只 4.7 kΩ。
    实测核过（不是"看着对"）：
    · 网表 6 个网逐条对上 ✓（PB7↔SDA、PB6↔SCL、共地、TXD0→PA10、RXD0→PA9）
    · 上拉实例属性 resistance=4.7k（±5% / 0.25W / 400 mil）✓
    · 3V3 只有一个源（nano 的 V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
2026-10-10 firmware: 加 i2crd/i2cwr 两条通用 I²C 工装命令（上机已验：写进去读回来一致）
    固件（firmware/Core/main.c）
    - 新增两条控制台工装命令，读写"字地址型"器件（24C02 一类；ATECC 的 0x03/0x00 同形）：
    i2crd <addr7> <n> [--waddr <h>] 例 i2crd 50 8 --waddr 0
    i2cwr <addr7> <hex…> [--waddr <h>] 例 i2cwr 50 5a a5 --waddr 0
    打印 rc + 数据 + **本命令的计数器增量**（tx/rx/nack/timeout/step/nackbyte，
    因为 i2c_stats 是累计值，直接看会串行）。
    - 时序一行没新写：读走 i2c_read_begin/read_byte/read_end、写走 i2c_write（都在 Periph/i2c.c）。
    - ⚠ 不覆盖 AHT20/SHT3x 那种"先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
2026-10-10 SE 调试：加"写后等就绪 + 命令重试"；并把 2026-10-10 那轮实测与两条纠正记进文档
    起因（本轮实测，证据都在 docs/atecc608b-se.md §8.2）
    - 手工拼"写命令 → 读响应"（用刚加进固件的 i2cwr / i2crd）⇒ 命令包被**完整收下**
    （循环里大量 rc=0、tx=+8、nack=+0），但**读响应扑空** ✗：读回来的是 ATECC 的
    **唤醒响应** `04 11 33 43` ⇒ 结论是"**写通了、读早了**"（器件要么还在执行、要么刚被唤醒；
    而且它会在秒级于醒/睡之间来回）
    固件（firmware/Periph/atecc.c）
    - transact()：写完命令后先 wait_ready()（反复探地址直到器件 ACK；上限 8 ms、间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
2026-10-10 fix(atecc): 响应按 I²C 语义解析（count 1 字节 / 数据偏移 1 / 33·35）+ 4 字节错误包状态码翻文字
    - proto/atecc_msg.{h,c}：count 由"4 字节大端"改为 **1 字节**、数据从 `resp[1]` 起、
    Random 响应 33/35、Info/Read 5/7；新增 ATECC_ERR_PKT_LEN / ATECC_RSP_SIZE_MIN /
    ATECC_STATUS_* 与 atecc_msg_err_pkt_status() / atecc_msg_status_name()。
    出处（**外部权威**）：CryptoAuthLib `lib/hal/hal_sam_i2c_asf.c`(hal_i2c_receive: read_length = rxdata[0])、
    `lib/calib/calib_command.c::isATCAError()`（error packets are always 4 bytes long + 状态码 switch）、
    `lib/calib/calib_command.h`（ATCA_RSP_SIZE_MIN / CMD_STATUS_*）
    - firmware/Per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
2026-10-10 fix(atecc): 唤醒改按 CryptoAuthLib 口径（判据 = 读回 4 字节并读掉它）+ 等响应改"轮询到答地址"、60 ms
    - firmware/Periph/atecc.c：
    · 唤醒判据换成"从字地址 0x00 读 4 字节、应为 `04 11 33 43`"（照 `hal_i2c_wake()` +
    `lib/hal/atca_hal.c::hal_check_wake()`），并且**把那 4 字节读掉** —— 原来只"探地址 0x00"
    不读 ✗，它就留在输出缓冲里，之后读命令响应时读到的正是它（2026-10-10 实测反复读到
    `04 11 33 43` ✗）。
    · 注：对地址 0x00 写 0 字节**本来就不会 ACK**（库里原话 "part will NACK, so don't check for
    status"）⇒ 原来拿"令牌没 ACK"当"器件不在"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
2026-10-10 docs(atecc): 记录"唤醒应答原来没读掉"这一真因 + 本轮实测排除清单与下一步
    - docs/atecc608b-se.md §8.2 新增本段：
    · 唤醒判据按 CryptoAuthLib（读回 4 字节并**读掉**它；对地址 0x00 写 0 字节本来就 NACK）
    · 等响应改"轮询到答地址"、60 ms（依据 = 库里 Random tEXEC 23 ms）
    · 修完后器件仍稳定回 `04 FF 01 42`（状态 0xFF = 命令没被正确收到）
    · **实测排除**：读太早（40 ms）/ 18 种 CRC / 9 种字地址 / 线上字节（24C02 7 字节往返一致）
    / 分段读 / 唤醒应答冒充 —— 六条都排掉
    · ⇒ 只剩器件侧解释；下一步：① 换一颗 SE 对照 ② 用 Micr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
2026-10-10 docs(atecc): 第三颗症状一字不差 + 包长扫描（<7 被 NACK、>=7 整包 ACK）+ 台架两处物理故障（共地/SDA 松）
2026-10-10 docs(atecc): ★根因定案——CRC 算法口径错（原厂 atCRC：数据位低位先喂+寄存器左移）；用原厂库借 HAL 槽位实测四条样本全中
2026-10-10 fix(crc): CRC 换成原厂 atCRC 口径（数据位低位先喂+寄存器左移）—— 旧的标准 BUYPASS 使器件把每条命令判成 bad crc；锚点改用器件/原厂实回字节；交叉测试 16 组 PASS、固件零警告
2026-10-10 docs(atecc): ★硬件当场证明 CRC 修对——命令字地址 0x03 + 新 CRC 后器件执行 Random 并回 35 B（count=0x23、响应 CRC 自洽）；另记 Config 未锁定（Random 回 FFFF0000）
2026-10-10 chore(license): CRC 实现改成本仓自己的写法（等价改写：字节倒位+教科书 MSB-first），不再逐行转写原厂代码；文档补 §8.3 许可与版权（原厂包为专有许可，只作测试参照）
2026-10-10 docs(atecc): 只读摸清出厂状态——608 家族正品、Config/数据均未锁(55 55 与 Random FFFF0000 互证)、I2C 0x60 已使能；并记 sewake 自动改地址撞上 24C02 的假判 bug
2026-10-10 fix(se-d iag): sewake 不再凭地址 ACK 改命令地址——只认能答 Info(0x30) 的候选，否则不改地址也不做后续判据（原 bug：撞上板载 24C02 后所有判据全假）
2026-10-10 docs(atecc): 槽位摸底——GenKey 在 slot 0..4 全被拒(0x0F)，但该现象分不清「非密钥槽」与「Config 未锁」⇒ 改为自己写一份确定的 config；附原厂夹具的 slot2/slot4 口径作对照
2026-10-10 docs(atecc): 打通里程碑——用原厂结构体解出槽位表(Slot0=ECDSA私钥槽/3-4=HMAC)、锁定Config(55->00)、Random 出真随机数、GenKey(slot0) 回 67B 公钥；并记「NACK=还没好，读响应必须重试」这条教训
2026-10-10 fix(se): 等器件备好的上限 60ms -> 250ms——GenKey/ECDH/Write 要 40~50ms(PC 侧实测 GenKey 约 50ms)，原 60ms 只够 Random
2026-10-10 docs(atecc): 收官——固件侧 Random 出真随机数(790D59EB..)、配置区+数据区双双锁定、锁后 RNG 照常；记「看板子输出要用逐行实时工装」教训；备件 3+5=8 颗
2026-10-10 se(nonce): 上机确认 nonce_src=se；修两处判据本身出错——唤醒判据只在'从睡眠被叫醒'时有意义(旧文案会把人带偏)、工装还在等旧格式 wake 行(crc_mode 也误吞 resp_waddr)
2026-10-10 se(d-step): Slot 0 签名打通——台架实测原厂包(Nonce 27 16 43 00 00..30 1A / Sign 07 41 A0 00 00 7B 85)与 67B 签名响应(r||s)，独立实现验签通过+反例被拒；报文层入库(cross-test 29 行全过、包字节当外部锚点)
2026-10-10 se(d-step): 签名器注入点(idr_sign_fn/idb_set_sign_fn)——注入后报文/信封/帧与软件替身逐字节相同、签名器失败按 §8.2 降级到 L1(PC selfcheck 已锁)；真机注入点留给固件
2026-10-10 se(d-step): 固件接上 SE 签名——Nonce+Sign(atecc_sign_digest/atecc_sign_pre)、id_build 装签名器、控制台 sign_src、se 自检打出 r||s(PC 侧用 Slot0 公钥独立验)、工装加两条新判据；待上机确认
2026-10-10 se(d-step) 修上机暴露的真 bug：传输层还按 7 B 算——transact 守卫把 39 B 的 Nonce 包拦下、cmd_write 的 8 B 栈缓冲会溢出；改成单一常量 ATECC_CMD_LEN_MAX(39B) + 两条失败分支不再静音
2026-10-10 se(d-step) 上机全绿：Sign(slot0) 出 r||s、sign_src=se、Slot0 公钥独立验签通过、上游 verify_report 收下 level=0 整帧（密钥库登记这颗芯片的公钥=产线那步）、build_ms 9s->1031ms；工装与文档同步
2026-10-10 docs(se): d 步台架嵌接线图 + 如实记两处与图的偏差(CH347F P5 今天也接了/SE 的 3V3 来源待量)；wiring README 补「两种用法(谁当主机)」
2026-10-10 wiring: 用户改图(P5 的 SDA/SCL 接上、SE 的 3V3 改从 CH347F 出)——按新图更新规格 EXPECT 与 README(两种用法共用一张图/一个 3V3 源)；实测仍差一根线:两只上拉的 3V3 端悬空
2026-10-10 wiring: 上拉的 3V3 那根线已补(接 U7.3V3)——fzz_nets 9/9 全对(exit 0)；README/EXPECT 的待补标记改回已补
2026-10-10 docs(se): §8.10 的「两处与图的偏差」作废——图已按 d 步台架更新(P5 画上、3V3 只从 CH347F 出、9/9 全对)，只留「同一时刻只让一个主机」那条规矩
2026-10-10 wiring(README): 记一条口径——「供电」标注是通用的(指供电这件事)，别当它标错去挪（2026-10-11 用户定）
2026-10-11 tools: 加一键回归 run_checks.py(离线 5 道闸门 + --bench 跑台架) + checks_report.md 入库；顺手把 README 前页过时的「SE 未做」改成已做(d 步全绿)
2026-10-11 SE 产线流程入库 + 报文层三处口径按实测钉死（小端 / 字地址 / param1）
    tools/se_provision.py：read → lock-config → genkey → lock-data → verify（不可逆步骤要 --yes、--record 记台账、离线 --selftest 9 条锚点）。
    实测锚点（原厂栈读配置区 128 B 的四条 Read，docs/atecc608b-se.md §8.12）：07 02 80 00 00 09 AD / 07 02 80 08 00 0A 4D / 07 02 80 10 00 0A 1D / 07 02 80 18 00 09 FD。⇒ param2 是【字】地址（不是字节地址：锁字改 word 0x15，0x54 那个推断作废）且【小端】；param1 两家写法不同但都实测可用（我们 zone 0x00、原厂 0x80 32B 块模式），不拿它当锚点。
    一处真漂移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
2026-10-11 tools/se_provision.py: CH347/USB 层失败给一行可行动判语（不再抛 traceback）
    实测：总线上没有器件应答时 WCH DLL 只报 CH347StreamI2C 失败（CH347 自己在、I2C 初始化也成功）⇒ 现场看不到原因。现在打不开设备 / 传输失败都拦成一行判语 + 该查哪三件事 + 指向 ch347_i2c.py list / scan。
2026-10-11 SE 产线工具：按原厂源码修两个错值；HMAC 槽“能不能写”查清（引证表）
    ★ 引原厂源码（MicrochipTech/cryptoauthlib；只引数值/口径，不搬代码）当场抓出我们两个错 ✗：
    - `Lock(Data)` 的 param1 = 0x81（= LOCK_ZONE_NO_CRC｜LOCK_ZONE_DATA）
    我们原来写 0x00 ✗ —— 那是“锁配置区” ⇒ 会锁错区/只回 0x0F（看起来像“已经锁过了” ✗）。
    - `GenKey` **创建私钥** = 0x04（GENKEY_MODE_PRIVATE）；0x00 是 `calib_get_pubkey()`，
    即“只按已有钥算公钥” ✗（我们原来拿它当“新建”用 ⇒ 新片上会返回一个**不属于槽里那把钥**的
    公钥 ⇒ 登记进密钥库后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
2026-10-11 SE 产线：HMAC 密钥入 SE 的三步已实现（config-hmac / write-hmac / hmac-verify）
    背景：出厂配置里 HMAC 槽（3/4）是 WriteKey=15、WriteConfig=8（**要加密写**），而加密写需要
    一把在 slot 15 里、我们**读不出来**的父钥 ⇒ 那条路对我们实际走不通。用户 2026-10-11 选定 B 路：
    锁配置**之前**把 slot 4 的 WriteConfig 改成 0（明文可写），写完钥再锁。
    新增（tools/se_provision.py，报文形状**全部引原厂源码**，不是猜）：
    - config-hmac：Write param1=0x00（zone，**不带** 32B 位）、param2=字地址 7、数据 4 B
    ⚠ 只能按 4 B 字写：config 前 16 B（序列号）不可写（原厂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
2026-10-11 docs: VIO 已核实 = 3.3 V（2026-10-11 用户实测）—— 4 处「未核实」到办项关闭
    hardware/wiring/README.md ×3 / docs/ch347f-i2c-crosscheck.md §2 / docs/atecc608b-se.md ×3 / tools/ch347_i2c.py 文件头 都改成「已核实 = 3.3 V」；顺带记一条口径：VIO 是 I/O 电平参考，别当电源脚接（3V3 从 P2 末端取）。checks_report.md 用 C:\Python313 重跑（本机 python 现在是 3.14、缺 cryptography ⇒ 交叉测试假红，5 道闸门其余 4 道当时也全 PASS）。
2026-10-11 firmware(help): 补上 print_help() 漏登记的两条（help / se）
    原因：2026-10-11 用户贴出 help 输出核对时发现表里没有 se（它在 idc_console() 里实现、能用）与 help 自己 ⇒ 各补一行，只改字符串、不动逻辑。列宽照其余行对齐到第 15 列。回归：5 道闸门全 PASS（固件编译零 warning，已真的重编 main.c）。⚠ 要看到新表得重烧固件 + 按 RST。
2026-10-11 firmware(stat): stat 的四行输出改用 [stat] 前缀（原来借用 [mod]）
    只改 print_stats() 那四条字符串；别处的 [mod]（FRM2 / ctrl / 周期探测 do_ping）是模组口的事件、不是 stat 的读数，保持不动。回归：5 道闸门全 PASS（固件零 warning，已重编 main.c）。⚠ 生效要重烧固件 + 按 RST。
2026-10-11 firmware(ping): 手动 ping 打 [ping]（周期/上电仍 [mod]）；顺带修那句永远打不出来的“没应答”
    ① do_ping(int manual)：手动(console ping)=[ping]、周期与上电探测=[mod]。两者格式完全相同，只能靠 tag 认“这一行是谁打的”（2026-10-11 用户就因此认不出哪条是自己的 ping）。三处调用点都补了实参：console=1 / 上电=0 / 每 3 s=0。
    ② 主循环里两个 3 s 判断**换顺序**：先判“上一条没应答”、再发下一条 ⇒ [mod] no reply in 3s … 才会真的出现（原来 do_ping() 每次都把 g_ping_deadline 又推后 3 s ⇒ 紧接着的超时判断恒为假 ⇒ 那句是死代码）。周期仍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
2026-10-11 firmware(seline): 接受多位数字 + 每拍读回实际电平，报“有线被顶着”
    ① 解析原来只认一位数字 ⇒ seline 10 被当成 1 s（2026-10-11 用户实测踩到 ✗）⇒ 改成多位十进制（上限仍由 atecc_line_test() 夹到 30 s）。
    ② 每拍驱动后读回（同 lines_free() 口径：开漏写值 + 50 us 上拉等待 + gpio_get_pin）：驱动 0 读到 1 / 驱动 1 读到 0 ⇒ 有线被顶着（短路 / 两线互短 / 被别的源拉死）⇒ 逐拍标 **不一致** ✗，收尾打“读回不一致 N/M 拍”。⚠ 明确写进输出与文档：**“没接”这个判不了**（悬空的脚会跟着驱动走）⇒ 那一条仍要万用表量通断。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
2026-10-11 firmware(i2c): 连续超时/总线错自动 SWRST 自愈；sewake 结论改为按计数分档
    ① i2c.c：i2c_probe_dir / i2c_write / i2c_read_begin 拆成 *_raw()（原样）+ 公开入口（maybe_reinit() → 跑 → note_rc()）⇒ 自愈只发生在**事务之前**（中途复位会把刚建立的握手打断 ✗）。判定 = IT_TIMEOUT/IT_BUSERR/IT_ARB 连续 3 次 ⇒ 打一行 + i2c_init()（含 SWRST）；**NACK 不算失败**（那是正常答案）。阈值 I2C_FAILS_BEFORE_REINIT 放 i2c.h（单一源，sewake 提示也引它）。
    ② atecc.c：sewake 结论**按计数分档**（nack>0 ⇒ 地址发出去了没人 ACK，才轮到器件/接线/共地/上拉；nack=0 且 timeout>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
2026-10-11 docs(se): §8.15 记 2026-10-11 晚——最小台架整条判据链全绿 + 当天四个真因（地 1.5kΩ / 外设卡死 / 新片 Sign=0x0F / 脉冲必需）
    含：实测输出与 PC 侧独立验签结果；两种 nack 形状的判据表；自愈与结论分档（b24f305）的来历；seline 读回能反证“上拉存在”但判不了“没接”；以及装机口径一条——SE.pin8↔pin4 = 3.3 V **不能**当供电判据（地悬空时照样读 3.3 V），要对 nano.GND 量。
2026-10-11 tools(se): 不再用「探地址」等就绪（它会把 CH347 的 I2C 引擎搞死）+ 失败重开会话重试
    起因（实测）：se_provision.py read 卡在第 2 块、抛 CH347StreamI2C 失败。量出真因 = 我们那条「探地址」事务（START+地址+STOP、不带数据）会把 CH347 的 I2C 引擎搞死 ⇒ 3/12 vs 固定等待 12/12；整份 128B（4 块 x 5 轮）20/20。
    se_provision.py：删掉 _ready() 的探地址轮询 ⇒ 固定等待（WAIT_MS_DEFAULT/CRYPTO，台面余量、不是 tEXEC）；加 _dll()（DLL 报错 ⇒ 关设备+重开 ⇒ 重试本步，有界且计数可见）；有状态命令不许自动重发（GenKey 创建 / SHA HMAC_UPDATE / HMAC_END）。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
2026-10-11 se: 只读 HMAC 半证过关（hmac-readonly）+ 修「count=4 的状态包被当成错误」
    背景：Se.sha_hmac() 的三条命令（SHA HMAC_START/UPDATE/608 HMAC_END）是照原厂源码写的、此前从未在硬件上跑过；hmac-verify 要先写槽 4 ⇒ 只能在新片跑；已锁的片子写不了（数据区锁了、配置区也锁了 ⇒ WriteConfig 也改不了）。
    做法（用户选 B）＝ se_provision.py hmac-readonly（只读、一个字节也不写）：挑可读槽（默认 slot 8：SlotConfig 0x0000 ⇒ IsSecret=0/ReadKey=0）读 32 B 当已知钥 ⇒ 器件内 HMAC vs 软件 HMAC 逐字节比对；两条消息 23B（START+END）与 100B（多走一轮 UPDATE）。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
2026-10-11 se(产线): 修两条自己的错——判据别拿每颗都不同的身份字节比 + 步骤顺序（数据区写必须在 lock-config 之后）
    ① read 的「与参照一致」判据太严：新片的 7 处差异恰好全落在 cfg[0..15]（SN 12B + 出厂字节，每颗都不同）⇒ 会把每一颗新片都拒掉；改成判「功能位段 cfg[16..127]（跳 86/87 锁字节）」、身份差异降为 info。
    ② 步骤顺序反了（实测撞出来）：write-hmac 放在 lock-config 之前 ⇒ 器件回 0x0F cannot execute；对照实验（写 slot 8 也被拒）证明与槽/IsSecret 无关，是器件状态（未锁配置时拒一切数据区写）。STEPS 改成 config-hmac → lock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
2026-10-11 se(产线): 第 1 颗新片整条跑通 + 两道新闸门（创建后立刻重算 / verify --pub-hex）
    新增闸门①：step_genkey 创建完立刻用 GenKey(0x00) 重算公钥并逐字节比对 —— 在 lock-data 之前就能判「创建那步真把私钥写进槽了」，判不过就停（片子还救得回来）。缘由：0x04 那档原本只是引原厂源码，若没生效要等锁后才暴露 ⇒ 片子就废了。
    新增闸门②：verify --pub-hex（X||Y 各 32B 的 hex）—— 不给就只能「报公钥」比不了（只有 all 里才带内存中的登记公钥）⇒ 单独跑 verify 的判据会静默退化。
    第 1 颗实测（逐步）：read / config-hmac / lock-config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
2026-10-11 se(产线): 第 2 颗 all exit 0（可重复性对照成立）+ 修三处「只有连着跑才暴露」的问题
    ① 快照传导：step_lock_config 原来只回 rc、不回新 cfg ⇒ write-hmac 的守卫拿到锁前快照（0x55）误报拦下；改成回传锁后 cfg + 守卫自己重读当前状态。
    ② 判据要能续跑：config-hmac 先判 WriteConfig 是否已为 0（是就 PASS，且与参照比对时排掉本步管的 byte 28/29）；read 改成「多个已知好状态任一命中即可」（出厂 / 已跑 config-hmac），并打印命中的是哪一份。
    ③ 0x11 唤醒应答混进命令响应（重开会话自愈之后读到输出缓冲里的旧内容，与 §8.8 同形状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
2026-10-11 se(产线): 台账记 SE 序列号 + 四处韧性修正（第 3 颗 all exit 0）
    ① 台账/se_sn：取原厂结构体的 SN 三段 SN03(4)+RevNum(4)+SN48(5) = cfg[0..12] 13B（出处 cryptoauthlib/device.py 的 Atecc608Config，不是猜的）；read 也打印它。
    ② cmd() 把「0x11 唤醒应答 / 0xFF bad-crc / 不在原厂状态表里的值（实测 0xEE = 缓冲脏字节）」统一当「没读到这条命令的响应」⇒ 重同步 + 重发，并打印是哪种（第 3 颗一轮里扭过 4 次）。
    ③ genkey 幂等：数据区已锁时创建必然 0x0F ⇒ 改成按槽内已有的钥算公钥（不写芯片）；创建是否真生效改由 lock-data 之后的 verify 证明。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
2026-10-11 docs(SE): 3 颗新片跑完整条产线 + 公钥登记进服务端密钥库 + SN 定名 T1AN1V（§8.22）
    ① se1/se2/se3 三颗全通过（双锁 00/00、私钥、HMAC 钥、独立验签）—— 见 §8.19–§8.21。
    ② 公钥与降级钥已登记进服务端密钥库（orpah-over-halow/orpah.db；工具 = orpah-over-halow/import_keys.py，提交 16626f2；写库前先把真库备份到仓库外）。服务端从此能验这 3 颗的 ES256 报文。为什么要另写导入器：现成两条登记路都走 oid.Device(...) ⇒ 演示派生密钥，登不了真机公钥。
    ③ SN 定名（用户定，机构码取中文名「天逯」）：拼音 TIANLU 命中 Crockford 禁用字符 I L U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
2026-10-11 docs(SE): 第 4 颗 all 一次到位 + 入库 + 补上「库里公钥验芯片实签」终局判据（§8.23）
    ① 第 4 颗（测试座）全 8 步一次过（第一次一次过）：双锁 00/00、genkey 创建后重算公钥逐字节相同（途中 0xEE 脏字节自愈重发 2 次）、器件内 HMAC = 软件、verify 独立验签 + 反例被拒、中途自愈重开会话 1 次；台账一行写全。
    ② 独立验签用另一份实现（cryptography，不是本仓那份）+ 台账公钥 ⇒ PASS，反例被拒。
    ③ 终局判据补上：从 orpah.db 只读取 pubkey_pem ⇒ 验芯片现场 Sign ⇒ PASS（+ 反例被拒）⇒ 服务端拿库里这把钥能验这块芯片。边界如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
2026-10-11 proto(sn): 1 位校验改为 Damm32（协议 v1.21）—— C 侧跟上游，交叉测试零偏差
    起因：协议 §3 定稿「1 位 = Damm32（唯一）」（见 Protocol 提交 48596a7）。C 侧原按长度分流：1 位走 Luhn32 ⇒ 会把 Damm32 的 SN 全判不合格。
    改动：① proto/sn.c 新增 sn_compute_check_damm32 / sn_verify_check_damm32（拟群 T[x][y]=2*(x^y) on GF(2^5)，p(t)=t^5+t+1；用 sn_collect_digits 的索引序列，与 Python damm32.py 的 crockford_index 口径一致；跳 - 分隔符、非法字符按不通过）；② sn_verify_check 的 1 位分支改走 Damm32；③ 补 #include <stdint.h>（域运算用 uint8_t；freestanding 编译器自带，不引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
2026-10-11 fix(SE): 0x03 的真因是「器件还在收尾」而非包写错 —— HS256 降级整条跑通（§8.24）
    目标（协议 §8.3 降级路径）：设备用 SE 里 slot 4 的 HMAC 钥（钥不出芯片）对报文预像算 HMAC ⇒ 拼 level=1 报文 ⇒ 上游 verify_report + 密钥库接受。
    结果（真机实测）：level=1/HS256 ⇒ accepted=True trust=medium；level=0/ES256 ⇒ accepted=True trust=high（回归）；HMAC 翻 1 bit ⇒ signature_invalid（反例控制）。
    真因（量出来的，取代先前两个错误猜测）：0x03 既不是命令失败也不是包写错 —— 是器件还在给上一条命令收尾。证据：① 命令间不留间隔 ⇒ 长度扫描 19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
2026-10-11 proto: 签名器注入改成按算法分流（ES256 / HS256）
    - idr_sign_fn 增加 alg 参数：ES256 出 64B r||s、HS256 出 32B HMAC。
    这样固件只需注入**一个** provider（真机 = 同一颗 ATECC608B），
    不用为降级再开第二条注入路。
    - HS256 优先走注入器（真机 = SE slot 4 那把 HMAC 钥，钥不进 MCU 的 RAM），
    注入器失败或未注入时**回退**本地 hmac_key。
    为什么失败也要回退（交叉测试抓出来的）：注入器失败模拟的是 SE 不答 ⇒
    那是 ES256 这条路走不通 ⇒ 协议 §8.2 Step2 对它的处理**正是降到 L1**；
    若降级后仍只认那个坏掉的注入器，降级就永远救不了场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
2026-10-11 d 步（固件侧）: HS256 也接到 SE —— 一个注入点管两种算法（未上机）
    目标: level=1 时不再用 MCU 里的演示 HMAC 钥, 而是让器件自己算
    （钥在 slot 4 里锁着、读不出来 => 只能在器件内算）。
    - proto/atecc_msg.{c,h}: 新增 SHA(0x47) 三连的**纯函数**包构造
    （sha_start/update/hmac_end + resp_sha）；带数据的包抽成唯一一份 cmd_data()
    （Nonce 也改走它，字节与改前逐行一致）。ATECC_CMD_LEN_MAX 39 -> 71
    （UPDATE 满块 = 1+1+1+2+64+2）—— 最长包是个会变的数, 别写死在别处。
    - firmware/Periph/atecc.{c,h}: atecc_sha_hmac() 分块喂器件 + 0x03 递增退避重发
    （安全性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
2026-10-11 tools: check_report_hex.py 加 --from-keystore（用真库里产线登记的钥验）
    背景: d 步的报文是 SE 里签的, 而工具原来一律用 o.Device(sn, gen) 自己派生一把
    **演示钥** 去 register => 拿演示钥验真芯片的帧必然 signature_invalid
    （那不是芯片的问题, 是尺子拿错了）。
    - 新增 --from-keystore: 用 keystore.KeyStoreDB(orpah.db) 读**真库**里登记给该 SN 的钥
    （ES256 取 pubkey_pem / HS256 取 hmac_b64; verify_report 按 SN 自己查）=>
    一条命令同时能验 level=0 与 level=1（把 §8.22 那条“用库里公钥验芯片实签”常设化）。
    - --selftest 也接受真库（可组合）, 便于一条命令自证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
2026-10-11 firmware: 两种签名各自的成功/失败分开打进控制台（上机一眼可判）
    - Periph/atecc.c 的 se 自检: 在原有 cmd/ok/fail 那行后加两行
    ES256 Sign slot 0 ok/fail 与 HS256 SHA HMAC slot 4 ok/fail。
    为什么要分开: 合成一个数就看不出 HS256 到底有没有真走 SE。
    - Core/id_core.c 的 id 状态: 同样分开报一次（se_hits 一行）。
    - 判据（上机）: idlevel l1 后跑一次 idhex/idsend => HS256 ok 应当 +1;
    若 ok=0 且 fail>0 => 器件没算成, 看上面的 0x03/降级日志。
    闸门: tools/run_checks.py 5/5 PASS（固件零 warning, text 46012 -> 46268）。
2026-10-11 docs: 记下真凶表第 5 条 —— CH347F 仍在 I2C 总线上会让从机全不答
    现象（2026-10-11 上机）: 烧好固件后 se 全 NACK; 而且拿 i2crd 50 8 --waddr 0
    打**板载 24C02**（另一颗芯片）**也不答**; seline 5 的 20 拍读回 0/20 不一致
    （io 与上拉都好）, 空闲电平 SCL=1 SDA=1。
    真因: CH347F 的 P5 的 SDA/SCL 还并在同一条 I2C 上 —— 即使没跑它的脚本
    （未使能时高阻, 所以空闲读到 1 1）, 只要插着 USB 就会把从机的应答吃掉。
    做法: 固件当 I2C 主机时, 把 P5 那两根 I2C 跳线摘掉（UART 那两根留着给控制台）。
    实测: 摘掉后 se 立刻全好 —— 唤醒 / Random(0x1B) 32 B /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
2026-10-11 firmware: 支持把 SN 换成正片入库的那颗（idsn 命令 + 缺省改成桌上这颗）
    缺口: 固件原来用**演示 SN**, 而入库的 4 颗 SE 各有自己的 SN;
    上游 verify_report 按**帧里的 SN** 去查库 => SN 对不上 => 只能拿演示钥去验
    SE 签的帧 => 必然 signature_invalid。那不是签错了, 是**尺子对不上号**。
    - id_core.h: IDC_SN_DEFAULT 改成 CN-T1AN1V-X3HANM2E20-H
    （= §8.23 第 4 颗, 公钥已登记进 orpah-over-halow/orpah.db;
    用库里的公钥逐把验 se 的签名认出来的）。
    - id_core.c: 抽出 _install_providers() 与 _reinit_with_sn();
    新增控制台命令 idsn <SN>（重建流水线 + 重装两个 provider =>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
2026-10-11 tools: which_chip.py 入库 —— 用库里的公钥认出"桌上这颗 SE 是哪一颗"
    为什么需要它（2026-10-11 上机踩到的缺口）: 固件里原来用**演示 SN**, 而入库的每颗 SE
    各有自己的 SN; 上游 verify_report 按**帧里的 SN** 查库 => SN 对不上 => 只能拿演示钥
    去验 SE 签的帧 => 必然 signature_invalid。换一颗芯片的第一步就是**认出它是哪一颗**,
    再把固件 SN 设成它（控制台 `idsn <SN>`）。
    做法: 直读 orpah.db 的 keys 表（读 pubkey_pem; **不猜**上游 KeyStoreDB 的方法名/字段名 ✗),
    用 Prehashed(SHA256) 逐把验 `se` 那条签名（口径同 docs §8.23 那次临时脚本）。
    上下游目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
2026-10-11 firmware(SE): HS256 序列不再"探地址"等就绪（改固定等待，同 PC 侧口径）+ 打出每条包
    现象（2026-10-11 上机，烧了新固件后）: level=1/HS256 出帧看似正常，但
    se_hits: HS256 slot 4 ok=0 fail=3 —— 日志是
    START ok -> UPDATE(0..63) ok -> UPDATE(64..127) ok -> UPDATE(128..) 连续 3 次回
    0x03（重发间隔 600/1200/1800 ms 也不管用）=> 上游 verify_report: signature_invalid
    （预期之内: 器件根本没算出来）。
    分析: 0x03 等了 3.6 s 都好不了 => 不像"器件还在收尾"（PC 侧实测那种是**交替**
    出现、隔 50~150 ms 就好）=> 更像"这一段命令序列本身把器件搞毛了"。
    可疑点 = 固件在每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
2026-10-11 firmware(SE): SHA 序列补上"实际搬运字节数"（tx/rx/nack/step）—— 用来定死 0x03 的成因
    背景（今晚已上机两次）:
    ① 有探地址那版: START ok -> UPDATE1 ok -> UPDATE2 ok -> UPDATE3 连续 3 次 0x03
    ② 改成固定等 150 ms 后: START ok -> UPDATE1 ok -> UPDATE2 连续 3 次 0x03（更早 ✗）
    => 改动没帮上忙; 但两次都拿到了**原始包 hex**, 并且用已对拍的 CRC 实现验过:
    三个包（7/71/71 B）的 count/param1/param2/CRC **全部与算法一致** ✓
    （START 那条还与真机实发字节 0747040400ae47 逐字节相同 ✓）
    => 包是合法的 ✗ => 剩下只有两种可能: (a) 字节没真搬出去 (b) 器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
2026-10-11 docs(SE): §8.26 —— HS256 长消息算不出来；并抓到 param2 填错（64 应为 0）
    背景: 固件侧 HS256 上机 se_hits=0 fail=3 => 转 PC 侧（CH347，同是那套已"验证过"的
    通路）用**同一颗**芯片对照，才把范围压下来。
    ① 真 bug: `HMAC_UPDATE` 的 param2 应当填 **0**，不是 64 ✗
    实测(slot 8，可读槽，100 B): param2=64 => 挂; param2=0 => ★ 逐字节相同 ✓
    原因: 长度本来就在 count 里（count = 1+4+数据+2）=> 多填反而被当别的参数解析。
    三处同源要改: tools/se_provision.py 的 Se.sha_hmac()、
    proto/atecc_msg.c 的 atecc_msg_sha_update()（固件走同一份）。
    ② 长消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
2026-10-11 SE: HMAC_UPDATE 的 param2 改成 0（实测 ✗ 不是块长 64）—— 三处同源
    实测（2026-10-11，slot 8 可读钥 ⇒ 能自己判对错；同一条 100 B 消息）:
    param2 = 64（旧） => 失败（0x03 / 0x0F 不定）
    param2 = 0 => ★ 器件内 HMAC 与软件 HMAC **逐字节相同** ✓
    原因: 数据长度本来就在 count 里（count = 1+4+数据+2）=> 多填一个 64 被器件当成别的
    参数解析 => 后续任一条命令被拒。
    ⚠ `START` 的 param2（key slot）与 `END` 的 param2（尾块长度）**都是对的** ✓
    （21/100/129 B 三种长度都逐字节相同）=> 没一起改 ✗。
    改动: tools/se_provision.py（sha_hmac）、proto/atecc_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
2026-10-11 SE: HMAC 的"尾块"不能为空 —— 最后一块留给 END（PC + 固件同源）
    实测（2026-10-11，slot 8 可读钥 ⇒ 能自己判对错）:
    · 64 B 单块**直接走 END**（param2=64 + 满块数据）=> ★ 逐字节相同 ✓
    · 而"长度是 64 的整数倍时，先 UPDATE 最后一块、再发**空尾**" => 被器件拒（0x03）✗
    => 规律: 尾块非空（21/100/129 B ✓、64 B 满块 ✓）都通过; 空尾不行 ✗
    改动: 分块循环条件 `>=` => `>`（留一块给 END）; PC 侧（Se.sha_hmac）与固件
    （atecc_sha_hmac 的分块）同源改。`param2=0` 与 START/END 的 param2 不动 ✓。
    ⚠ 仍未解决（如实）: 需要**多条 UPDATE** 的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
2026-10-11 SE: HMAC_UPDATE 的 param2 按原厂源码改回 64（§8.27）+ 多块仍未通（如实）
    出处 = 原厂 MicrochipTech/cryptoauthlib（不靠试出来）：
    calib_sha_hmac_update() -> calib_sha_base(..., SHA_MODE_HMAC_UPDATE, 64, block, ...)
    calib_sha_hmac_finish() -> calib_sha_base(..., ctx->block_size, ctx->block, digest, ...)
    calib_sha_base(): packet->param2 = length；atSHA(): txsize = 5 + param2
    => UPDATE 的 param2 = 本块字节数(64)、END 的 = 尾块字节数(可为 0)、START 的 = key slot，
    三者各按各的，且 count 与 param2 必须自洽。
    改四处同源（+ 断言 + 注释）：
    proto/atecc_msg.c atecc_msg_sha_update()
    proto/atecc_cli.c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
2026-10-11 SE: SHA/HMAC 序列的真凶 = 命令之间等太久 ⇒ 器件睡掉丢上下文（多块已通）
    真因（量出来的）：器件一旦在 SHA 序列中途睡下去，SHA 上下文就没了 ⇒ 后面每条命令都回
    0x03，而且**重发那一条永远救不回来**（必须从 START 整条重来）。这解释了之前所有怪现象：
    挂第 1 条 / 挂第 2 条 / 挂 END 都是随机位置。
    实测（hmac_seq2.py，判据 = 与软件 HMAC 逐字节相同）：
    命令间 800 ms ⇒ 连 23 B（只 START+END）也挂 ✗✗
    命令间 150 ms（旧値）⇒ 时好时坏 ✗
    命令间 0 ms + 就绪等 30 ms ⇒ 364 B（5 条 UPDATE）2/3 ✓
    + 整条重来 <=4 次 ⇒ 6/6 ✓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
2026-10-11 固件(SE): SHA/HMAC 时序同步 PC 侧真凶修复（整条重来，未上机）
    与 PC 侧同一套时序（同一颗芯片上量出来的，§8.27）：
    器件一旦在 SHA 序列中途睡下去就丢上下文 ⇒ 后面每条命令都回 0x03，
    而且重发那一条永远救不回来（必须从 START 整条重来）。
    改动（firmware/Periph/atecc.c）：
    ATECC_HMAC_STEP_GAP_MS 150 -> 0（命令之间故意不等；旧注释那句"无间隔会 9/19 失败
    ⇒ 加 50/150 ms"是在 param2 还写错时量的，已作废）
    ATECC_READY_FIXED_MS 150 -> 30（SHA 一条只算 64 B，实测 ~10 ms 就完；等待本身就是
    给器件睡下去的窗口）
    新增 A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
2026-10-11 固件(SE): 上机首测有进步 + SHA/HMAC 时序做成控制台旋钮 setime
    首测结果（2026-10-11 22:48，idlevel sign_fail -> idsend -> idhex -> 真库验）：
    进步：以前第 2 条命令就挂，现在能跑到第 4~5 条；失败状态从 0x03（上下文丢）
    变成 0xEE（读回来是脏字节）=> "别让它睡"这条修对了，剩下的是读早了/读晚了。
    判据仍未过：signature_invalid（HMAC_END 没过 => 没有真 HMAC）。
    做法调整：SHA 序列的时序要试好几组，而每次都要重烧固件 => 太贵。
    新增控制台旋钮（只影响 SHA/HMAC 段，其它路径一点不变）：
    setime [<poll> [<ready_ms> [<gap_ms>]]]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
2026-10-11 SE: d 步 HS256 端到端跑通 + 真凶定案（SHA 段的就绪判据必须是"探地址"）
    终局判据（同一块板、同一次会话，上游 verify_report + 真密钥库 orpah.db）：
    ES256 level=0 407 B accepted=True trust=high
    HS256 level=1 364 B accepted=True trust=medium
    id 状态：se_hits: ES256 slot 0 ok=10 fail=0 / HS256 slot 4 ok=4 fail=0（两把钥都没出芯片）
    真凶：s_poll_ready 那个开关，我原先把 SHA 段"关掉探地址"是错的。
    PC 侧 §8.16 那条"探地址事务会把传输层搞死"是 CH347 自己的毛病，不是器件的要求
    => 它是 PC 侧的规避；固件（nano 直驱）跟着关就错：关掉后只能猜"等多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
2026-10-11 固件(SE): setime 扩到 5 个旋钮（加 restart_gap_ms / restarts）
    动机：上机实测 HS256 单趟成功率不满（三次运行形态一致：第 1 趟挂 HMAC_END 的 0x03、
    第 2 趟挂 HMAC_UPDATE@128 的 0xEE、第 3 趟成功），靠"整条重来 <=4"兜住。
    要把这条尾巴收掉就得试"重来间隔 / 重来次数"，而每试一组要重烧固件 => 太贵。
    改动：
    atecc.c/atecc.h：atecc_sha_timing_set/get 扩到 5 个参数
    poll / ready_ms / gap_ms / restart_gap_ms / restarts
    新增运行期副本 s_restart_gap_ms(=20) / s_restarts(=4)，sha_hmac_body 用它们
    id_core.c：setime 支持最多 5 个数值；id 状态行打出全部 5 个
    main.c：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
2026-10-11 固件(SE): setime 加第 6 个旋钮 wake_each（序列中间要不要每次发唤醒令牌，缺省 1 = 现行为不变）
    可疑点：器件本来就醒着时，那个唤醒令牌是序列里唯一多余的 I2C 事务，而失败位置又是随机的（第1/2/3条都挂过）=> 值得单独关掉试一次。不能全关：PC 侧实测一条都不发连 100 B 也挂（器件在命令间隙会睡）；所以语义是每趟第一条 START 必发、中间的由这个旋钮定。
    实现：sha_txn() 加 wake 参数（START 传 1，UPDATE/END 传 s_wake_each）；s_wake_each 缺省 1（行为与改前逐字节相同）；atecc_sha_timing_set/get 扩到 6 个参数；id 状态与 help 同步。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
2026-10-11 SE: 真凶 = 序列中间的唤醒令牌（关掉它 HS256 单趟就成）—— 缺省 s_wake_each=0
    六旋钮扫下来（同一颗芯片、同一条 364 B 预像）：wake_each=1 => 要 2~3 趟整条重来才成（build_ms 3983/5520 ms）；wake_each=0 => 单趟就成（480 ms）。把 restarts 改成 1（完全不重试）连跑 3 次：3/3 单趟成功（480/480/557 ms），上游判据 accepted=True level=1 trust=medium（build_ms~481）。
    机理：器件本来就醒着时，那个唤醒令牌是白送的额外 I2C 事务，而它是序列里唯一的多余动作 => 它会把 SHA 上下文打断（0x03 上下文丢 / 0xEE 脏字节，位置随机）。这也解释了'两种主机症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
2026-10-11 SE(PC 侧工具): cmd() 加 wake 开关 —— SHA 序列只在首条发唤醒（与固件同口径；★ 未验证）
    同一处毛病（§8.29）：每轮都发唤醒令牌会把 SHA 上下文随机打断。改法 = sha_hmac_once 里 UPDATE/END 传 wake=False，START 保持发（首条必须发：实测一条都不发连 100 B 也挂）。其它调用方（Read/Write/Random/Sign/Nonce）默认 wake=True，行为逐字节不变。
    ★ 未在 PC 侧验证：当时 P5 的 I2C 跳线是摘掉的（那正是 CH347F 接到 SE 的两根 => CH347 看不到 SE，设计如此）。判据 = se_provision.py hmac-readonly 单趟过 250 B；做法 = P5 接回 + nano 按住 RST/掉电。注释与 AGENTS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
2026-10-11 SE: PC 侧 wake 修复已验证（单趟全过）—— 去掉'未验证'标记
    P5 接回后实测：hmac-readonly 的 23/100/250 B 三条全部单趟过（日志里一次'整条重来'都没有）；hmac_seq2.py --retries 1（完全不重试）的 219/364/250/100/23 B 全 PASS（364 B = 5 条 UPDATE）。与固件侧同一结论 => 两侧本来就是同一个毛病、同一个修法。
    顺带记一条台面事实（§8.29 末）：P5 断线后 CH347 在 0x50 上的 health 仍是 100%（那是它自己板上的 24C02）=> 'health 100%' 不能推出 'CH347 能看到 SE'；P5 那两根正是 CH347F 接到 SE 的线。
    验收：run_checks.py 5/5。
2026-10-11 SE 收尾: 文档三处过期改对 + check_c4g2_bench 加 --from-keystore
    文档: (1) §9 重整为 9.0 还开着 / 9.1 已结 / 9.2 历史（以前把已结的混在待办里，读起来像还欠一堆）；(2) §6 表第 5 条填上实测（上游那一半两条路径都过：ES256 level=0 trust=high / HS256 level=1 trust=medium，用真密钥库验；模组侧那一半仍缺，本台架没有模组；帧长 395->407 是真片 SN 更长所致，不是格式变了）；(3) §8.27 那句'固件侧只编译通过、尚未上机'改成已上机（指向 §8.28/§8.29）。
    工具: check_c4g2_bench.py 新增 --from-keystore —— 原先验 d 步帧用的是硬编码的 Slot 0 公钥常量（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
2026-10-11 SE 收尾: 台架总闸门整跑 6/6 + 修掉一处'尺子错'（硬编码公钥常量）
    ① py tools\run_checks.py --bench 首次整跑 => 6 道闸门全过（含台架那栏；idlevel sign_fail 下也过 => HS256 腿也验了；报告里可见 level=1/HS256/build_ms=480/accepted=True trust=medium）。唯一 warn 是'模组口无输出'= 本台架没有模组，预期。
    ② 抓到的真问题：check_c4g2_bench.py 验 d 步帧用的是硬编码的 Slot 0 公钥常量（那是某颗上量出来的）=> 换一颗或跑 HS256 必然 FAIL（症状 signature_invalid，看着像芯片坏了）。那是尺子错、不是签名错 —— 与 2026-10-11 check_report_hex.py 用演示钥验真片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
2026-10-11 SE 收尾: 'se1/se2 的 se_sn 台账缺项' 实测为不适用（不用动硬件）
    查清了：那条说的是 --record 写的**文本台账**（一个不在仓里的工作文件），而 se_sn 的权威存放处是 orpah.db —— 实测四颗全有（pubkey_pem / hmac_b64 也全有）。出处：orpah-over-halow/import_keys.py 的 read_ledger() 取台账**最新一条带 pubkey_hex= 的行**的 se_sn => 库里有值就说明入库时那行带着它。而且 se4 的值 2026-10-12 现场读回逐字节相同 => 这条路可信。
    => 不需要把 se1/se2 换上台去补（省掉一次换芯片 + 重接 P5）。文档 §9.0 更新行 + 9.1 已结 + AGENTS §8 同步。
    验收：run_checks.p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
2026-10-11 docs: 状态块清账（c4 + SE 早已上机）+ 修掉一个「编译闸门空转」
    起因：检查文档是否齐全。四个入口文档的状态块还停在 2026-09-21/22 ——
    README / ROADMAP / firmware/README 都写着「c4 未上机 / ATECC608B 未接线」，
    而 2026-10-11 已经全线通了（双锁 + Slot 0 私钥 + slot 4 HMAC 钥都不出芯片、
    level=0/trust=high 与 level=1/trust=medium 两条都被上游接受）⇒ 自相矛盾 ✗。
    docs/atecc608b-se.md：
    - §9.1：修上一轮编辑留下的破损（把两条并成了一行，还留了个孤立的「⇒ ✓（§8.23，第 4 颗）」）
    - §9.0：已结/不适用的三行划掉 ⇒ 真正还开着的只剩第 2 条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
2026-10-11 docs: 三份非 README 文档补图（图早就画好了，只是正文没嵌）
    起因：查文档齐全度时发现 rules（§9 图文并茂）只在 README 上落实了 —— 4 个 README 都有图 ✓，
    但三份讲台架的 docs 一张都没有 ✗。查过 hardware/wiring/ 后确认：**其中 4 张图是现成的**，
    缺的只是"嵌进正文"这一步（第 5 张见下）。
    - docs/c3-2b-bench-bringup.md §1 台架：嵌 cstep-ch347f-txah-evb-nanoch32.svg
    + caption 点出看点（控制台走 P2、HGIC 数据口走模组 A10/A11、模组打印口走 P3）
    + 提醒图上文字标注是"手加在导出 svg 上"的、重导出会丢（规格以 .fzz 网表为准）
    - docs/txah-u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
2026-10-12 模组侧那一半：实测通过（[mbus rx] 415 = 帧 407 + 8 B HGIC 头）+ 工具入库
    台架 = hardware/wiring/cstep-ch347f-txah-evb-nanoch32.*（nano + TX-AH EVB + CH347F，**不带** SE）
    ⇒ 控制台 CH347F P2/UART0 = COM23、模组 AT/打印口 P3/UART1 = COM24。
    判据（连跑 4 次全部一致）：
    1) idsend 后模组口 [mbus rx] **415** byte(s) = 帧 407 + 8 B HGIC 头 ✓
    （模组自己打的，不是我们打印的 ✓）
    2) 同一帧交上游 verify_report ⇒ accepted=True level=0 trust=high ✓
    新增 tools/check_mod_side.py（§9.0 第 2 条的一键判据）：
    - 只判模组侧 + 上游接受，**故意不判 SE**（无 SE 台架上那几条必然 FAIL ✗，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
2026-10-12 固件：ES256 也去掉「序列中间的唤醒令牌」+ 加整条重来（Nonce→Sign）—— ★ 待上机验证
    起因（联合台架实测，2026-10-12）：`Sign(slot 0)` 间歇回 `0x0F`（cannot execute）✗ ——
    `se` 连跑 6 次挂 1 次（≈17%），而**同一跑里** `Random` 5/5 全好 ✓、
    且成功那次的签名用**密钥库里登记的公钥验得过** ✓ ⇒ 不是"芯片坏了"，是**间歇** ✗。
    根因（代码级）：`atecc_sign_digest()` 在**每条命令前**都发一条唤醒令牌 ✗ ——
    包括 `Nonce` 与 `Sign` 之间。这正是 2026-10-11 在 **SHA** 那条路上已经定案的同一条教训
    （§8.29：序列中间的多余唤醒令牌会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
2026-10-12 文档：更正"P5 的 UART 那两根留着"这句错话（P5 只有 I²C，没有 UART）
    2026-10-12 用户指出：P5 是 I²C 排（VIO/SCL/SDA/GND）⇒ **它没有 UART** ✗；
    "留 UART"指的是**另外两排**：P2/UART0 = 控制台、P3/UART1 = 模组 AT/打印口。
    三处都改了：AGENTS.md、docs/atecc608b-se.md（真凶表 ⑤）、hardware/wiring/README.md。
    另：这条还顺带推翻了我当时的一个嫌疑 —— 用户确认 P5 的线**从来没接**过（现在拔掉的也一直是空的）
    ⇒ "CH347F 的 P5 并挂在 I²C 上"这条对本次 Sign 间歇失败**不成立** ✗（详见下一笔提交）。
2026-10-12 联合台架（SE + 模组）全绿 + 记录 ES256 中间唤醒的修复（★ 已上机验证）
    台架 = hardware/wiring/cstep-ch347f-txah-evb-nanoch32-atecc608b（= 模组那张 + 面包板上的 ATECC608B）。
    修后（用户烧录后，同一张台架）：
    - se 连跑 10 轮 ⇒ Sign 0 失败 ✓（另一次完整跑 sign_ok=15 sign_fail=0 ✓）；修前是 1/6 ≈17% ✗
    - [se] i2c: … timeout= 138 → 0 ✓
    - nonce_src / sign_src：soft/soft ✗ → se/se ✓
    - build_ms：~9071（软件 P-256）→ 704 ✓
    - 上游：signature_invalid ✗ → accepted=True level=0 trust=high ✓
    - 模组侧：[mbus rx] 415 byte(s) ✓（= 帧 407 + 8 B HGIC 头）
    ⇒ 「真 SE 签名 → 帧进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
2026-10-12 台架记录：HS256 腿在同一张联合台架上也全绿（L0/L1 两条路都一跑到底）
    `idlevel sign_fail` ⇒ L1（跑完已 `idlevel auto` 复位 ✓）：
    - 帧：level=1 alg=HS256 len=364 build_ms=481
    - 上游（用库里那把**降级 HMAC 钥**验）：accepted=True level=1 trust=medium
    - 模组侧：[mbus rx] 372 byte(s) = 364 + 8 ✓
    - se_hits: ES256 slot 0 ok=26 fail=0 / HS256 slot 4 ok=2 fail=0 ⇒ 两把钥都不出芯片
    ⇒ 这张联合台架上 L0（真 SE 签名）与 L1（真 SE HMAC）两条路都一跑到底全绿。
    文档：docs/atecc608b-se.md §8.32 补一节（含数字表）、AGENTS §8、README 现状块（⑥）。
2026-10-12 固件 Makefile：修好「从零编译」—— MKDIR/RMDIR 改成实测可用的无引号写法
    昨晚只修了一半（头依赖 ✓），干净树构建这条只写了文档没修 ✗。今天用对照实验定下了写法
    （5 种候选 × 2 种环境，每次都单开一个 make + 超时杀进程树，脚本 %TEMP%\mkexp.py）：
    - `cmd /c "if not exist X mkdir X"`（原来的写法）✗ 不建目录：正常环境 make 直接 rc=2、
    目录没建出来；在 PATH 不全的终端里则表现为**起交互式 cmd 卡住**（昨晚就是被它误导的）
    - `cmd /c if not exist X mkdir X`（**去掉引号**）✓ 两种环境都成功建出目录（删目录同 ✓）
    ⇒ 已改成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
2026-10-12 构建约定：固件一律从零（make rebuild）+ 闸门跟着改成从零
    用户 2026-10-12 定：以后 firmware 构建都从零。
    - Makefile 新增 `rebuild` 目标 = `mkdirs.py clean` + `make all` ✓
    （增量 `make` 保留，但它**不作为交付/闸门口径** ✓）
    - tools/run_checks.py 的固件闸门从 `make` 改成 `make rebuild`，label 改成「固件**从零**编译」
    ★ 这条必须一起改 ✗：增量时「零 warning」只保证「make 认为该编的那些」✗ ——
    2026-10-12 之前**改 .h 不重编、而闸门照样 PASS** 就是这么漏过去的 ✗
    - 文档：README 构建节（首选 `make rebuild`）、firmware/README 构建节、AGENTS §1（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
2026-10-12 CI：加 GitHub Actions（Linux + 通用 RISC-V 工具链）做第三方环境交叉验证
    用户 2026-10-12 提：代码在 GitHub 上、有 CI ⇒ 拿它做第三方编译验证，还能换环境（比如 Linux）。
    新增 `.github/workflows/checks.yml`（ubuntu-latest）：
    - setup-python 3.13 + pip cryptography/pyserial（交叉测试里 ES256/公钥那几段要用）
    - 可选 clone 隔壁仓 orpah-over-halow（交叉测试的 Python 参考）⇒ 拿不到就跳过那半、其余照跑
    - apt 装 gcc-riscv64-unknown-elf（**通用**工具链 ⇒ 只作交叉编译验证）
    - 跑 `python tools/run_checks.py`（**不加** --bench ⇒ 台架那栏本来就要板子）
    - 失败也把 checks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
2026-10-12 CI 首次运行实测：修两处工具链口径差异（zicsr / WCH 快速中断）+ 修 flash 提示里写错的烧录地址
    首次 CI（2026-10-12，ubuntu-latest + 通用 riscv64-unknown-elf-gcc）红了，红得有价值 ——
    量出**两代工具链的口径差异**（都不是"CI 环境坏了"，是我们把 MounRiver 的假设写成了通用假设）：
    ① `csrw` 需要 `zicsr`，但两代写法不同 ✗
    通用工具链（GCC 13+）：`-march=rv32imac` 不再隐含 ⇒ `startup_ch32v203.S` 报
    `Error: unrecognized opcode `csrw mstatus,t0', extension `zicsr' required`（5 条全中）
    MounRiver（GCC 8.2.0）：实测**不认** `_zicsr` ✗ —— `cc1.exe: error: -marc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
2026-10-12 CI 第二次运行实测：链接行也必须带 $(ARCH)（通用工具链默认 64 位）
    第二次 CI（2026-10-12，run 103491518931）干净地往前走了一步 ——
    `csrw`/`zicsr` 与 WCH 中断属性那两条**都没了** ✓（ISA / INTFAST 两个旋钮生效 ✓），
    现在死在**链接**上，而且是同一类根因：
    target emulation `elf32-littleriscv' does not match `elf64-littleriscv'
    ld: failed to merge target specific data of file build/startup.o
    ld: build/Core/main.o: file class ELFCLASS32 incompatible with ELFCLASS64
    ld: final link failed: file in wrong format
    collect2: error: ld returned 1 exit status
    真因：`riscv64-unknown-elf-gcc` 是**64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
2026-10-12 docs: CI 第三次运行全绿（bfb08ef）—— 记下三次运行换来三处显式旋钮
    第三次运行（run 38199574735，bfb08ef）6 步全 success、上报 checks_report artifact 3941 B、26 s。三次运行的真价是把三处在一套工具链上碰巧能过变成显式旋钮：zicsr 写法 / WCH 中断属性语义 / 链接 emulation。CI 绿三件事仍不证：不是烧录固件、台架栏跑不了、--from-keystore 跑不了。
2026-10-12 CI：扩成 Linux / Windows / macOS 三系统矩阵（用户 2026-10-12 定）
    Linux 那栏（第三次运行）已经全绿 ✓，现在把同一套闸门铺到另外两个系统上 ——
    三栏跑的是**同一份** `tools/run_checks.py`（口径只有一份 ✓），差别只在"去哪拿 RISC-V 工具链"：
    - Linux = apt 的 `riscv64-unknown-elf-gcc` ✓（快）
    - Windows = **xpack 的 `riscv-none-elf-gcc`** + Git 自带的 `sh.exe` + `choco install make` ✓
    - macOS = **xpack 的 `riscv-none-elf-gcc`** ✓（make 由 Xcode CLT 自带 ✓）
    ★ 为什么 Windows 栏最值钱：本仓那套**路径/编码/sh/make 假设**（`find_sh()` 的三个绝对路径 ✓、
    `mkdirs.py` ✓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
2026-10-12 run_checks: 红的时候要把「为什么红」也打出来（原来只印尾部 8 行，CI 上把编译报错裁掉了）
    起因（2026-10-12，三系统矩阵第一次跑）：Windows / macOS 两栏都只报 FAIL 1 项未过：[编译 ID 流水线] ✗ —— 真正的编译报错被 8 行尾部裁掉，手上有完整日志也说不清为什么红。改法：新增 show_slices()（报错行最多 20 条 + 尾部 25 行），失败时按它打印；报告里失败的闸门也按它写（绿的还是短尾巴）。判据会喊红了，也得会说因为什么。本机复验 5/5 ✓。
2026-10-12 修 CI 抓出来的真缺陷：id_cli.c 少 include ecdsa.h（隐式声明）+ 让闸门比任何单一编译器都严
    第三次运行（三系统矩阵）的真凶（日志原文，2026-10-12）：
    FAIL 编译 ID 流水线（§8.2 选级 / 演示密钥 / nonce / 整帧） 失败（gcc）：
    proto/id_cli.c:125:13: error: implicit declaration of function 'ecdsa_sign_p256_msg'
    125 | if (ecdsa_sign_p256_msg(out, b->ec, pre, prelen) != 0) { return -1; }
    ★ 这是**我们的真缺陷**，不是环境问题 ✓：
    · GCC 13 / MounRiver 8.2 / MSVC 上只算**警告** ⇒ 本机与 Linux 一路"编得过" ✗；
    · **GCC 14+ / Clang 15+ 默认就是错误** ✗ ⇒ Win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
2026-10-12 docs: 记下三系统矩阵全绿（978f1ee）+ 这轮 CI 的结论
    run 38206170473（978f1ee，2026-10-12）：macOS 35 s / Windows 1 m 13 s / Linux 36 s ——
    **三栏全 success** ✓，三份 `checks_report-<os>` 产物齐 ✓（3941 / 3952 / 3906 B）。
    它先抓到的真缺陷（已在前一个提交修掉 ✓）：`proto/id_cli.c` 少 include `ecdsa.h` ✗ ⇒
    `ecdsa_sign_p256_msg()` 成了隐式声明 —— GCC 13 / MounRiver 8.2 / MSVC 只是警告（本机 + Linux
    一路编得过 ✗），GCC 14+ / Clang 15+ 默认就是错误 ✗ ⇒ 两个新工具链的栏位当场红 ✓。
    结论一句话：**"在手上这台编得过"不算证据** ✗ —— 这就是第三方环境交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
2026-10-12 checks_report: 收录本机 --bench 那一遍（6/6，含台架：nonce_src=se sign_src=se、模组侧 [mbus rx] 415）
2026-10-12 CI 说明去掉自评：AGENTS 里那句自评改成中性的「这一栏量的是什么」（理由原样保留）
2026-10-12 docs(d 步): 载板规格书草稿（电池 + 预留取能 / 模组用现有 TX-AH 板当子板）
    用户 2026-10-12 拍板三条前提：① 只做 d 步（载板 + 现有 TX-AH 板）；② 电源先电池、
    预留取能接口；③ 模组用现有 TX-AH 板当子板。
    规格书要点（每条都标出处，没出处的一律写「待核」）：
    - 器件表 / 引脚分配全部来自 firmware/Core/board.h（2026-09-21 上机实测确定）；
    - 电源树：电池 + 预留取能/储能焊盘（取能参数等 SPEC F-11 实测，本版只预留）；
    - 测试点 / 烧录（SWD + NRST）/ 产线（I2C 引出 ⇒ 现有 se_provision.py 夹具可用）；
    - 验收判据 8 条：台架上验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
2026-10-12 docs(d 步): 载板规格 v0.2 —— 取能芯片角色、超容+400909、demo 优先（不锁尺寸）
    用户 2026-10-12 给的信息落进规格：
    - 手头 8 颗取能/电源芯片 → §4b 按「在链路里干什么」分组（取能前端 / 压电交流 / 射频 /
    双源 / 后级升压）+ 三条候选链路（含 mermaid 电源树）；★ 全表标「初判 ✗ 待核 datasheet」，
    不装作已核过 —— 有 datasheet 就换成有出处的。
    - 储能 = 超级电容 + 锂电 400909（容量/内阻待核 ✗）；新增 §4c「demo 优先」：尺寸不锁死 ✓、
    取能前端做成跳线/子板 ✓、电流测量跳线（实测 SPEC F-11 能耗 ✓）、关键信号 0.1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
2026-10-12 docs(d 步): 载板规格 v0.3 —— 模组改裸模块（15×17 邮票型/无天线⇒自制天线）、8 颗电源芯片换成有出处、超容 0.5F+400909、核电池作候选 D
    用户 2026-10-12 第二批输入落进规格：
    - §4b 换成**有厂商出处**的选型表（SPV1050/SPV1040/BQ25504/TPS61200/LTC3330/LTC3588-1/
    AEM30940 逐颗附关键参数；PCC110 未查到官方资料 ⇒ 如实标「待您给手册」）。第一版建议 =
    SPV1050 单颗起步（MPPT + 1.8/3.3V LDO + 550mV 冷启动 + 70mA）+ TPS61200 留位；
    另明确标出 LTC3330 的取能输入是 3-19V ⇒ 不适合低压光电（留给压电/高压源）。
    - §2/§7b：模组 = 裸模块 TX-AH-R900PNR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
2026-10-12 载板规格：U1 改按 CH32V203F8U6（QFN20）口径
    - §2 器件表：U1 = CH32V203F8U6（QFN20 / 3x3mm / 0.4mm 脚距）；出处分两半写清 ——
    时钟/串口 = board.h 台架实测 ✓；封装/脚名 = 《CH32V203 数据手册》表 3-1-1 / 表 5-1
    ＋ 本库新元件 fritzing-parts-langhua/svg/CH32V203F8U6/ ✓。
    - §3 引脚分配：SE 的 I2C 由 I2C1@PB6/PB7 改为 I2C2@PB10/PB11（这个封装没引出 I2C1）；
    加一行裸露焊盘 pin 0（原厂名 VSS、独立成网、画板时要特意接 GND）；
    并把「已上机实测」拆成两半：USART1/USART2/SWD/心跳灯 = 已实测；I2C2 那一行 = 计划值、未上机。
    - 没有 NRST/BOOT0（BOOT0 在 F8U6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
2026-10-12 docs: 取能定室内光 + SPV1050 要点 + F-11 实测计划（PCC110 补出处）
    用户 2026-10-13 三条决定落账：
    - 取能源 = 室内光/光伏；前端首选 SPV1050
    - 第一版先走子板（裸模块焊盘留在板上、但不装）⇒ 不必等泰芯天线资料就能开画
    - PCC110 官方资料已拿到 ⇒ §4b 的 8 颗芯片全部有厂商出处
    新增文档：
    - docs/carrier-power-spv1050.md —— 画原理图前必须定下来的四处（配置档 / MPPT 设定 /
    VEOC-VUVP 电阻 / LDO 使能脚），带 ST 官方出处；其中公式与电阻值标「待核 datasheet」
    （ST 数据手册 PDF 我这边取不到正文 ⇒ 需要 PDF 才能补）
    - docs/carrier-f11-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
2026-10-12 feat(fw): SE 的 I²C 做成编译期开关（缺省台架 I2C1 / 载板 I2C2）+ 闸门两档都编
    背景：F8U6（载板 MCU）封装上 I2C1 没引出引脚 ⇒ 载板只能用 I2C2 @PB10/PB11，
    而台架跑的是 I2C1 @PB6/PB7（已上机）。
    - Core/board.h：新增 SE_I2C_USE_2（#ifndef 护栏，可命令行覆盖），引脚/外设/时钟位全跟着走
    - Periph/i2c.c：寄存器访问统一走别名 SE_I2C —— 漏改一处 = 某个寄存器写到另一个外设上，
    而漏了照样编得过 ⇒ 注释里写明自检：grep -c 找 I2C1 箭头，必须 0 处
    - Periph/i2c.h：口径写清两档（台架已上机 / 载板未上机）
    - Makefile：SE_I2C ?= 0 旋钮（照 ISA/I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
2026-10-12 docs(取能): SPV1050 手册到手 ⇒ 把「待核」换成官方公式（Eq 1～7 + 算例 + 图 2 接法）
    用户 2026-10-13 给了《DS10044 – Rev 7》（30 页，文件名中文、正文英文）⇒
    carrier-power-spv1050.md 里原来标「待核 datasheet」的那几处全部换成带页码/小节的结论：
    - §2.2 保护分压 = 手册 Eq 1～3（p11，内部基准 V_BG = 1.23 V）：
    R_OUT(TOT) 取 10～20 MΩ、R6 = (V_BG/V_EOC)×R_OUT(TOT)、R5 = (V_BG/V_UVP)×R_OUT(TOT) − R6；
    接法照 Figure 2 核对过：STORE —R4— ⟦UVP 脚⟧ —R5— ⟦EOC 脚⟧ —R6— GND（R4 顶、R6 底）；
    并按我们的选型给了算例（V_EOC 4.2 V / V_UVP 3.0 V / R_OUT(TOT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
2026-10-12 docs(取能): 储能改定 —— 锂电不装、超容 5.5 V 挂 BATT（用户 2026-10-13）
    用户两个决定：① 储能选型「一定要记录下来」⇒ 新增 carrier-power-spv1050.md §2.6；
    ② 锂电 400909 不装（太占地方）。
    §2.6 的内容（全部带出处）：
    - 电压档：单体 2.1–2.3 V（水系）/ 2.5–2.7 V（有机，主流）/ LIC 3.8–4 V；5.5 V 不是另一种体系，
    它就是两串 2.7 V 单体（来源：Wikipedia Supercapacitor）
    - 为什么选 5.5 V：SPV1050 的 V_BATT 下限 2.2 V、V_EOC 上限 5.3 V（手册 p7/p8）
    ⇒ 可用能量 ½C(Vmax²−Vmin²)；0.5 F 时 2.2–5.3 V = 5812 mJ，而 2.7 V 单体只有 612 mJ（9.5 倍）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
2026-10-12 docs(取能): SPV1050 vs BQ25570 同口径对照（用户 2026-10-13 问）—— 窗口几乎相同，BQ25570 赢在 buck
    用户给了 BQ25570 手册（D:\Downloads\bq25570.pdf，TI 中文 Rev G，46 页）⇒ 按同一套判据摆数据，
    规格新增 §4b-1 对照表（每一行都标出处）。
    从手册取到的关键数（都带条件）：
    - 冷启 VIN(CS) = 600 mV 典型 / 700 mV 最大（Rev F 从 330/450 提上来的）；冷启把 VSTOR 充到 1.8 V
    - VIN(DC) 100 mV ~ 5.1 V；最大输入功率 510 mW；Iq = 488 nA 典型；ship mode 电池电流 <5 nA
    - MPPT：VOC_SAMP 接 VSTOR = 80%、接 GND = 50%、或电阻分压自定义
    - VBAT_OV 外部电阻可编程（须 > VIN_DC；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
2026-10-12 docs(carrier): BQ25570 两条待核收窄（buck 93% / RDS(ON)-BAT 0.95 Ω）并据此改口
    - docs/carrier-board-spec.md §4b-1：稳压轨行补 buck 标称 93%（Rev 把 98% 改正；
    曲线与电特性按 VOUT=1.8V，3.3V 档待上机）；新增「储能支路阻抗」行：
    SPV1050 R_BATT≈6Ω vs BQ25570 RDS(ON)-BAT=0.95Ω（同为 200mA 峰值：1.2V vs 0.19V）；
    峰值输出 93~110mA；外围值补全（CIN 4.7µF / L1 22µH / CSTOR 4.7µF / L2 10µH / COUT 22µF）。
    - 结论改口（数据变了结论就变）：BQ25570 三条硬指标都更好（buck 93% vs LDO 62%、
    储能支路 0.95Ω vs 6Ω、窗口下限 1.95V vs 2.2V）⇒ 建议第一版直接用 BQ25570
    （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
2026-10-12 docs(carrier): 补一条 —— 3.3V 负载下「可用能量窗口」由输出轨压差决定（不是 UV 阈值）
    - 顺着 BQ25570 的 RDS(ON)_BUCK 高边 1.60/2.00Ω 发现：压差 = 最大输出电流 × buck 高边
    电阻（手册原文），100mA 时 0.16~0.20V、200mA 时 0.32~0.40V ⇒ VSTOR 要 ≥≈3.5~3.7V 才供得出
    稳定的 3.3V；SPV1050 侧同理（LDO 压差手册值未取到，先按同量级 0.2V 处理）。
    - ⇒ 对我们真正的可用窗口 ≈3.5→5.3V（两颗同）⇒ 0.5F 的可用能量 ≈3.6~4.0J，不是 5.81J。
    容量选型必须用 3.5~3.7V 这个下限。
    - ⇒ 「窗口 1.95V vs 2.2V」这条差异对 3.3V 负载不成立 ⇒ 改口的理由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
2026-10-12 docs(carrier): 前端改用 BQ25570 的落地方案 + 回答「100 mA 够 HaLow 用吗」
    - 用户拍板：第一版前端 = BQ25570（手头现成模块 CJMCU-2557；板上电感 220/100 = 手册的
    L1 22µH / L2 10µH）。
    - 新增 §4b-2：四条设置公式（公式在 PDF 里是图片，渲染出图逐字核对，并用手册算例自检）：
    VOUT = VBIAS(1+ROUT2/ROUT1) / VBAT_OV = 1.5*VBIAS(1+ROV2/ROV1)（注意 3/2 因子）/
    VBAT_OK_PROG = VBIAS(1+ROK2/ROK1) / VBAT_OK_HYST = VBIAS(1+(ROK2+ROK3)/ROK1)；
    我们的值：ROUT 4.75/8.25（3.31V）、ROV 4.75/8.25（4.97V）、ROK 4.12/7.87/1.02（3.52/3.82V）；
    MPPT 直接 VOC_SAMP 接 VSTOR = 80%。
    - 「100 mA 够不够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
2026-10-12 docs(f11): 补「模组侧三条量法」（BQ25570 落地方案那三条待实测数）
    - 起因：§4b-2 的结论 = buck 只有 93~110 mA 连续能力 => 峰值靠电容顶、平均靠占空比压
    => 三条必须分开量（一个整板平均电流什么都定不了）。
    - 新增 §2b：②-1 发射 I_pk / t_burst（方法 B，分流串模组支路而非整板，按 AT+TXPOWER 6/14/20 dBm
    扫档，同时读 3V3 压降得实测 dV）=> C = (I_pk-100mA)*t/dV 定电容；②-2 常驻电流（方法 A 的镜像，
    按 AT+PS_MODE 1/2/3/4 各量一遍；注意模式 4 只能被 AP 的 AT+WAKEUP 唤醒 => 「设备自己定时醒来
    上报」能不能走是功能问题，要单独确认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
2026-10-12 docs(carrier): F-11 操作单 + 载板连接表（原理图内容）+ SPV1050 口径统一到 BQ25570
    - docs/carrier-connections.md（新）：网络清单（3V3/GND/VBAT/VBUS_IN/SDA/SCL/MOD_*/CON_*/
    SWD*/LED_HB/VBAT_OK/VOUT_EN）+ 逐器件接法（U1 按功能名、脚号以 Fritzing 部件为准；U2 SOIC-8；
    R1/R2 4.7k 上拉；R3+D1 心跳灯 PA15 低有效；BT1 5.5V 超容；前端第一版插 CJMCU-2557 模块 ⇒ 排针
    + 网标签，丝印名照抄）+ 5 条硬规矩（地连成一片 / I2C 上拉不能省且别两个主机并一条总线 /
    模组轨就近去耦+大电容 / VOUT_EN 硬接高别交给 MCU / 裸露焊盘 VSS 特意接地）+ 待核清单。
    - docs/carrier-f1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
2026-10-12 docs(carrier): 连接表补「在 Fritzing 里画（照着点）」一节
    - 说明为什么这一步在 Fritzing 里手画、不由脚本生成 .fzz：Fritzing 要求元件/走线三视图写全
    （本库实测 4149 条里 4148 条是三视图），且结构不合口味就静默忽略（只有 pcbView 的 129 条
    整组不被认）=> 生成风险高；而 Fritzing 点两个脚就自动布线 => 手画更快。分工 = 我定死内容
    并逐网核对，画在 Fritzing 里。
    - 步骤 7 条：新建 sketch 切原理图视图；拖 CH32V203F8U6 / ATECC608B / TX-AH-R900PNR（check_deploy
    rc=0，都在元件箱里）；再拖 4.7k x2 / R3 / LED / BT1 / 排针 x3 / 前端排针 / 网标签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
2026-10-12 feat(carrier): 载板项目数据 carrier_nets.py + 两条真问题修正（F8U6 无 PA15、U1 只有一只 VDD）
    - hardware/carrier/carrier_nets.py（新）：载板的项目数据（NETS 15 张网 / POWER / COLOR 只取
    Fritzing 官方 13 色 => 两张网共用），脚名是从 part.*.fzp 读出来的真名；让库仓那套通用工具
    （check_netlist / render_sch / sch_metrics / sch_straighten）直接能用在载板上。EXPECT 待草图
    存在后照 pixel_nets.py 的写法补。
    - 两条由真脚名抓出来的真问题：① CH32V203F8U6 的 21 只脚里没有 PA15 => 载板心跳灯必须换脚
    （建议 PB0）+ 固件要加板档开关（board.h 现在写死 PA15，台架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
2026-10-12 docs(carrier): 查清画图流水线（4 步有现成的，只剩「造源草图」一步）
    - 用户 2026-10-13 把 F:\git\AuroraTessellation-NFC 加进工作区 => 看见整条流水线：
    ① 出脚位几何 = 库仓 render_sch.py --pins-out（PINS[mi][cid] 相对锚点 / BOX[mi] / LAB，
    对 Fritzing 自己导出验平 Δ≤0.0004 单位）=> 脚位映射不用自己解（上一轮正要自己解）；
    ② 自动摆位 = 项目侧 gen_schematic_layout3.py --pins（数据驱动、只碰 schematicView）；
    ③ 自动布线 = 项目侧 gen_schematic_wires.py（9378 行，一堆开关；唯一项目专属 = 文件顶部 NETS）；
    ④ 复核 = 库仓 render_sch / sch_metrics /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
2026-10-12 feat(carrier): 造出载板源草图 carrier-board.fzz（17 件 / 零导线）—— 管线那个缺口补上了
    - hardware/carrier/carrier_board.py（新）：造「含元件、零导线」的原理图源草图。骨架从台架草图
    抄（只留 <boards> 与板框件 PCB1，别的实例与悬空 <connects> 全删），外层结构就是 Fritzing
    自己写的形状；两趟摆位（粗摆 -> render_sch --pins-out 拿本体框 -> 按 GAP=2 格精摆）。
    - 件一律用库件：实测核心件（:/resources/parts/core/…）我们的工具链解析不了（17 件只认 15 件，
    丢的正是两只核心件）=> 全改库件，moduleId/fzp 名从部件目录读（不写死）。
    - 产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
2026-10-12 fix(carrier): 核心件改用绝对路径（读得到了）+ D1/BT1 换真件 + 查清 Fritzing 泛用排针读不到
    - 纠正上一轮的结论：核心件**能**读，但 path 必须写绝对路径
    （…/Fritzing/fritzing-parts/core/<文件>.fzp）；写成 Fritzing 内部记号 :/resources/parts/core/…
    就读不到（part_measure 明写：core 件不在 .fzz 里，按实例给的绝对路径读它的 .fzp）。
    - 实测：换绝对路径后 17/17 全部认到（此前 17 件只认 15 件）。
    - D1 换成核心件的 SMD 0603 LED、BT1 换成核心件的 goldcap（真超容件），不再是 SOD-123/0603 占位。
    - 查清 Fritzing 那只「Pin Header」（可选针脚数）是**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
2026-10-13 feat(carrier): 载板源草图换用真排针（J1/J2/J3/J4），J4 脚号口径回正
    起因：上一轮把 J1–J4 做成 NetLabel-Pad 占位（当时本库没有排针件），现在
    `fritzing-parts-langhua` 已有 `PinHeader-1x2…1x10` ⇒ 换成真件。
    - `carrier_board.py`：10 个 `NetLabel-Pad` 占位 → 四只真排针
    （`J1` 1x4 模组 / `J2` 1x6 台架产线 / `J3` 1x4 SWD / `J4` 1x7 CJMCU-2557）。
    ★ 实例 `<title>` 必须是**纯位号** —— `sch_route.py` 拿它当 ref 去 `insts[ref]` 查实例，
    写成 `BT1 5.5V 超容` 会 `KeyError: 'BT1'`（实测踩到 ⇒ 说明文字一律只留注释）。
    - `carrier_nets.py`：`J4` 的**具名脚** → 排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
2026-10-13 feat(carrier): 载板原理图出图（布线 + 复核全过），J1–J4 换真排针
    - `carrier_board.py`
    · `J1–J4`：10 个 `NetLabel-Pad` 占位 → **真排针**（`PinHeader-1x4/1x6/1x4/1x7` ✓ 本库新件）
    · `D1`：`SMD_LED_generic_0603.fzp` → **`sparkfun-led-led-0603.fzp`** ✓
    （前者是**泛用壳** ✗：icon/breadboard 都指向 5mm 直插 ✗、schematic 的脚包在 `<g>` 里
    ⇒ 工具**一只脚都认不出** ✗ ⇒ 布线当场卡住 ✗；选件判据按用户定：**看 pcb 确定** ✓。
    脚序也正：`connector0 name=A`（阳极）/ `connector1 name=C`（阴极）✓ 与网表一致 ✓）
    · 实例加 **`<titleGeometry>`** ✓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
2026-10-13 carrier: 配色避开黄色（用户 2026-10-13 定）
    原话：「限制使用黄色 —— 在有其它颜色可选时，不使用黄色，因为在 Fritzing 界面上，黄色不明显」。
    改法（官方表共 13 色；去掉 yellow 只剩 12 色，而本板 15 张网 ⇒ 必须有 3 对共用 ✓；
    共用的三对都挑语义成对的 ✓）：
    - SCL： #fff800（yellow ✗）→ #8c3b00（dark brown）
    - SWCLK： #8c3b00 → #999999（与 SWDIO 共用 —— 同一条 SWD 调试对 ✓）
    - LED_HB： #fff800（yellow ✗）→ #ef6100（与 LED_R 共用 —— 同一条 LED 支路 ✓）
    - VBAT： #ef6100 → #a37911（与 VBUS_IN 共用 —— 都是“能量”✓）
    ★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
2026-10-13 carrier: 交付件只换名跟上新元件库（几何一字未动）
    元件库 23 件按 Fritzing 件类型后缀改名后（库仓 §5），`carrier-schematic.fzz` 里
    仍是旧名 ⇒ 属性面板只读 ✗。本次**只换名**：`R0603_36137a0f…_1` →
    `R0603_36137a0f…_1-ResistorModuleID`，几何 = **已交付那份**（HEAD ✓）。
    验证 ✓：
    · 把新名换回旧名后 `.fz` 与 HEAD **逐字节相同** ✓、包内条目相同 ✓；
    · `check_netlist` rc=0「14 个网全对」✓；`render_sch` rc=0 ✓。
    ✗ 未提交 `carrier-board.fzz` / `carrier_board.py`：那是**还没跑通**的分段摆位实验
    （实测补 `--rails` 后仍 4 张网不通 ✗、擦身 20+ 处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
2026-10-13 carrier: 元件标签改为实例显式写死行，并按规范印型号/参数
    - 每件的 <titleGeometry> 内显式写 <displayKey>：芯片/接口/二极管 = 位号 + 型号、
    电阻 = 位号 + 公差 + 功率 + 阻值、电容 = 位号 + 电压 + 容值。
    - 删掉先前写死的 <property name="part number" value="<moduleId>">；改为只对
    SHOW_MODEL 里的件写出真实型号；D1 用的 core 件没有 part number，覆写为 LED-0603。
    - BT1 由 core goldcap 换成库件 Supercap-1.5F（core 件的 capacitance 未设 showInLabel，
    容值不会显示）。
    用户已在 Fritzing 中验收：标签均正确，且不再压任何元件。
2026-10-14 措辞：「坑」→ 问题/bug（12 处）＋ 载板文档跟上布线器的新缺省
    用户 2026-10-14：不要再用「坑」这种口语化的一字词，用 **bug** 或 **问题**（文档与注释同样适用）。
    `docs/carrier-connections.md`：布线器的「布完线再摆一遍位号」现在**缺省就是开的**，
    不再需要显式传 `--relabel`。
2026-10-14 carrier: 交付件定为 c1 —— `GAP` 11 格 ＋ 布线器走廊首档 `--choffs 7.3,12,22,34`
    起因（用户 2026-10-14）：「**`Wire90000106` 为什么没有直接在 (2.015,0.193)in 跟
    `Wire90000104` 连接？**」⇒ 量出贴脚的真因**不在摆位**，而在**走廊首档**：
    `CH_OFFS[0] = CLEAR = 6.0` ＜ `CLEAR_PIN = 7.2`，而包围盒**含引脚引线** ⇒
    用首档走廊跑的主干离旁边的引脚端点**正好 6.00** ⇒ **必然贴脚**
    （同一画布：缺省 `--choffs` 贴脚 8 ⇒ `7.3,12,22,34` 贴脚 1）。
    ★ 没有去改库里的缺省值（那会连带影响别的板子）。
    本版（c1）实测：贴脚 **1** ｜ 交叉 **54** ｜ 拒画 **0** ｜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
2026-10-14 载板配色改正：`LED_R`/`LED_HB` 用原理图的橙 `#ff7300`；`VBAT_OK` 不再用白
    起因（用户 2026-10-15 手改时实测）：「`Wire90000120`（蓝色）在 Fritzing 里看不到」✗
    —— 两处都出在 `carrier_nets.py` 的 `COLOR` 表上：
    ① `VBAT_OK` 给的是 `#ffffff`（白）✗ ⇒ 原理图底色就是白的 ⇒ **画上去等于没有** ✗；
    ② `LED_R`/`LED_HB` 给的是 `#ef6100` ✗ ⇒ 那是**面包板**视图的橙；**原理图**视图的橙是
    `#ff7300` ✓，`#ef6100` 在原理图里是 `<obsolete>` ⇒ 指示栏认不出 ⇒ 退回“蓝” ✗。
    ⇒ 本板 15 张网 / 原理图 13 色 − 黄（用户禁）− 白（白底看不见）= **11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
2026-10-14 载板：D1 换成库件 LED-0603（原理图端子画在引脚尖上）
    ★ 起因（用户 2026-10-15 截图 ✓）：从 `D1` 的 2 脚接出去的导线，线端落在**阴极杠**上 ✗ ——
    Fritzing core 那只 SparkFun 件的 schematic 把两个端子画在**引脚线中点** ✗
    （Fritzing 取端子元素**包围盒中心**为连接点 ⇒ 就在中点 ✗）。
    ★ 换件：`D1` ⇒ **本库自己的 `LED-0603`** ✓（2026-10-15 在库仓新建并入库 ✓）——
    它的 schematic 是自绘的、两端子显式落在引脚线**外端** ✓；脚序不变
    （`connector0=A` 阳极 ✓ / `connector1=C` 阴极 ✓）⇒ 与 `carrier_nets.py` 对得上 ✓。
    ★ 重跑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
2026-10-14 载板交付件：换 LED-0603 后重出（(A)=0、网表 14/14、位号四项全 0）
    ★ 交付 = `hardware/carrier/carrier-schematic.fzz`（**110 根导线**、11 件、14 张网 ✓）＋ png/svg ✓
    源草图 `carrier-board.fzz` 同步重出 ✓（含 `LED_0603_…-LEDModuleID` ✓，不再含 core 的 SparkFun 件 ✓）。
    ★ 判据（都跑在**这一版**文件上 ✓，日志 `_work/route_swap.log` / `swap_render.log` /
    `swap_netlist.log` ✓ —— 我自己写的临时驱动**忘了给子进程带 `PYTHONIOENCODING=utf-8`** ✗，
    `render_sch` 打 `▶` 时在 GBK 管道里崩 ✗ ⇒ 现在统一带上 ✓）：
    * **`(A)`（表里声明接了某脚、而线没画到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
2026-10-16 AGENTS §1：加一行指针 —— 开发次序「网表 → 面包板 → 原理图 → PCB」（用户 2026-10-16 定）
    · 正文写在库仓 fritzing-parts-langhua/AGENTS.md §2b ✓
    （照本仓「跨项目规则只在库仓写正文、项目仓只写一行指针」的惯例 ✓）
    · 本仓现状如实记：网表 = hardware/carrier/carrier_nets.py ✓、
    面包板 = hardware/wiring/cstep-*.fzz（**面包板视图** ✓，9 张都画着 ✓）＋ 实物台架（已上机 ✓）、
    原理图 = hardware/carrier/carrier-schematic.fzz（已交付 ✓）、**PCB = 未做** ✗
    · 纯文档改动：未碰 firmware/ proto/ tools/。
    ★★ 本提交经用户当日纠正后 amend ✗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
2026-10-16 hardware/carrier: 面包板视图摆位（含 U1 的 EPAD 接地）＋ 布线/图例流水线
    - `hardware/carrier/carrier_bb.py`（新）：把 11 件摆到**面包板视图**上
    （规则正文 = 库仓 `docs/breadboard-routing-rules.md` §A.4 摆位先于入网 / §A.5 物理在前
    ＋ E1/E3 ✓）—— 逐脚落到**真实的孔**、写双向声明（板侧 `layer="breadboard"`、
    零件侧 `layer="breadboardbreadboard"` ✓）；`BT1`（脚距 **6.00 mm** ✗ 插不进孔 ✗）
    在面包板视图里**不画** ✓（先例：像素板的 `TP1` ✓）。
    · **两个"模板件"**（源草图是**零导线**的，而下游两件工具都要现成的样件 ✓）：
    ① **模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
2026-10-16 docs: 重跑 run_checks（6 道闸门全过；台架那栏要接板子 ⇒ skip）
    - 起因：`hardware/carrier/carrier_bb.py` ＋ `carrier-board.fzz` 落地之后，按本仓
    §4「改完先跑 `tools/run_checks.py`」重跑一遍 ✓。
    - 结果：**6 道闸门全过、0 道未过** ✓ —— 协议内核交叉测试（C ↔ Python）✓、
    接线图网表 vs 规格表（9 张）✓、标注扫描 ✓、Python 语法 ✓、
    固件载板档编译（`SE_I2C=1` → I2C2 @PB10/PB11，零 warning ✓）、固件从零编译
    （`riscv-none-embed-gcc`，零 warning ✓）。
    - **台架那栏是 `skip`** ✗ —— 它要接板子（`--bench` ✓），本机没接 ⇒ 如实跳过 ✓，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
2026-10-16 载板网表数据：颜色表按视图分开（COLOR = 面包板 ✓、COLOR_SCH = 原理图覆盖 ✓）
    病（实测 ✓）：COLOR 里 LED_R / LED_HB 写的是 #ff7300 ✗ —— 那是**原理图**那一节的橙 ✓
    （官方表两节：面包板橙 #ef6100 ✓）。10-15 为了让原理图那根橙线看得见 ✗ 把它改成原理图值 ✗
    ⇒ 原理图对了 ✓、面包板全错 ✗（画出来对 ✓，但 Fritzing 颜色下拉认不出 ⇒ 回退“蓝”✗；
    file_sanity ① 实测：bb_routed 3 根 / bb_legend 5 根 / 手改版 2 根 ✗）。
    ⇒ 一张表管两个视图 = 必然错一边 ✗ ⇒ 表必须带“视图”这一维 ✓。
    改法 ✓：COLOR 回到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
2026-10-16 一键回归补「线色闸门」（面包板 + 原理图两个视图）+ 管线命令单登记
    用户 2026-10-16 定：「原理图线色闸门必须补」✓。
    · tools/run_checks.py 新增 **②b 线色闸门** ✓：对**入库的每张 .fzz**（`_work/` 草稿不查 ✗）
    跑库仓 `tools/file_sanity.py` ✓（①面包板 / ①b原理图 ⇒ **rc=1 才算红** ✓）。
    ★ **跨仓** ⇒ 找不到库仓 tools 就**明确跳过** ✗（别当通过 ✓，同 sh/固件那两栏的处理 ✓）；
    设 `FZ_TOOLS=<库仓>\tools` 可指定 ✓。
    · 实测（本机）：**查了 11 张入库草图 ✓、全 rc=0** ✓ ⇒ 一键回归 **17 道闸门 / 0 道未过** ✓。
    （口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
2026-10-16 原理图管线整跑复现（逐根相同 ✓）+ carrier_board.py 加一条告警
    用户 2026-10-16 问「原理图布线吧？」⇒ 按 carrier_board.py 文件头那份命令单（＝ 2026-10-14 交付时钉死的
    4 步）**整跑一遍** ✓，输出到 _work/（**不动交付件** ✓）；用 rebuilt_carrier-board.fzz
    （＝ 源脚本刚生成的那份 ✓，不含面包板管的 3 个模板件 ✓）当输入。
    结果：**与已交付的 carrier-schematic.fzz 逐根相同** ✓✓
    · 逐根比（几何 + 颜色 + 接哪儿 ✓，按多重集合、不比 title ✗ — 两份源草图的实例编号会错位 ✓）：
    两边各 110 根、**0 种差异** ✓；
    · check_netlis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
2026-10-16 checks_report: 重跑闸门（17 道 / 0 未过；②b 线色门跑 11 张草图）
2026-10-16 载板：修 BT1 极性接反（超容正极原来接在 GND 上 ✗）＋ 1.5 F 口径
    病（用户 2026-10-17 一眼看出：「BT1 的正极为什么接地？」✓）：
    - 部件 Supercap-1.5F 自己写着 connector0 = `-`、connector1 = `+`（符号里 + 记号也在上面那只脚 ✓）
    - 而 carrier_nets.py 当初用**序号**引用：GND: [("BT1","#2")] / VBAT: [("BT1","#1")] ✗
    ⇒ `#1` = 序号第 1 个 = connector0 = **负** ✗ ⇒ 负接 VBAT、**正接 GND** ✗✗
    （文档 carrier-connections.md 本来写对了 ✓ —— **文档对、数据错** ✗）
    修（两处，一次一个改动 ✓）：
    1. carrier_nets.py：改用**部件自己的名字** ("BT1","+") / ("BT1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
2026-10-16 载板原理图定稿：手改版为正式版 + Fritzing 人工验收「布线完成」✓
    采纳（用户 2026-10-17 定 ✓）：
    - carrier-schematic.fzz ⇐ _work/carrier-schematic_regen_byHand.fzz
    （41 个 zip 条目逐字节照搬 ✓、内部 .fz 归一成 carrier-schematic.fz ✓、.fz 内容一字未动 ✓；
    老正式版备份在 _work/previous_carrier-schematic.fzz ✓，git 里另有历史 ✓）
    - 采纳前先核过草稿确实是修过极性的那一份 ✓（脚本内置自检：connector0 → GND 那根、
    connector1 → VBAT 那根、带 transform ✓）—— 不是就不写文件 ✗
    ★ 人工验收（只有用户能做的那一条 ✓）：在 Fritzing 里打开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
2026-10-16 载板面包板：采纳用户手改版为正式交付件 + 补图例
    采纳（用户 2026-10-17 定「采纳」✓）：
    - hardware/carrier/carrier-breadboard.fzz ⇐ _work/bb_byHand_fix5.fzz
    （41 个 zip 条目逐字节照搬 ✓、内部 .fz 归一成 carrier-breadboard.fz ✓、.fz 内容一字未动 ✓；
    源草稿 _work/bb_byHand_fix5.fzz **一字未动** ✓）
    - 用 adopt_bb.py 走的纪律同上次：全读进内存 → 写临时文件 → os.replace 原子替换 → 回读自检 ✓
    （不用 ZipFile(p,"w") 覆盖正在读的文件 ✗ —— 那个坑今天踩过 ✓）
    补图例（用户定「加」✓）：
    - bb_legend3 出 15 行图例（颜色取自项目数据的 COL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
2026-10-17 carrier/breadboard: BT1 off-board below the board, 180deg, + pin28A / - pin30X; README+AGENTS notes
2026-10-17 carrier_nets：把「CJMCU-2557 待做」更新为已完成（库仓 svg/BQ25570）
    2026-10-17 用户定的分工没变：载板自己是独立模块、J4 保持 1×7 排针、原理图一个字不动；
    CJMCU-2557 另做一只独立件。这只件已在库仓 `fritzing-parts-langhua` 做完（提交
    `fade591`/`fd6ba3c`/`3ab737a`，`.fzpz` 已入库、已部署到 MINE、已登记 README/预览/元件箱）：
    - 面包板 30×28.5mm（用户实测），10 只针：
    左缘 `GND` / `V_EN` / `EN` / `V_OK`；
    右缘三对端子 `TB1-INPUT±`（上）/ `J1-BAT±`（中）/ `TB2-OUTPUT±`（下）—— 按实物丝印
    （照片底图正面 + 背面拼在一张；背面的 `CJMCU-2557` 印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
2026-10-17 .gitignore: 忽略手工版草稿（*_byHand.* / *_图示.*）
2026-10-18 载板 PCB：布局定稿 + 全板布线（16/16 网）+ 电源开关 SW1
    一、网表（carrier_nets.py）
    - 新增电源开关 SW1（SK-12D02VG3）⇒ **3V3 拆成两张网**：
    · `3V3_IN`（开关**之前**）= J4.4(取能模块 OUTPUT) + J4.6/J4.7(V_EN/EN 硬接高) + SW1.2(公共端)
    —— 开关断开时取能模块仍在工作，合上就上电
    · `3V3`（开关**之后**）= U1/U2/R1..R3/J1..J3 + SW1.1
    `EXPECT` 同步改（那是手工维护的表，漏改会报“3V3 没连通”的**假警报**）
    - 配色：`3V3_IN` 取 ochre（与 VBAT / VBUS_IN / VBAT_OK 同族＝“能量”），`3V3` 保持红
    二、摆位（carrier_pcb.py）
    - 板 **44 × 32 mm**、4 个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
2026-10-18 固件：加板档 BOARD=bench|carrier（载板 = 心跳灯 PB0 + SE I2C2）
    问题：`board.h` 原来写死台架配置（心跳灯 PA15、SE I2C1）。而载板主控
    `CH32V203F8U6` 的 21 只脚里**没有 PA15**、也**没引出 I2C1** ⇒ 拿台架固件烧到载板上
    = 心跳灯不闪 + SE 全 NACK（看着像“固件坏了 / 片子坏了”，实际是档位错了）。
    做法
    - `Core/board.h`：新增 `BOARD_CARRIER`（0 = 台架，缺省 / 1 = 载板）
    · 载板：心跳灯 `PB0`（GPIOB + `RCC_APB2Periph_GPIOB`，仍低电平点亮）
    · `SE_I2C_USE_2` 的缺省值改成**跟板档走**；并加 `#error` 拦
    「BOARD=carrier 却显式给 SE_I2C=0」这种只改了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
2026-10-18 面包板：补上 SW1（SK-12D02VG3），3V3 与 3V3_IN 由此分开
    起因：`carrier-breadboard.fzz` 早于电源开关，图里 3V3 与 3V3_IN 被一根桥接线
    直接并在一起（`bb_probe` 报「分量里有 3V3 与 3V3_IN 的脚」= 短接），与网表
    `carrier_nets.py`（16 张网、SW1 串在中间）不一致。
    改动（只碰这一个草图）：
    - 删掉桥接线 `Wire90000078`（modelIndex 90000277，pin32F ↔ pin32E）
    - 加 `SW1` 实例：与 `BT1` 同样处理成**浮件**（板子下方右侧、不压孔），
    只用 1/2 两脚；3/4/5 是备用极，悬空
    - 加两根线：`SW1.1 → pin32F`（3V3 那侧，红 `#cc1414`）、
    `SW1.2 → pin32E`（3V3_IN 那侧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
2026-10-18 面包板图：跟着 SK-12D02VG3 的新面包板视图，更新 SW1 与两根线的几何
    `fritzing-parts-langhua` 那边已经把这只开关的面包板视图从「绿色转接板 + 2.54mm 排针」
    改成「**直接画本体 1:1 + 真实焊盘**（2.0mm 间距、最外 8.2mm）」——现实里没有那块
    转接板，是焊杜邦线用的。脚的相对位置因此变了：
    - 旧：loc + (9 + 9·k, 9) （2.54mm 排针，100 单位网格）
    - 新：loc + (PAD_Y[脚号]×3.5433, 0)，PAD_Y = pin5 −4.10 / pin1 −2.00 / pin2 0 /
    pin3 +2.00 / pin4 +4.10（mm）
    改动（只动几何，**连接关系一条没动**）：
    - `SW1` 的 `geometry` → (340, 200)（仍在板子下方、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
2026-10-18 面包板图：SW1 与两根线的端点按新 viewBox 口径重算（修错位）
    用户截图：两根线端点偏在 SW1 焊盘的左上。根因在零件侧 —— 面包板 svg 用了**负原点**
    `viewBox="-4.80 -2.70 …"`，而 Fritzing 的摆放口径是「**viewBox 的 min 角对齐 `loc`**」
    ⇒ 端点整体偏 (−4.80, −2.70) mm。零件那边已改成 `viewBox="0 0 9.60 7.90"`（见
    `fritzing-parts-langhua` 的 `3996627`）。
    本次（只动几何，连接关系一条没动）：
    - 脚位口径：`sketch = loc + (OX + PAD_X, OY) × 3.5433`，`OX/OY = 4.80/2.70`、
    `PAD_X` = pin1 −2.00 / pin2 0.00（mm）
    - SW1 仍在 (340, 200)；两根线起点改为焊盘中心：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
2026-10-18 闸门：把「面包板网表」与「面包板几何」都放进一键回归
    起因 = 用户 2026-10-18 那句话：「**你网表里接上就是接上了吗？！**」
    —— SW1 的线头悬在焊盘左上 5.51mm 时，`run_checks.py` 里**只有`file_sanity`（查线色）**
    这一道碰过 `carrier-breadboard.fzz`，而它当然看不出"线没碰到焊盘" ✗ ⇒ 全绿 ✗。
    新增两道（都在 `②c`，跨仓调库仓 tools ✓；找不到就**明确跳过** ✗ 不当通过 ✓）：
    - `bb_probe` = 网表层（`<connect>` / `<buses>`）—— 只能证明「我声明它接了」✓
    - `bb_precheck` = **几何层** —— ⑦ 导线端点 vs 引脚接线点 ≤ 0.10mm ✓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
2026-10-18 载板草图同批换 Resistor-0603 的 moduleId 引用（五色环改造连带）
    库仓把 Resistor-0603 改成五色环件（moduleId 尾缀 ResistorModuleID → 5BandResistorModuleID），
    改 moduleId = 改身份证 ⇒ 引用它的草图不改就认不出这些电阻。
    本仓 5 份草图各 6 处：carrier-board / carrier-breadboard / carrier-breadboard_byHand
    / carrier-pcb / carrier-schematic —— 只替换 moduleIdRef 与 path 里的整串名字，
    几何、连接、摆位一个字未动。
    （面包板预览 carrier-breadboard.{svg,png} 仍是旧的四色环渲染，需要时重跑 carrier_bb.py 即可。）
2026-10-19 carrier: 补入 carrier_route_atpad.py（允许在散热盘上打同网过孔的布线包装）
    U1（QFN20，0.4 mm 脚距）的中央散热盘 connector20 原厂名就叫 VSS，
    被自己那圈脚围死 —— 单网跑 GND 0/1（四墙都是邻脚净空，出口 0.076 mm < 一格 0.15）。
    行业做法是盘上打同网热过孔下到另一层，库仓 AGENTS §5 对散热盘已明确允许。
    pcb_route.py 只对 epad/fine 盘放行，而这只盘名字叫 VSS，
    所以这里用几何识别（pcb_check.epad_by_geometry）识别后置 VIA_AT_PAD=True。
    本身不参与 run_checks 闸门（是一次性布线辅助脚本），与 carrier/ 下其它生成器一起入库留档。
2026-10-19 .gitignore: *.bak -> *.bak*（挡住 .bak-<标签> 的手工备份）
    carrier/ 下留了三个手工改图的历史版本：
    carrier-breadboard.fzz.bak-holes / .bak-sw1 / .bak-swgeom
    它们带后缀，旧规则 *.bak 匹配不到，于是长期挂在 git status 的未跟踪列表里。
    规则放宽为 *.bak*，并就近写了一行说明。原 *.bak 的语义保持不变（是它的子集）。
    三个文件已移出工作区（备份在 %TEMP%\orpah_bak_<时间>\），不再出现在未跟踪列表。
2026-10-19 checks: 重跑闸门报告（22 道 PASS / 0 未过）
    本轮审查时跑了 tools/run_checks.py，报告随之更新。
    把工作区路径的大小写差异（f:\git\… vs F:\git\…，Windows 盘符随机化）归一后，
    与上一版的实质差异只有「跑的时间」一行，结论未变：
    PASS 22 道闸门，0 道未过；skip 1 道（台架判据，要接板子 ⇒ 用 --bench）
    ★ 另一处前次审查发现、本轮记在这里备查：
    上一份报告（10-18）里 MCU.VDDA 那条网的备注写的是 R1.connector0，
    本份写的是 R2.connector0 —— 与 540efe5（换 Resistor-0603 moduleId）之后的重排相符。
    网表闸门只判「这个网连着」，不判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
